robinrehbein/tangara/TEILE.md

# Teile und Schnittstellen

Gemeinsame Grundlage für Firmware, CAD und Platinen. Maße in mm. Werte mit „(prüfen)“ sind aus dem Gedächtnis und müssen gegen Datenblatt oder Herstellerseite geprüft werden.

## Phase-1-Prototyp

| Teil | Auswahl | Hinweis |
|---|---|---|
| Hauptboard | Waveshare ESP32-S3-Touch-AMOLED-1.8 | 1,8" AMOLED 368 × 448 (QSPI), geprüft: V1 SH8601 + FT3168, **V2 (seit 30.05.2026 lieferbar) CO5300 + CST820**; PMU AXP2101, Codec ES8311 mit NS4150B -> **nur Onboard-Lautsprecher, kein Kopfhörerausgang**, IMU QMI8658, RTC PCF85063, IO-Expander TCA9554, TF-Slot. Maße laut Wiki-Zeichnung **37,6 × 45,2 × 15,0** (mit Gehäuse; nackte Platine ungeprüft). Pads 1,27 mm: VBUS, GND, 3V3, GND, TXD, RXD, **SCL = GPIO14, SDA = GPIO15** (geteilter Bus, 2,2 kΩ Pull-ups onboard), GPIO17, 18, 38–42, USB D−/D+ = GPIO19/20. Klickrad-Vorschlag: INT = GPIO17, BTN = GPIO18. Keine Adresskollision mit 0x5A/0x5B. Details und Quellen: `docs/RECHERCHE.md`. |
| Klickrad-Modul | eigene Platine, siehe unten | Anschluss an die Waveshare-Pads: 3V3, GND, SDA = GPIO15, SCL = GPIO14, INT = GPIO17, BTN = GPIO18; I²C-Pull-ups liegen schon auf dem Board, auf dem Modul nicht bestücken |
| LRA | X-Achsen-LRA, 2–3 Typen zum Vergleichen | Bauform und Resonanzfrequenz je Typ notieren. Kandidaten: 4,5 × 12 × 3,0 (235 Hz), 9,5 × 9,5 × 3,5 (170 Hz), 8 × 15 × 3,0 (170 Hz), Herstellerangaben, siehe `docs/EINKAUFSLISTE.md` |
| Akku | LiPo 1S mit Schutzschaltung, Stecker passend zum Waveshare-Board (geprüft: MX1.25, 2-polig; Polung am Board prüfen) | Größe nach Gehäuse; Waveshare empfiehlt 3,85 × 24 × 28 mm, 400 mAh |
| Gehäuse | Prototyp-Gehäuse v1 (FDM-Druck) | Display oben, Klickrad unten, Hochformat |

## Klickrad-Modul (eigene Platine)

Runde Platine, die Touch-Rad, Mitteltaste und Haptik vereint. Der LRA sitzt direkt auf der Rückseite, damit der Tick genau unter dem Daumen spürbar ist.

**Mechanik**
- Platine rund, **Ø 32 mm**, Dicke 1,0 mm, **4 Lagen** (v1; **v2: 2 Lagen, 0,8 mm**, siehe Abschnitt „Klickrad v2 (Stand)“)
- Touch-Segmente vorne: Ring von **r = 6,5 bis r = 12,8 mm**, 8–12 Segmente
- Mitteltaste vorne: SMD-Taster mittig, max. 4 × 4 mm, Höhe ≤ 1,5 mm
- 3 Befestigungslöcher Ø 2,2 mm auf **r = 14,6 mm** bei 90°, 210° und 330° (0° = rechts, gegen den Uhrzeigersinn)
- Rückseite: Bauteile max. 1,5 mm hoch, plus LRA (aufgeklebt, Lötpads für die Litzen)
- Abdeckung vorne (gedruckt): Ø 30 mm, liegt direkt auf der Platine

- Stecker J1 auf der Rückseite bei 270° (unten): x ±4,9, y −14,7 … −8,1 relativ zur Modulmitte, höher als 1,5 mm (Höhe prüfen)
- LRA-Freifläche auf der Rückseite: x −8 … +8, y +3 … +9; LRA-Lötpads bei x ≈ −12,3
- 12 Segmente à 30°. Zuordnung (Mittenwinkel gegen den Uhrzeigersinn ab rechts, von vorne gesehen): ELE8 15°, ELE7 45°, ELE6 75°, ELE5 105°, ELE4 135°, ELE3 165°, ELE2 195°, ELE1 225°, ELE0 255°, ELE11 285°, ELE10 315°, ELE9 345°. Firmware: Segment 0 bei 105° (Bildschirmkonvention, im Uhrzeigersinn). Am echten Rad prüfen.

**Elektrik**
- Touch-Controller: **v2: AT42QT2120 (I²C 0x1C, Wheel-Modus) nach Tangara-Vorbild**; v1 nutzte MPR121 (0x5B)
- Haptik-Treiber: DRV2605L (I²C, Adresse 0x5A fest), LRA-Modus
- Mitteltaste: nach GND, Pull-up auf der MCU-Seite

**Änderung für das dünne Endgerät (Entscheidung nach `docs/DUENNBAU.md`):** JST-SH ist mit ca. 4 mm zu hoch. Klickrad v2 und Hauptplatine bekommen den **FFC-Stecker Molex 503480-0600** (0,5 mm, 6-pol., ca. 1,0 mm hoch, Bottom Contact) mit derselben Pinbelegung; Kabel Standard-FFC Typ A, sofern die Ausrichtung passt. Der LRA-Ausschnitt in der Hauptplatine ist Standard (LRA bis 3,0 mm); am Waveshare-Prototyp über eine FFC-Breakout-Platine. Mitteltaste v2 **kapazitiv** (AT42QT2120 Key 3), Pin 6 wird Reserve. Platine 0,8 mm, Rückseitenbauteile ≤ 0,8 mm, flacher LRA (z. B. Vybronics VL120628H, 12 × 6 × 2,0, prüfen), Abdeckung 0,6-mm-FR4.

**Stecker v1: JST-SH 1,0 mm, 6-polig** (v2: FPC/FFC, gleiche Belegung)

| Pin | Signal |
|---|---|
| 1 | 3V3 |
| 2 | GND |
| 3 | SDA |
| 4 | SCL |
| 5 | INT / CHANGE (AT42QT2120 bzw. MPR121, open drain, aktiv low) |
| 6 | BTN (Mitteltaste, aktiv low) |

DRV2605L-EN fest auf 3V3; Standby per I²C.

## Endgerät: Ziel-Maße (Entscheidung 2026-10-04: größer und dicker, damit die Hauptplatine routbar wird)

Der Entwurf mit 8,5 mm (`docs/DUENNBAU.md`, Variante A) hatte zu wenig Platinenfläche (1648 mm² verfügbar gegen 1824 mm² benötigt) und ließ die Hauptplatine nicht routen. Neues Ziel:

| Punkt | Entscheidung |
|---|---|
| Außenmaße | **ca. 44 × 100 × bis 10 mm** (Dicke genau festlegen, wenn die Bauteilhöhen feststehen) |
| Hauptplatine | ca. 41 × 97 mm, Dicke 1,0 mm (0,8 mm nur, wenn nötig), 4 Lagen, wenn das Routing es nicht verlangt sonst 6 Lagen |
| Display | **2,06" AMOLED 410 × 502, CO5300, QSPI** (ca. 315 ppi); mit Deckglas, Luft darunter ≥ 1,1 mm |
| MCU-Modul | ESP32-S31-WROOM-1 (18 × 25,5 × 3,1) oder -WROOM-3, wie es das Layout braucht; **Antenne darf nicht über die Platinenkante hinausragen** |
| Klinke | SJ-3506-SMT wie Tangara (6,0 mm) oder SJ-43504-SMT-TR (5,0 mm), keine Sonderlösung nötig |
| Akku | Pouch bis ca. 4,5 mm dick, größte Standardzelle, die neben dem LRA passt (Ziel ≥ 600 mAh) |
| LRA | X-Achse bis 3,0 mm, Ausschnitt in der Hauptplatine unter dem Klickrad |
| Klickrad | Platine Ø 32 mm, Abdeckung 0,6-mm-FR4 wie Tangara, Stecker Molex 503480-0600 |
| Front/Rückseite | Front 0,8-mm-Acryl oder Glas, Rückwand gedruckt oder FR4 |

## Endgerät (erster Entwurf, siehe `hardware/render/explosionsmodell.html`)

| Teil | Maße |
|---|---|
| Gehäuse außen | 42 × 95 × 12,2, Ecken r = 7, Wand 1,4, Trennfuge bei z = 6 |
| Display-Fenster | 30,2 × 36,7, Mitte bei y = +21 (Gehäusemitte = 0) |
| Klickrad-Öffnung | Ø 30,6, Mitte bei y = −27 |
| Klickrad-Abdeckung | Ø 30 / Ø 11,6, 1,95 dick |
| Hauptplatine | 38 × 89 × 1,0, Ecken r = 5 |
| Akku | ca. 34 × 40 × 4,6 (Platzhalter) |
| Schrauben | 4 × M2, bei (±15, ±40), Gewindeeinsätze im Innenrahmen |

**Abweichungen im CAD-Entwurf** (Details: `hardware/cad/README.md`)
- Ein/Aus-Taste auf z = 9,2 statt 10,3 (sonst zu dünne Wand über der Öffnung)
- Oberschale ohne Schraubdome (Display belegt die Stellen), Halt über Innenrahmen und 4 Rastnasen; ungeprüft
- Klickrad-Platine im Endgerät vorerst mit Distanzring und Klebeband. Offen: 3 Aussparungen in der Hauptplatine für eine Verschraubung.

## Hauptplatine Endgerät: festgelegte Chips

Grundsatz: so viel wie möglich vom Vorbild Tangara übernehmen (Hardware CERN-OHL-S-2.0, Firmware GPL-3.0; lokale Kopie für die Arbeit unter `/home/user/tangara-ref/`, nicht im Repo).

| Funktion | Chip | Herkunft |
|---|---|---|
| MCU, WLAN 6, Bluetooth Classic + LE Audio, USB-HS-OTG | ESP32-S31-WROOM-1 (3,1 mm hoch, 16 MB PSRAM; Pins prüfen), sonst WROOM-3 | neu (Tangara: ESP32-WROVER-E) |
| DAC + Kopfhörerverstärker (Class H) | **Cirrus CS43131** (QFN-40, 0,8 mm hoch), 22,5792-MHz-Quarz am DAC, DAC ist I²S-Master; Plan B: CS43198 + OPA1622 | neu, Begründung in `docs/AUDIO.md` (125 dB Dynamik statt ca. 105 dB, ca. 70 mW weniger Ruheverbrauch) |
| 1,8 V für den DAC | LDO, ca. 60 mA Reserve | neu |
| Klinkenbuchse | SJ-43504-SMT-TR (5,0 mm hoch), in Randausschnitt der Platine; ESD D5V0L2B3T-7 wie Tangara | angepasst (Tangara: SJ-3506-SMT, 6,0 mm) |
| LiPo-Lader mit Power-Path | MCP73871 | Tangara |
| 3V3 | TLV75533 | Tangara |
| USB-C-Buchse | USB4510-03-1-A | Tangara |
| USB-Audio-Host (Rollenumschaltung, 5 V) | TUSB320LAI, TPS61023, TPS2553 | neu |
| Akkustand | MAX17048 (I²C 0x36) | neu (bei Tangara über den SAMD21) |
| Touch-Rad (Klickrad-Modul v2) | AT42QT2120 (I²C 0x1C) | Tangara |
| Haptik (Klickrad-Modul) | DRV2605L (I²C 0x5A) | Tangara |

Nicht übernommen: SAMD21-Co-Prozessor und SD-Multiplexer (der S31 hat selbst USB), Display ST7735 (wir nutzen das 1,8"-AMOLED).

## Bestellstatus

Noch nichts bestellt.

**Dicke (Entscheidung):** Ziel **bis 10 mm** (statt 11 mm). Stapel: Front 0,8 + Display ca. 1,3 + Luft ≥ 1,1 + Platine 1,0 + Akku + Rückwand ca. 1 mm. Dafür Akku eher ≤ 4,0 mm und Klinke 5,0 mm (SJ-43504-SMT-TR). Prüfen, sobald die Bauteilhöhen feststehen; reicht es nicht, wird das hier begründet geändert.

## Klickrad v2 (Stand 2026-10-04, ersetzt widersprüchliche Angaben oben)

Fertig in `hardware/pcb/klickrad/` (ERC 0, DRC 0 Fehler, nichts gebaut oder gemessen). Maßgeblich gegenüber den v1-Angaben im Abschnitt „Klickrad-Modul“:

- Ø 32 mm, **2 Lagen, 0,8 mm** (v1: 4 Lagen, 1,0 mm)
- Touch **AT42QT2120, I²C 0x1C**, Wheel-Modus: Key 0–2 Wheel, Key 3 kapazitive Mitte (r 2,5 mm), Key 4 Guard. Wheel-Position 0 oben, steigend gegen den Uhrzeigersinn; Stecker bei 270° = Position 128 (aus Tangara-Footprint gerechnet, nicht gemessen). **Firmware-Konvention und Segment-Offset daran anpassen.**
- Haptik DRV2605L (0x5A), LRA-Freifläche 16 × 6 mm, Mitte 6 mm über der Radmitte, LRA bis 3,0 mm; LRA-Pads TP1/TP2 auf der **Ostseite**
- Stecker Molex 503480-0600 auf der Rückseite bei 270°, Pin 6 offen, I²C-Pull-ups nicht bestückt
- Rückseitenbauteile bis 1,1 mm (U2 DRV2605L VSSOP-10), Stecker 1,0 mm; damit über der 0,8-mm-Vorgabe
- Abdeckung: eigenes Projekt `abdeckung/`, 0,6 mm FR4, Ø 30
- Ein 10 × 10 × 1,0-LRA passt in dieser Revision nicht

## Hauptplatine Endgerät: Stand 2026-10-05, Rev. 3b (maßgeblich, aus `hardware/pcb/hauptplatine/README.md`)

41 × 97 × 1,0 mm, 4 Lagen, Ecken r = 4, DRC/ERC 0. Maße für das Gehäuse (Platinenmitte = 0, Blick von vorn): Klickrad-Mitte (0, −25); LRA-Ausschnitt 14 × 10 mm um (0, −19); Klinke SJ-43504 x = −12 (Randschlitz 6,8 mm); USB-C x = +9 (Ausschnitt 9,24 × 6 mm); WROOM-1 Rückseite Mitte (6,5; 37,5), Antennen-Keepout x 12,9…20,5, y 28,2…46,8; microSD Mitte (−13,7; 37,5), Einschub von links; Klickrad-Stecker J21 (0; −46,2); Display-Stecker J20 = Molex 5034803000 (0; −0,65), Körper x ±8,35, y −2,4…+1,7, 1,0 mm hoch (Rev. 3b: ersetzt Hirose FH12-30S-0.5SH(55), laut Digi-Key 2,0 mm hoch, Review H4; Footprint-Nagelpads ungeprüft); SW1 Rückseite (15; −30); neu SW2 (BOOT) Rückseite (−18,05; 16,0) und SW3 (EN) Rückseite (−18,05; 9,0), von hinten zu drücken (Rückwand braucht dort Löcher, Review H8); Akku-Anschluss (−12,5; 28,8); Befestigungslöcher Ø 1,8 bei (−18,2; 46,2), (18,2; −46,2), (−18,2; −46,2); Akkufach Rückseite x −16…16, y −12…26,5. Rückzone bei 10 mm Gerätedicke 4,05 mm (Zelle höchstens ca. 3,7 mm). Teile über 3 mm: nur Klinke, USB-C, Modul.

## Nachtrag Klickrad J1 (2026-10-05)

J1 nutzt jetzt das Landmuster von J21 der Hauptplatine (Molex 503480-0600, Signalpads 0,3 × 0,7, Nagelpads 0,8 × 1,0 bei x ±2,045), ungeprüft gegen die Molex-Zeichnung. J1 sitzt bei (0; −10,8) auf der Klickrad-Rückseite, Kabelmündung nach Süden, Pin 1 bei x +1,25; Pin 1 ↔ Pin 1 ohne Kreuzung, Kabel gerade (Typ A oder B), Mündungen 6,4 mm auseinander (nicht 3,5 mm). LRA-Freifläche jetzt 14 × 6 mm (x ±7): der 8 × 15 × 3,0-LRA oben passt nicht mehr; zulässig sind LRAs bis ca. 13 × 9 × 3 mm laut CAD. Der Text im Hauptplatine-README zum Klickrad-Anschluss (Mündung nach unten) ist teilweise überholt.
