robinrehbein/tangara/hardware/render/explosionsmodell.html

# Nano-Player Explosionsmodell · Endgerät v3

Endgerät v3: 44 × 100 × 10 mm iPod nano 5. Gen.: 38,7 × 90,7 × 6,2 mm Display: 2,06" AMOLED, 410 × 502

Vorne Schräg Seite Hinten

Ziehen zum Drehen · Scrollen oder Zwei-Finger zum Zoomen · Teil antippen für Details

Zerlegen

55 %

Zusammenbauen Ganz zerlegen Alle zeigen

Gehäusefarbe

Teile

Stand v3 für Hauptplatine Rev. 3b und Klickrad J1 (2026-10-05, ungeprüft an Hardware). Rahmen, Rückwand, Frontplatte und Abdeckung sind die echten STL aus dem CAD; alle anderen Teile sind Blöcke aus den Maßen in params.py. Details: README.md.
