robinrehbein/tangara/hardware/cad/vorschau/endgeraet_distanzring.png

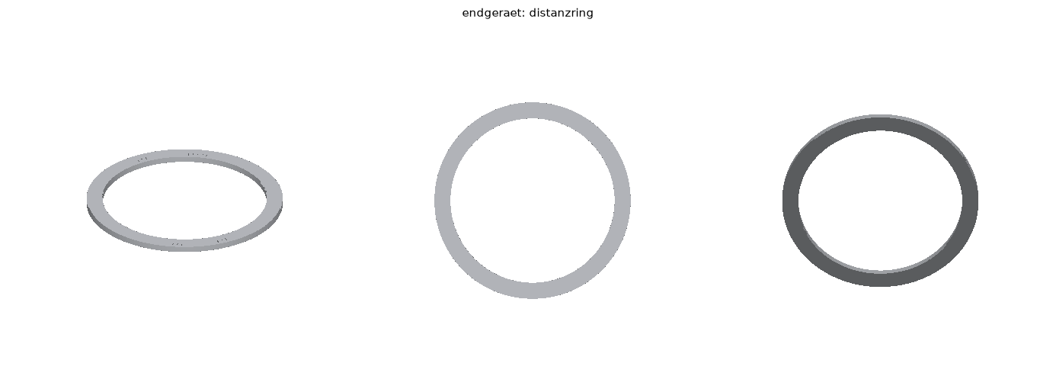
hardware/cad/vorschau/endgeraet_distanzring.png
