robinrehbein/tangara/hardware/cad/vorschau/endgeraet_explosion.png

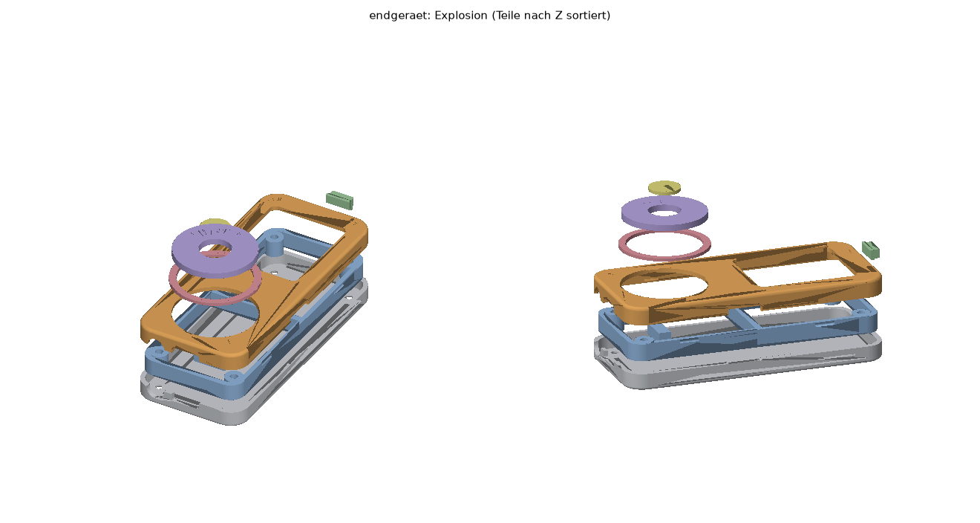
hardware/cad/vorschau/endgeraet_explosion.png
