robinrehbein/tangara/hardware/cad/vorschau/endgeraet_innenrahmen.png

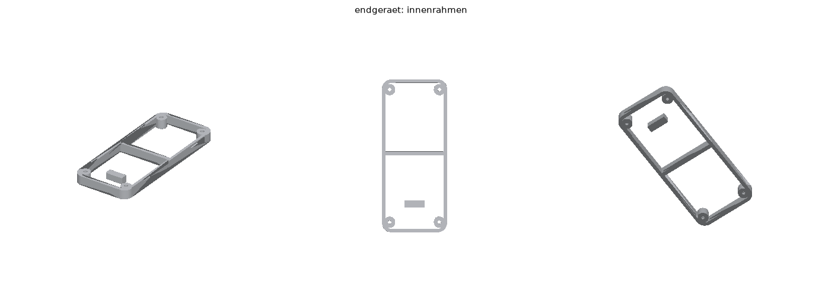
hardware/cad/vorschau/endgeraet_innenrahmen.png
