robinrehbein/tangara/hardware/cad/vorschau/endgeraet_power_taste.png

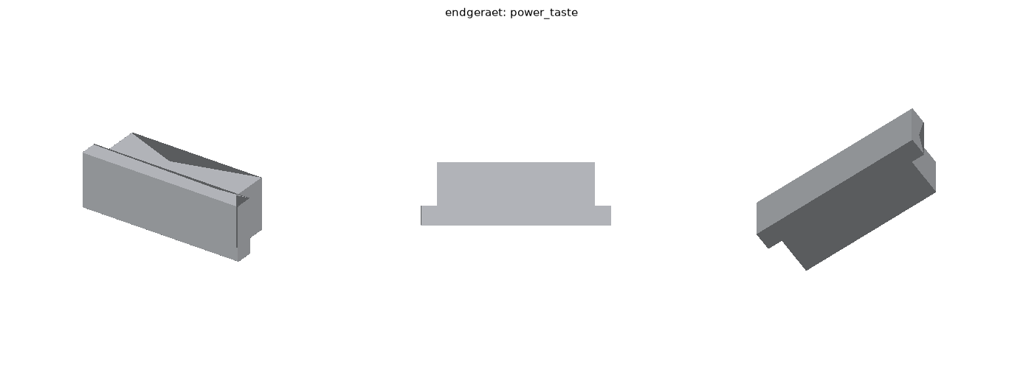
hardware/cad/vorschau/endgeraet_power_taste.png
