robinrehbein/tangara/hardware/cad/vorschau/endgeraet_v2_explosion.png

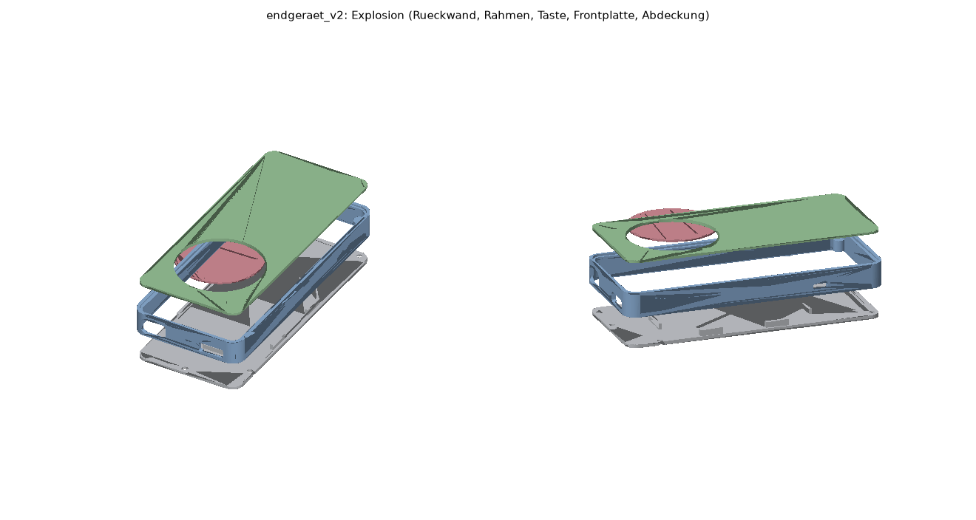
hardware/cad/vorschau/endgeraet_v2_explosion.png
