robinrehbein/tangara/hardware/cad/vorschau/endgeraet_v2_schnitt.png

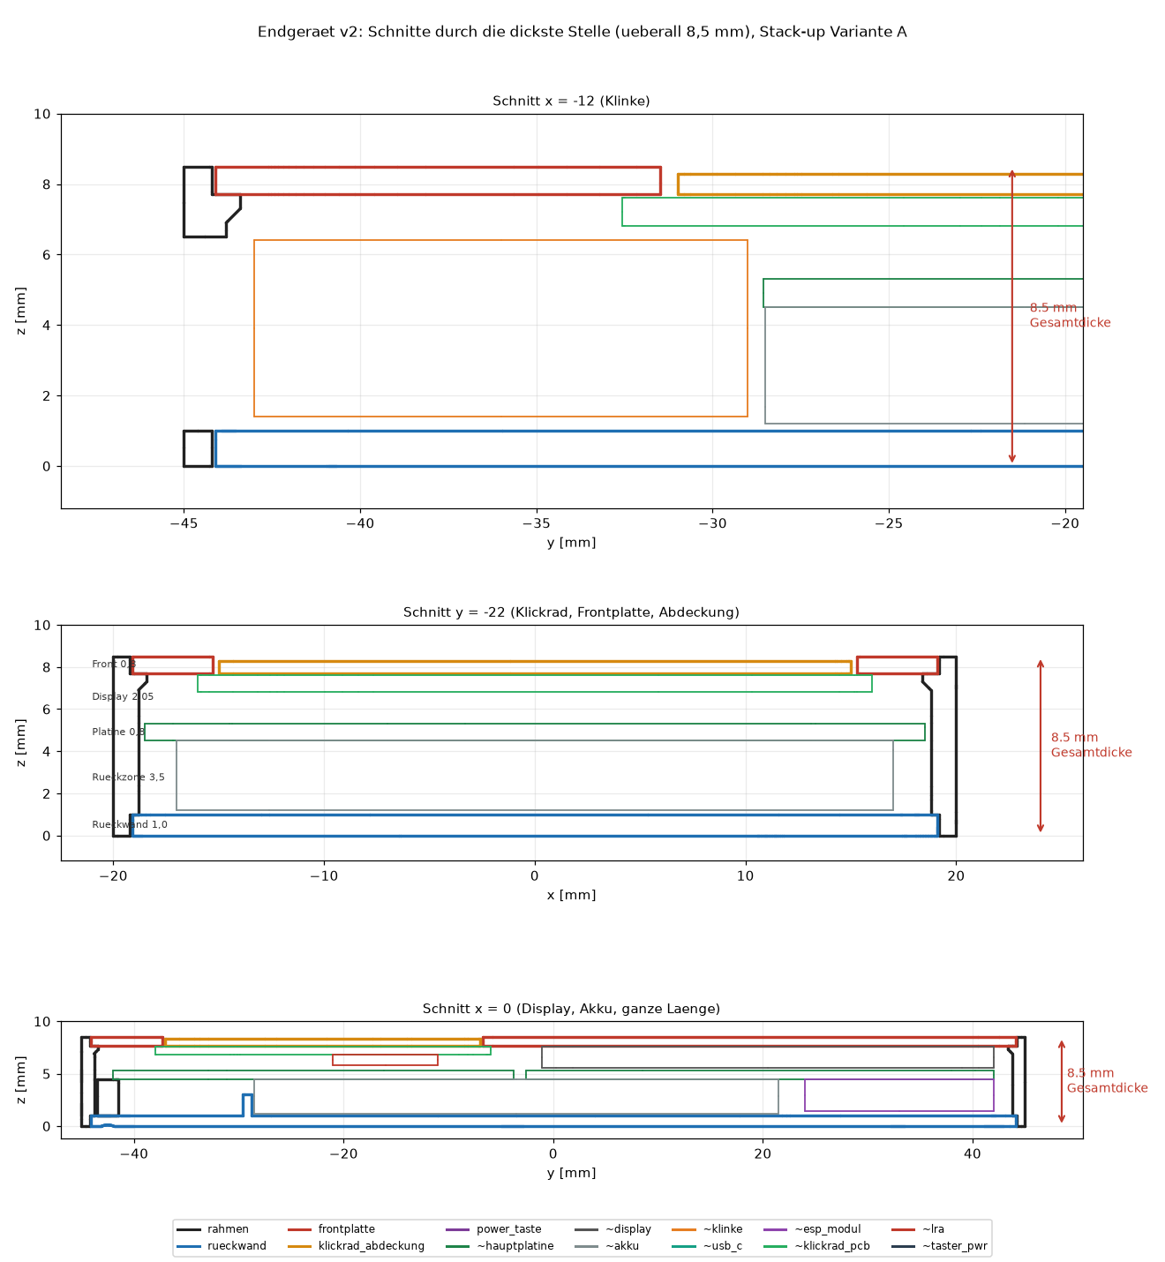
hardware/cad/vorschau/endgeraet_v2_schnitt.png
