robinrehbein/tangara/hardware/cad/vorschau/endgeraet_v2_zuschnitt_dxf.png

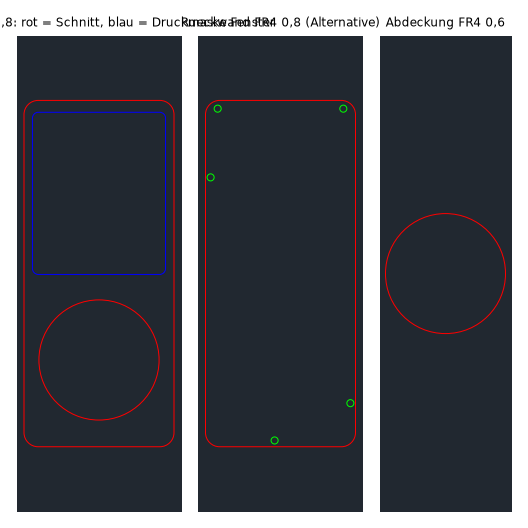
hardware/cad/vorschau/endgeraet_v2_zuschnitt_dxf.png
