robinrehbein/tangara/hardware/cad/vorschau/endgeraet_v3_rueckwand_hinten.png

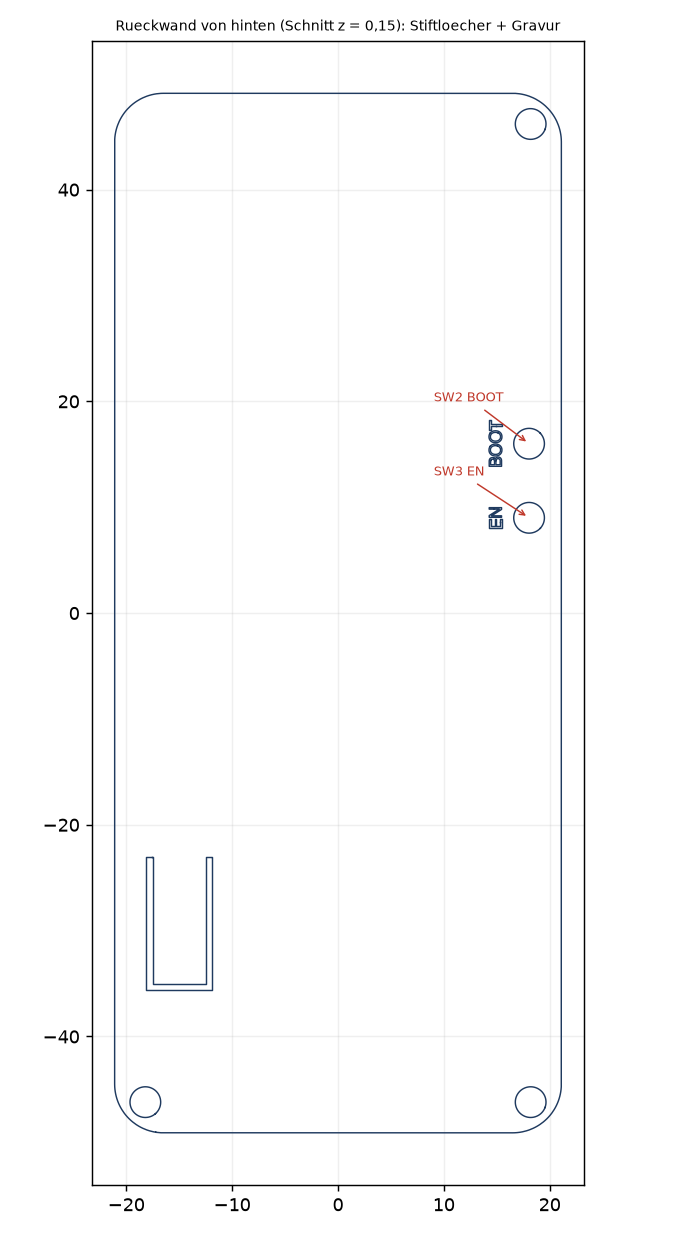
hardware/cad/vorschau/endgeraet_v3_rueckwand_hinten.png
