robinrehbein/tangara/hardware/cad/vorschau/endgeraet_v3_schnitt.png

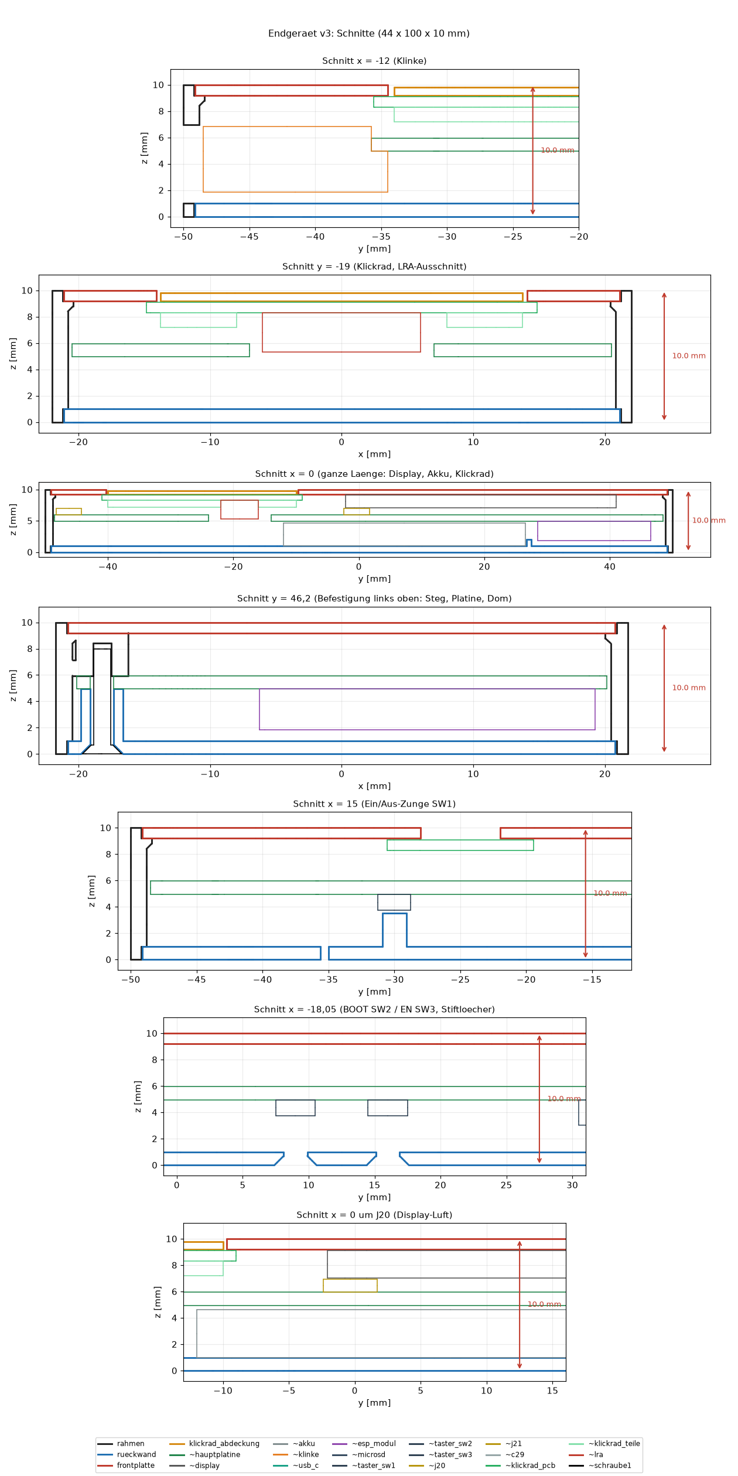
hardware/cad/vorschau/endgeraet_v3_schnitt.png
