robinrehbein/tangara/hardware/cad/vorschau/endgeraet_v3_zuschnitt_dxf.png

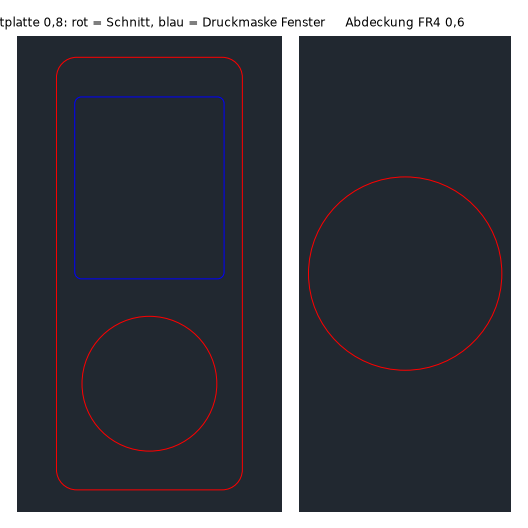
hardware/cad/vorschau/endgeraet_v3_zuschnitt_dxf.png
