robinrehbein/tangara/hardware/cad/vorschau/endgeraet_zusammenbau.png

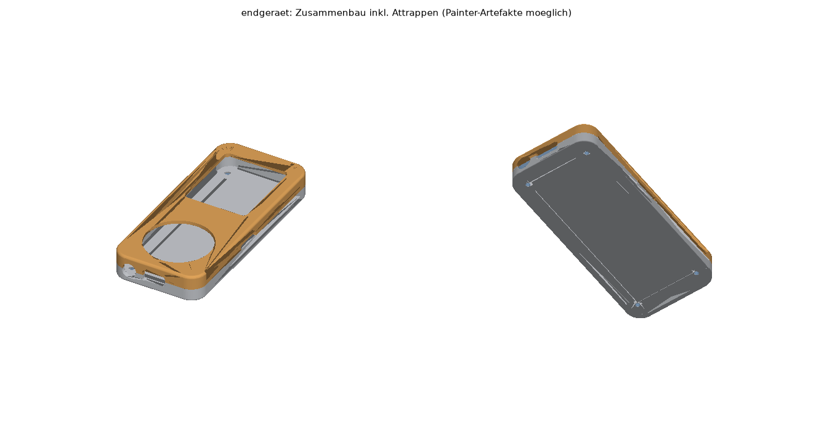
hardware/cad/vorschau/endgeraet_zusammenbau.png
