robinrehbein/tangara/hardware/cad/vorschau/prototyp_explosion.png

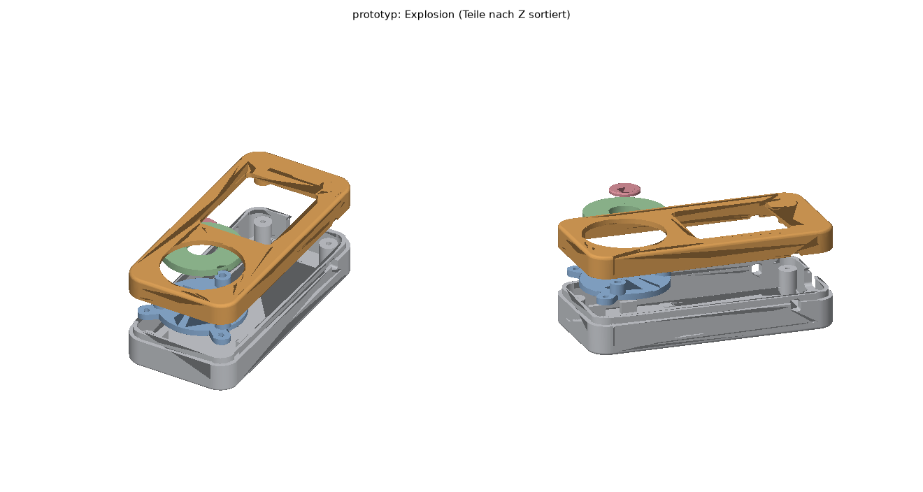
hardware/cad/vorschau/prototyp_explosion.png
