robinrehbein/tangara/hardware/cad/vorschau/prototyp_klickrad_halter.png

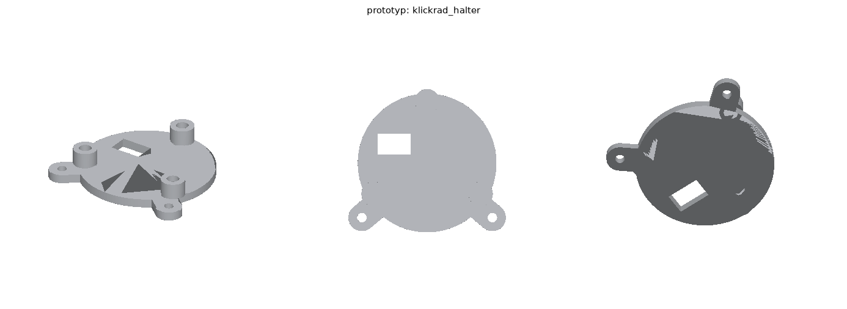
hardware/cad/vorschau/prototyp_klickrad_halter.png
