robinrehbein/tangara/hardware/pcb/hauptplatine/vorschau/oberseite_2d.png

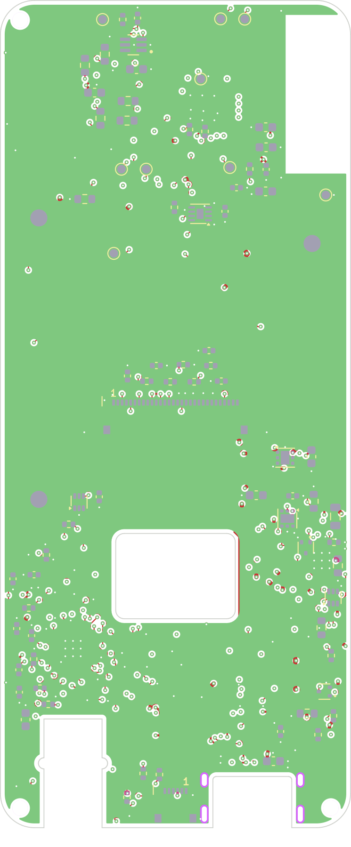
hardware/pcb/hauptplatine/vorschau/oberseite_2d.png
