robinrehbein/tangara/hardware/pcb/hauptplatine/vorschau/oberseite_3d.png

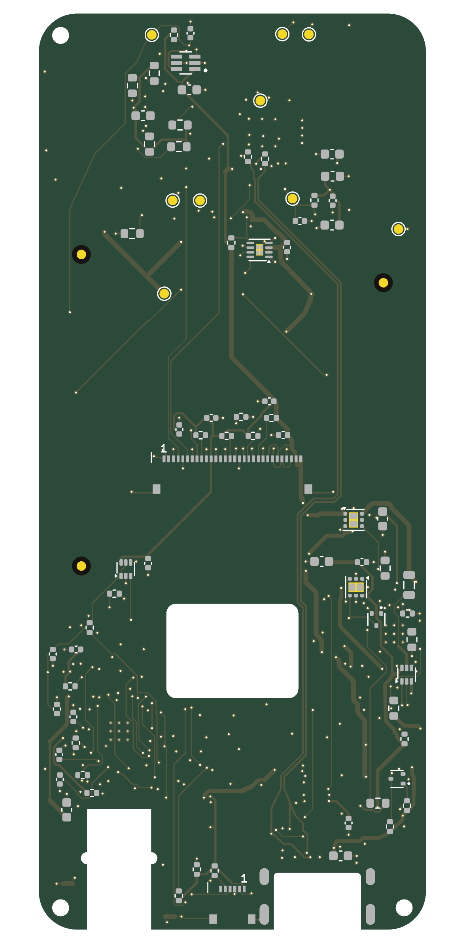
hardware/pcb/hauptplatine/vorschau/oberseite_3d.png
