robinrehbein/tangara/hardware/pcb/hauptplatine/vorschau/unterseite_2d.png

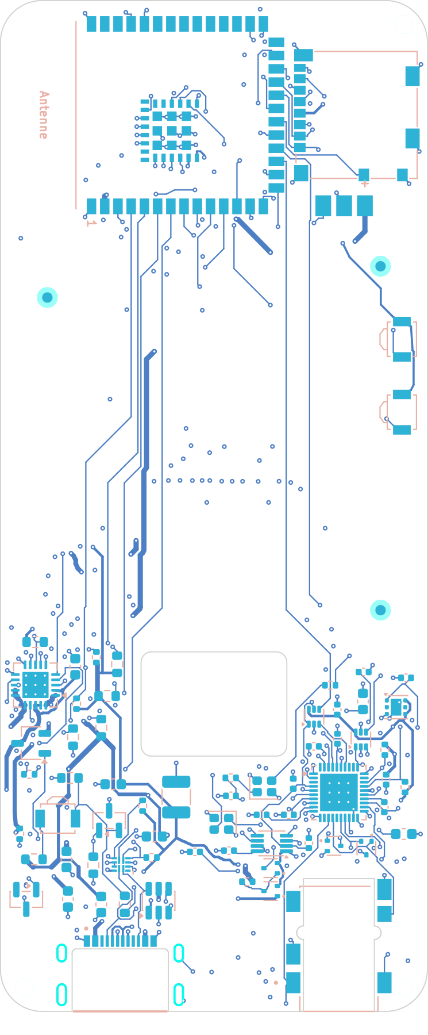
hardware/pcb/hauptplatine/vorschau/unterseite_2d.png
