robinrehbein/tangara/hardware/pcb/hauptplatine/vorschau/unterseite_3d.png

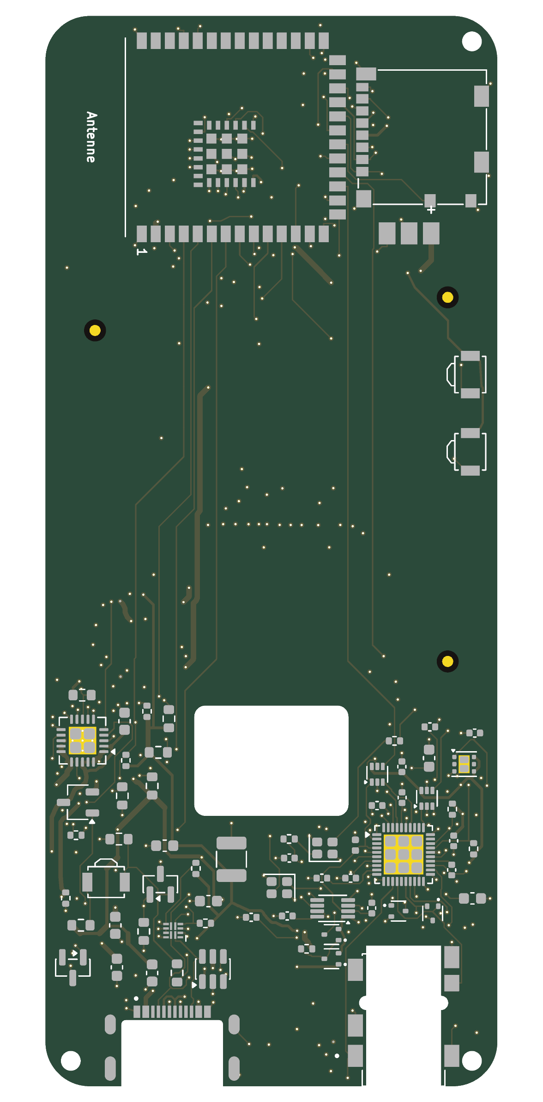
hardware/pcb/hauptplatine/vorschau/unterseite_3d.png
