robinrehbein/tangara/hardware/pcb/klickrad/abdeckung/vorschau/abdeckung.png

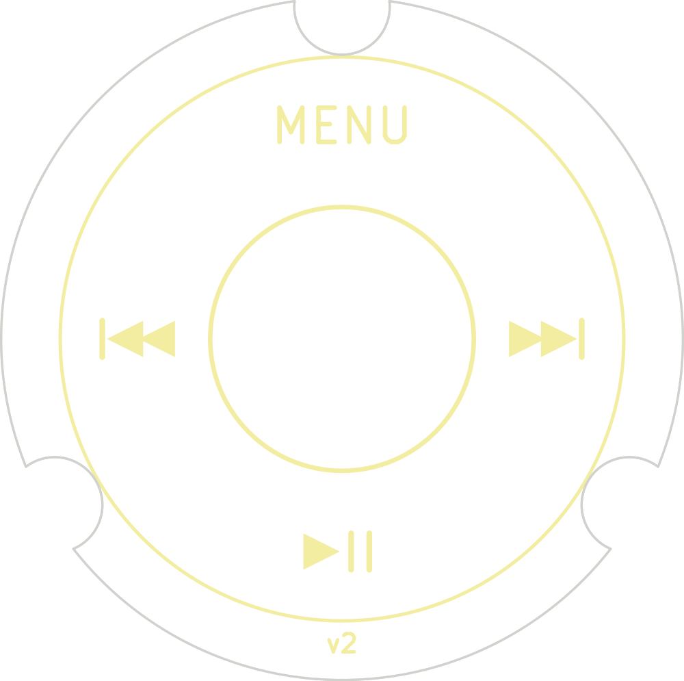
hardware/pcb/klickrad/abdeckung/vorschau/abdeckung.png
