robinrehbein/tangara/hardware/pcb/klickrad/vorschau/3d_hinten.png

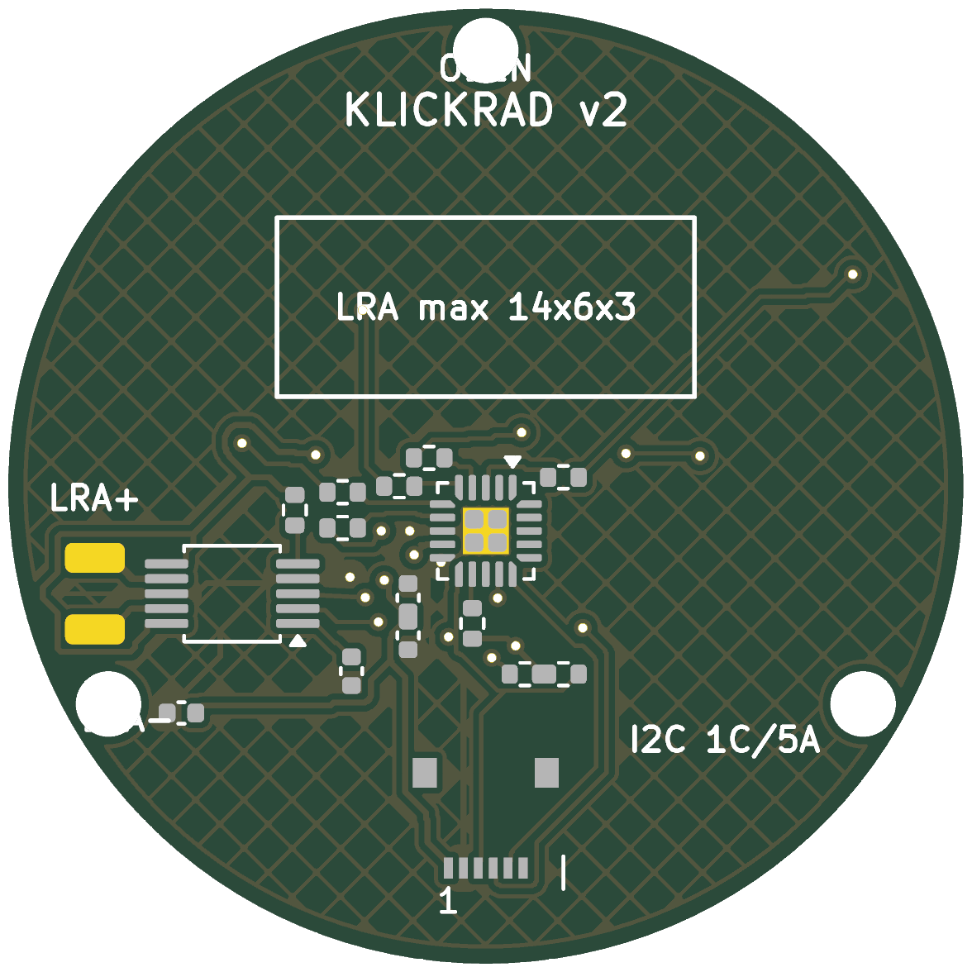
hardware/pcb/klickrad/vorschau/3d_hinten.png
