robinrehbein/tangara/hardware/pcb/klickrad/vorschau/3d_vorne.png

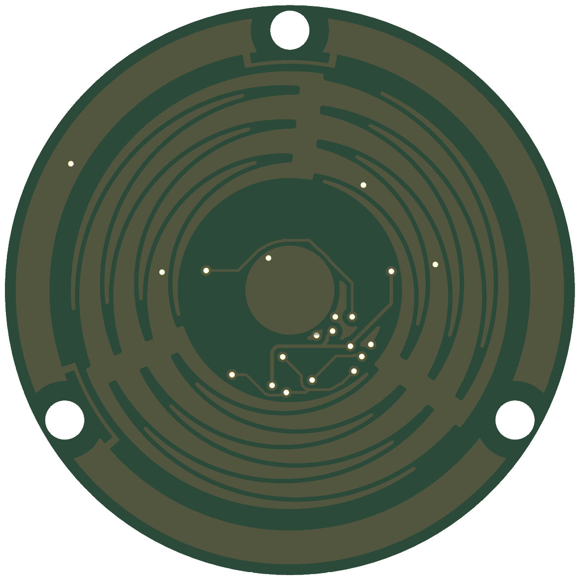
hardware/pcb/klickrad/vorschau/3d_vorne.png
