robinrehbein/tangara/hardware/pcb/klickrad/vorschau/kupfer.png

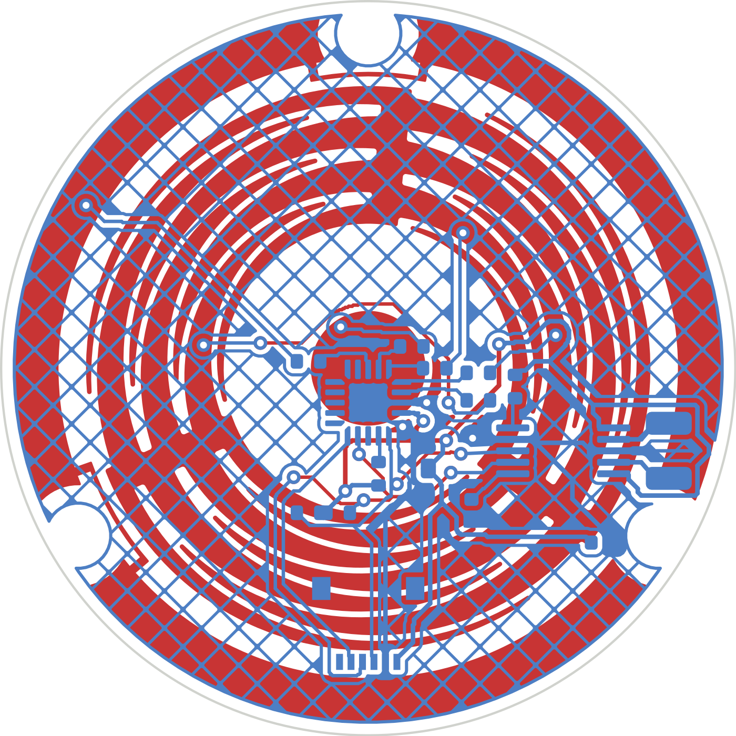
hardware/pcb/klickrad/vorschau/kupfer.png
