robinrehbein/tangara/hardware/pcb/klickrad/vorschau/rueckseite.png

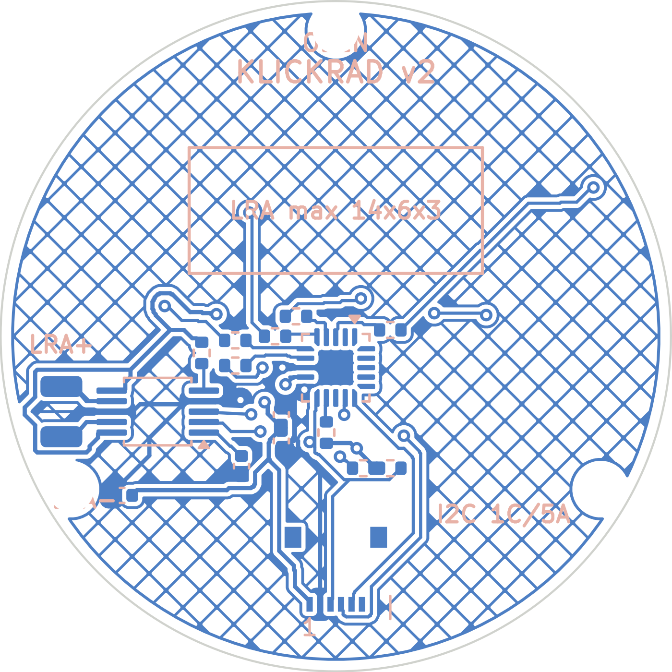
hardware/pcb/klickrad/vorschau/rueckseite.png
