robinrehbein/tangara/hardware/pcb/klickrad/vorschau/schaltplan.png

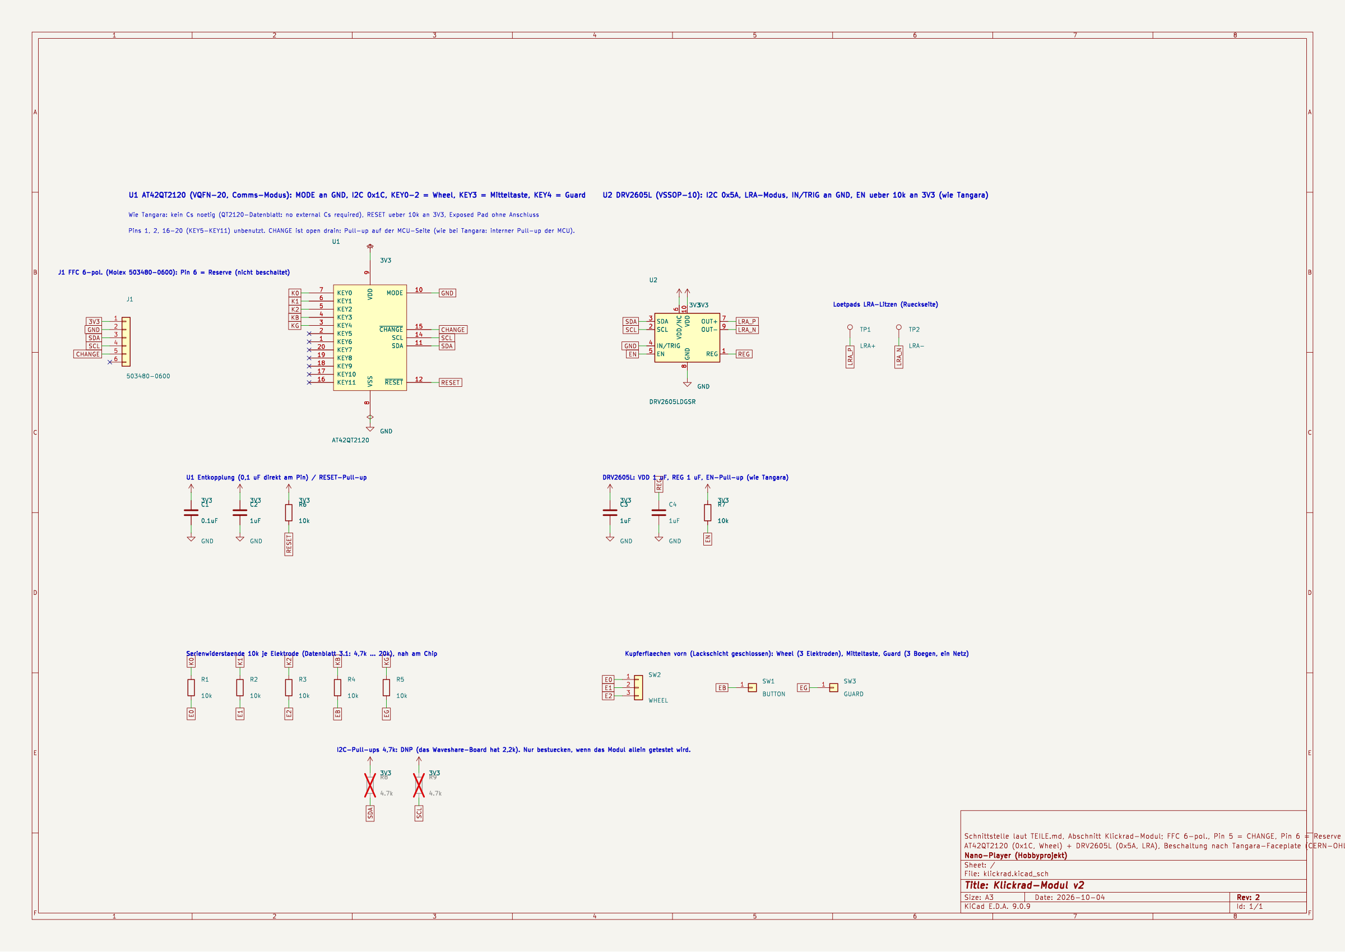
hardware/pcb/klickrad/vorschau/schaltplan.png
