robinrehbein/tangara/hardware/render/vorschau/explodiert.png

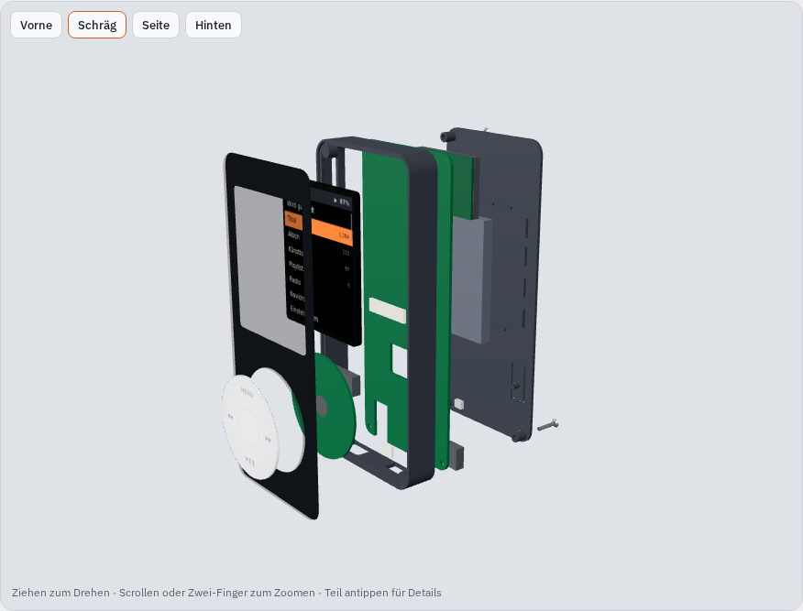
hardware/render/vorschau/explodiert.png
