robinrehbein/tangara/hardware/render/vorschau/explodiert_hinten.png

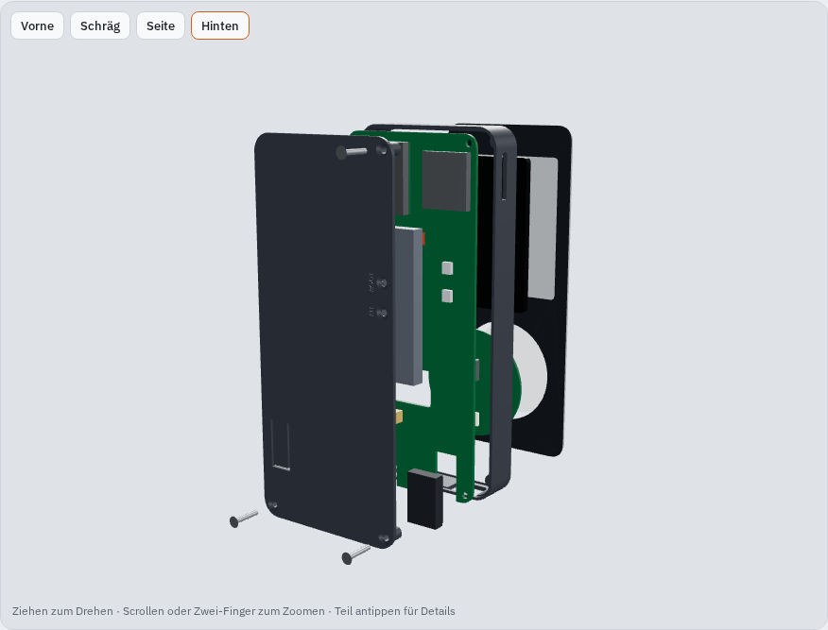
hardware/render/vorschau/explodiert_hinten.png
