robinrehbein/tangara/hardware/render/vorschau/explodiert_seite.png

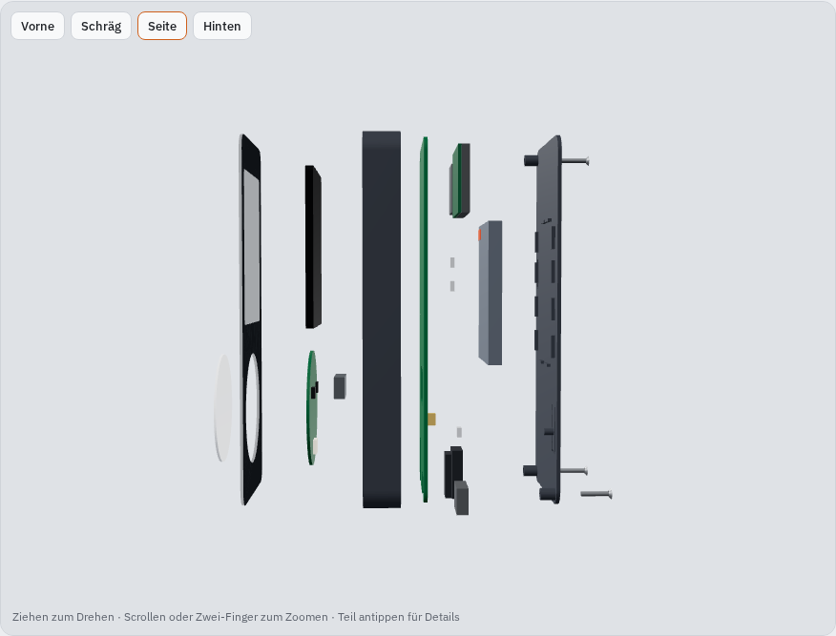
hardware/render/vorschau/explodiert_seite.png
