robinrehbein/tangara/hardware/render/vorschau/farbe_orange.png

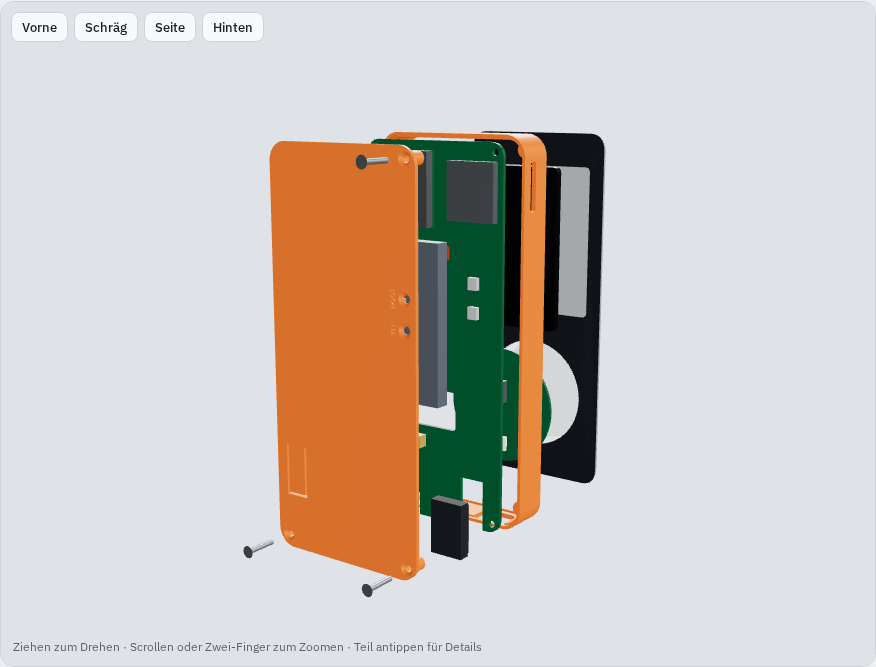
hardware/render/vorschau/farbe_orange.png
