robinrehbein/tangara/hardware/render/vorschau/teil_gewaehlt.png

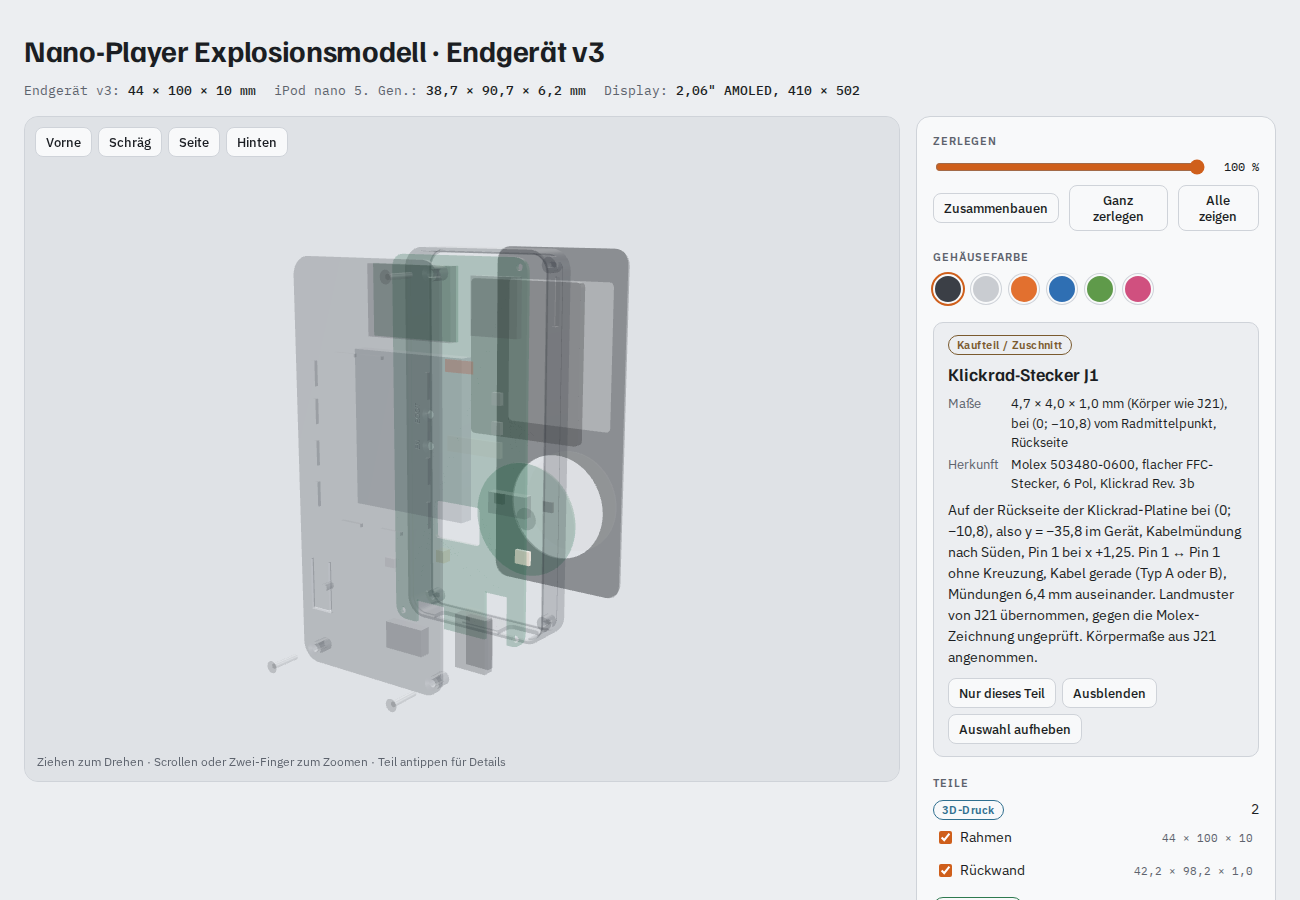
hardware/render/vorschau/teil_gewaehlt.png
