robinrehbein/tangara/hardware/render/vorschau/zusammengebaut.png

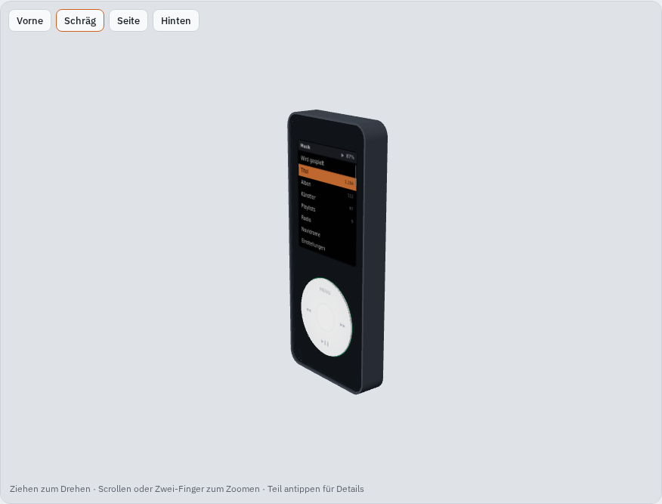
hardware/render/vorschau/zusammengebaut.png
