robinrehbein/tangara/hardware/render/vorschau/zusammengebaut_vorne.png

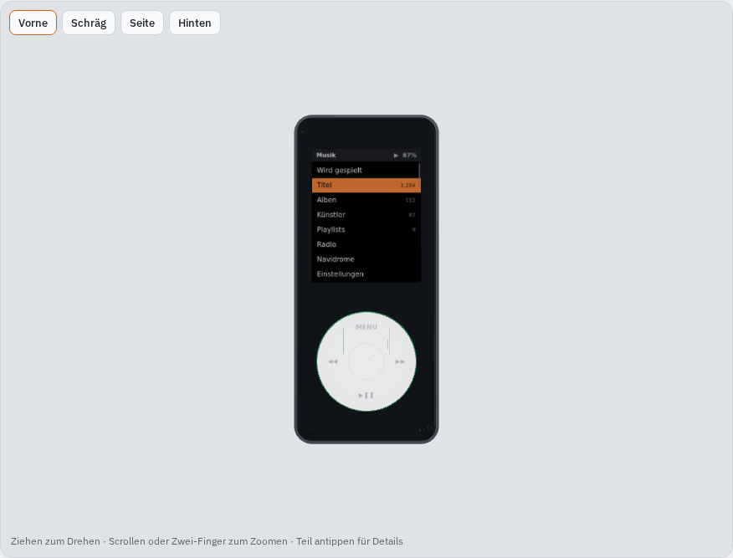
hardware/render/vorschau/zusammengebaut_vorne.png
