robinrehbein/tangara/hardware/pcb/klickrad/tools/route_order.txt

LRA_P,E2,EN,EG,GND,RESET,LRA_N,REG,K1,KB,K0,CHANGE,EB,SCL,E1,3V3,SDA,KG,K2,E0
