robinrehbein/tangara/hardware/pcb/klickrad/fertigung/klickrad_v2_bom_jlcpcb.csv

Comment | Designator | Footprint | LCSC Part #
AT42QT2120 | U1 | VQFN-20-1EP_3x3mm_P0.45mm_EP1.55x1.55mm | C617900
DRV2605LDGSR | U2 | VSSOP-10_3x3mm_P0.5mm | C527464
0.1uF | C1 | C_0402_1005Metric | C1525
1uF | C2, C3, C4 | C_0402_1005Metric | C52923
10k | R1, R2, R3, R4, R5, R6, R7 | R_0402_1005Metric | C25744
