robinrehbein/tangara/hardware/cad/stl/endgeraet_v3/rueckwand.stl

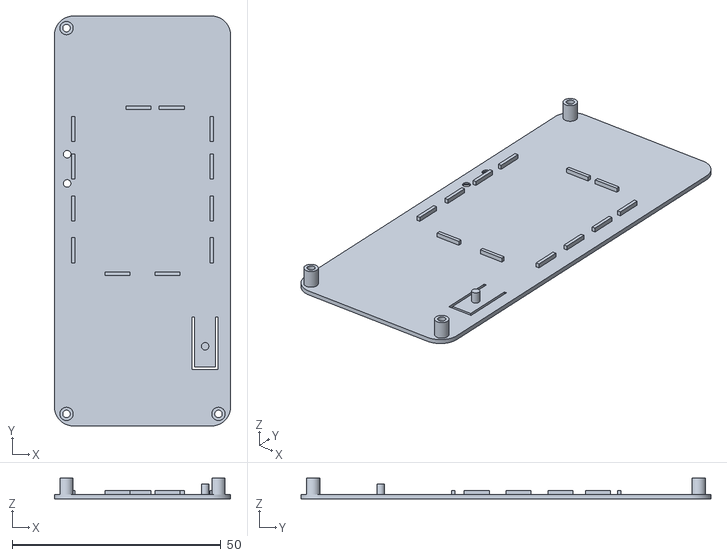
[picture p31: CAD file, 2026-10-05]
hardware/cad/stl/endgeraet_v3/rueckwand.stl
42.2 x 98.2 x 4.95
