robinrehbein/tangara/hardware/cad/stl/prototyp/klickrad_abdeckung.stl

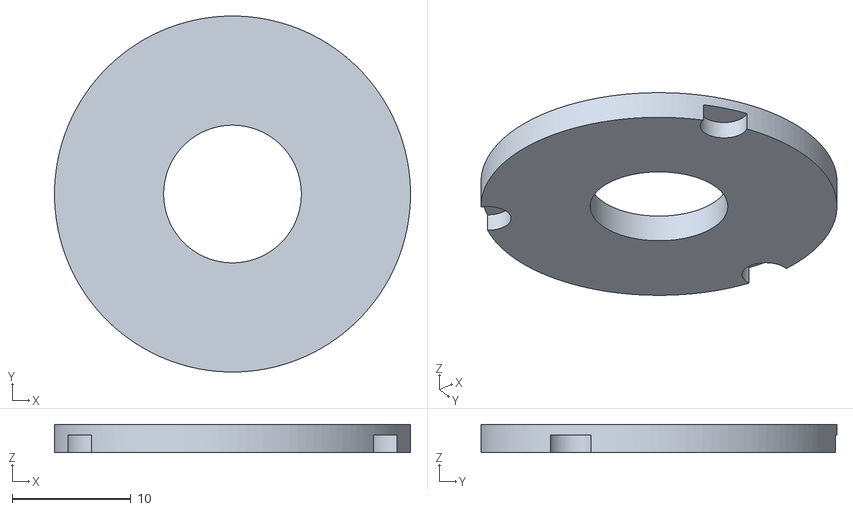
[picture p32: CAD file, 2026-10-04]
hardware/cad/stl/prototyp/klickrad_abdeckung.stl
30.0 x 30.0 x 2.40
