robinrehbein/tangara/hardware/cad/stl/endgeraet_v3/rahmen_einsatz.stl

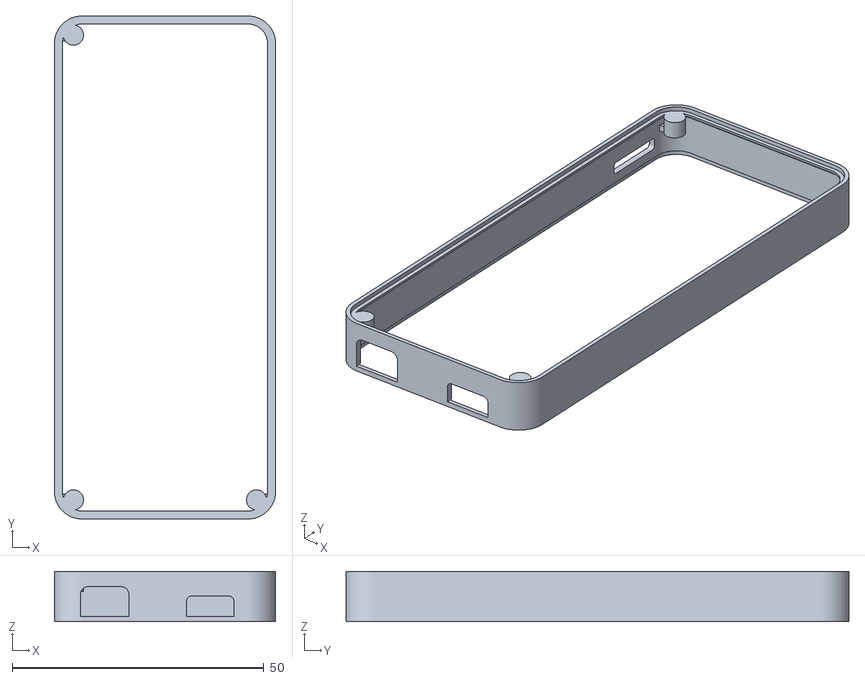
[picture p33: CAD file, 2026-10-05]
hardware/cad/stl/endgeraet_v3/rahmen_einsatz.stl
44.0 x 100.0 x 10.0
