robinrehbein/tangara/hardware/cad/stl/prototyp/vorderschale.stl

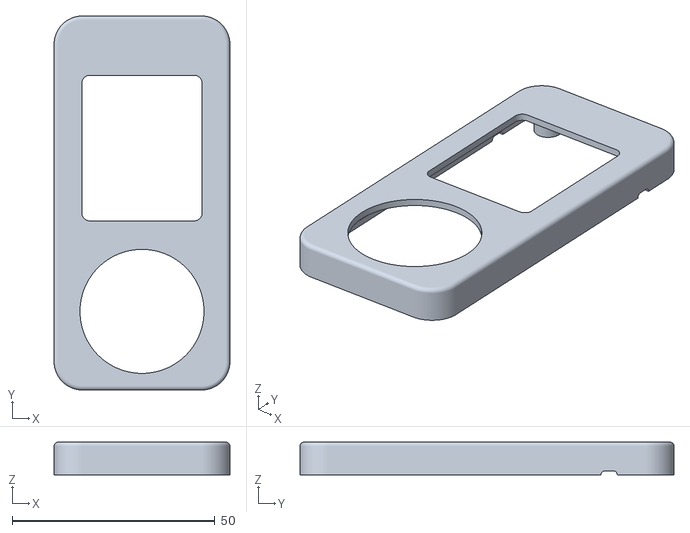
[picture p34: CAD file, 2026-10-04]
hardware/cad/stl/prototyp/vorderschale.stl
43.4 x 92.3 x 8.10
