robinrehbein/tangara/hardware/cad/stl/endgeraet_v3/frontplatte.stl

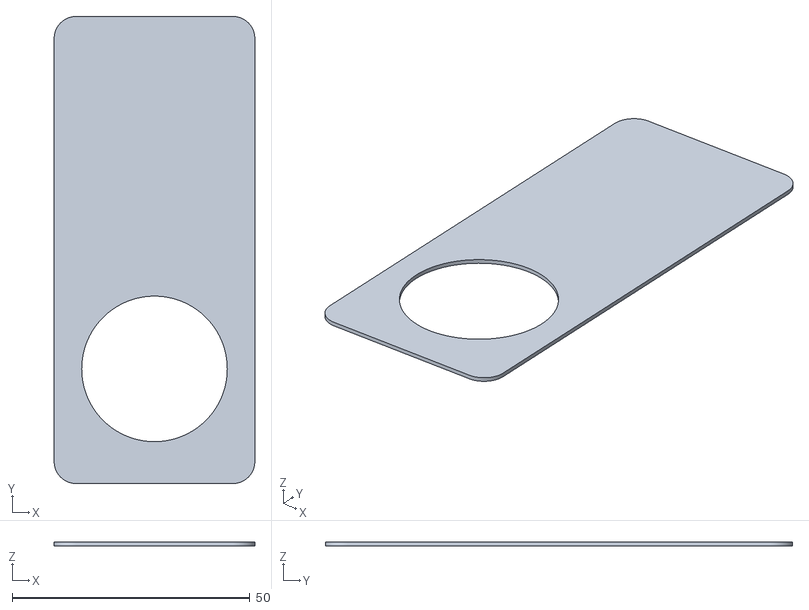
[picture p35: CAD file, 2026-10-04]
hardware/cad/stl/endgeraet_v3/frontplatte.stl
42.2 x 98.2 x 0.8
