robinrehbein/tangara/hardware/cad/stl/prototyp/klickrad_halter.stl

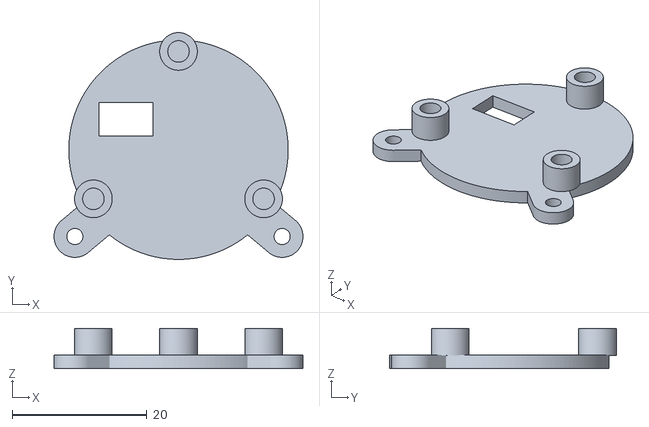
[picture p36: CAD file, 2026-10-04]
hardware/cad/stl/prototyp/klickrad_halter.stl
37.0 x 33.7 x 6.00
