robinrehbein/tangara/hardware/cad/stl/endgeraet_v3/klickrad_abdeckung.stl

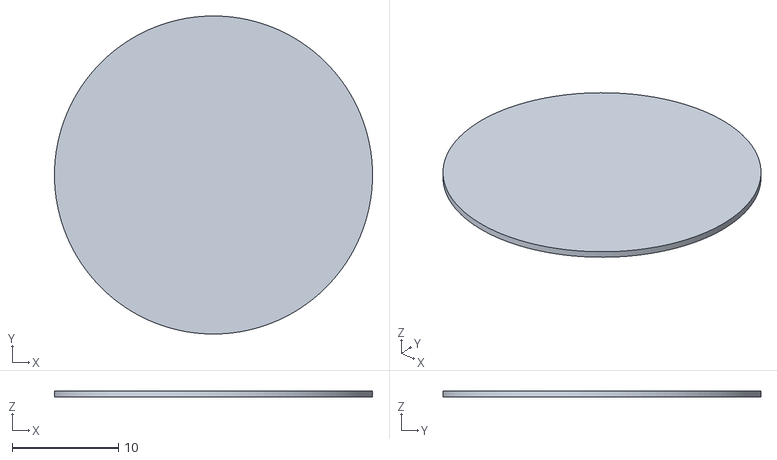
[picture p37: CAD file, 2026-10-04]
hardware/cad/stl/endgeraet_v3/klickrad_abdeckung.stl
30.0 x 30.0 x 0.6
