robinrehbein/tangara/hardware/cad/stl/prototyp/mitteltaste.stl

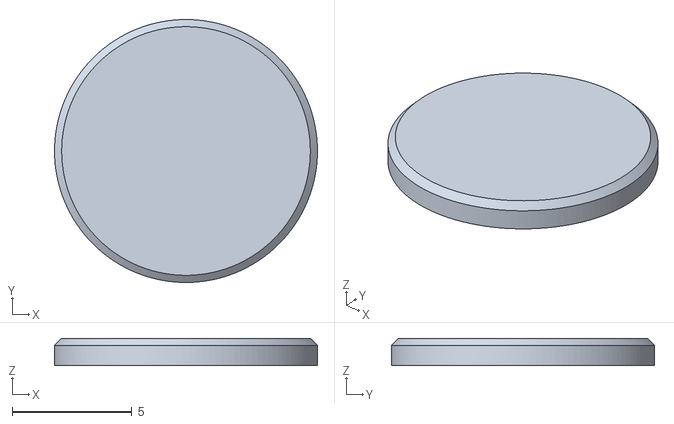
[picture p38: CAD file, 2026-10-04]
hardware/cad/stl/prototyp/mitteltaste.stl
11.0 x 11.0 x 1.15
