robinrehbein/tangara/hardware/cad/stl/endgeraet_v3/rahmen.stl

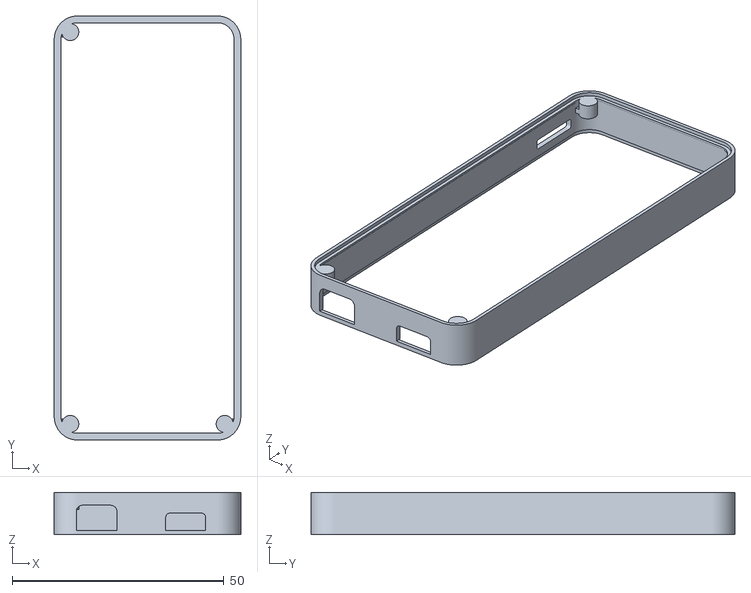
[picture p39: CAD file, 2026-10-04]
hardware/cad/stl/endgeraet_v3/rahmen.stl
44.0 x 100.0 x 10.0
