robinrehbein/tangara/hardware/cad/stl/prototyp/rueckschale.stl

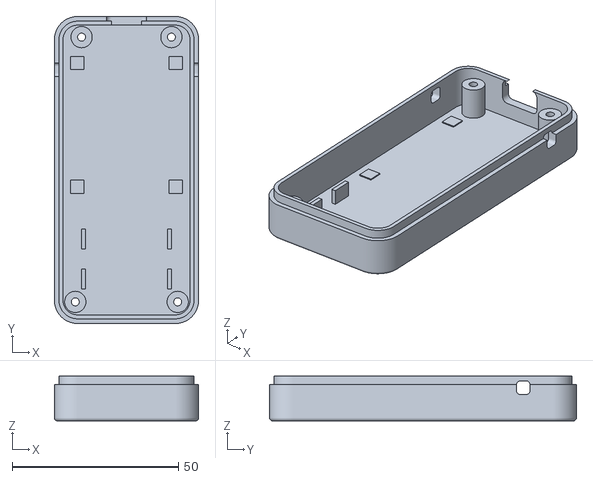
[picture p40: CAD file, 2026-10-04]
hardware/cad/stl/prototyp/rueckschale.stl
43.4 x 92.3 x 13.5
