robinrehbein/tangara/hardware/cad/dxf/endgeraet_v2/rueckwand_fr4.dxf

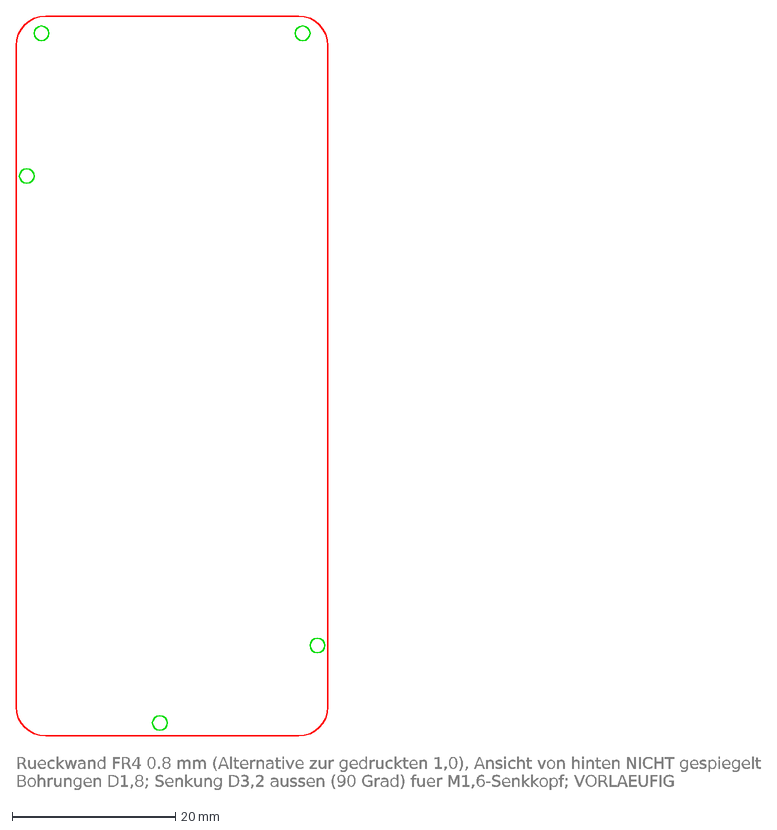
[picture p41: CAD file, 2026-10-04, an earlier design]
hardware/cad/dxf/endgeraet_v2/rueckwand_fr4.dxf
Rueckwand FR4 0.8 mm (Alternative zur gedruckten 1,0), Ansicht von hinten NICHT gespiegelt
Bohrungen D1,8; Senkung D3,2 aussen (90 Grad) fuer M1,6-Senkkopf; VORLAEUFIG
