robinrehbein/tangara/hardware/cad/stl/endgeraet/power_taste.stl

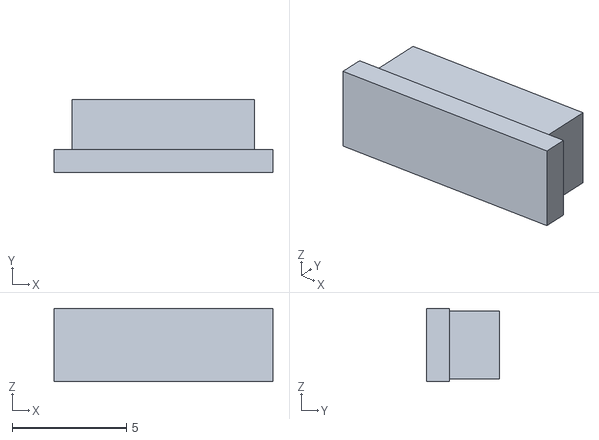
[picture p42: CAD file, 2026-10-04, an earlier design]
hardware/cad/stl/endgeraet/power_taste.stl
9.60 x 3.20 x 3.20
