robinrehbein/tangara/hardware/cad/stl/endgeraet_v2/power_taste.stl

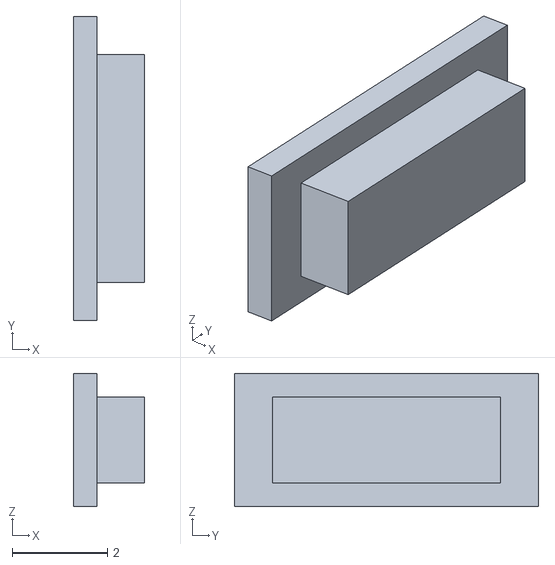
[picture p43: CAD file, 2026-10-04, an earlier design]
hardware/cad/stl/endgeraet_v2/power_taste.stl
1.50 x 6.40 x 2.80
