robinrehbein/tangara/hardware/cad/stl/endgeraet/rueckschale.stl

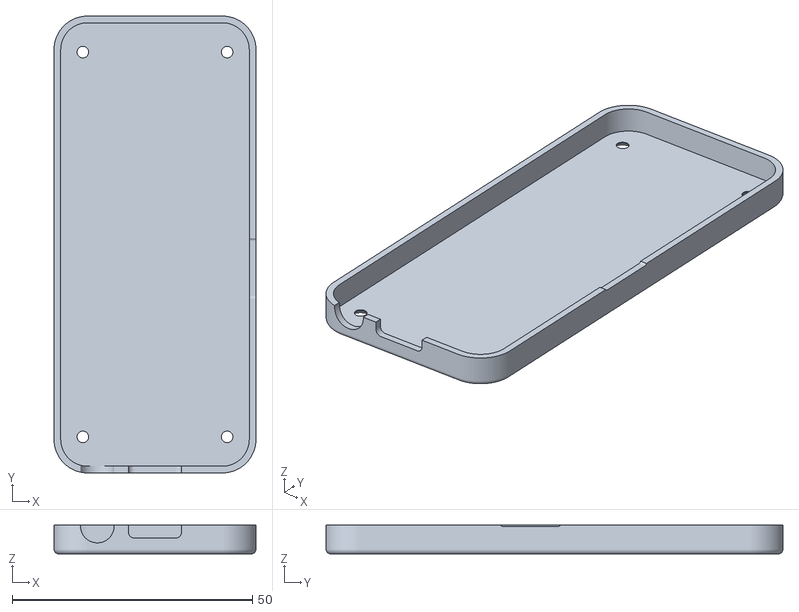
[picture p44: CAD file, 2026-10-04, an earlier design]
hardware/cad/stl/endgeraet/rueckschale.stl
42.0 x 95.0 x 6.00
