robinrehbein/tangara/hardware/cad/stl/endgeraet/distanzring.stl

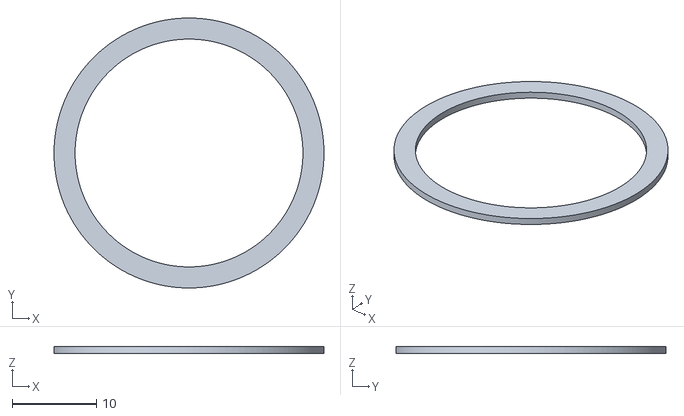
[picture p45: CAD file, 2026-10-04, an earlier design]
hardware/cad/stl/endgeraet/distanzring.stl
32.0 x 32.0 x 0.8
