robinrehbein/tangara/hardware/cad/stl/endgeraet_v2/frontplatte.stl

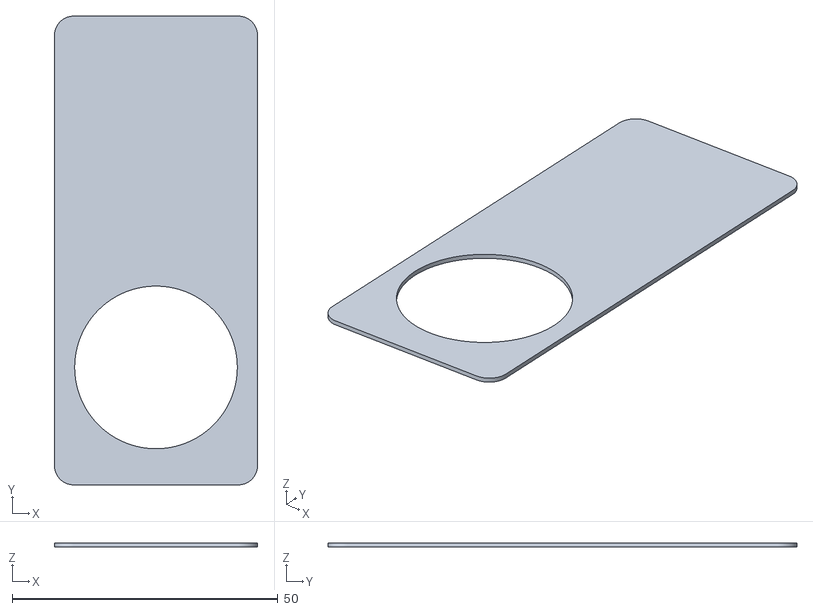
[picture p46: CAD file, 2026-10-04, an earlier design]
hardware/cad/stl/endgeraet_v2/frontplatte.stl
38.2 x 88.2 x 0.8
