robinrehbein/tangara/hardware/cad/stl/endgeraet/innenrahmen.stl

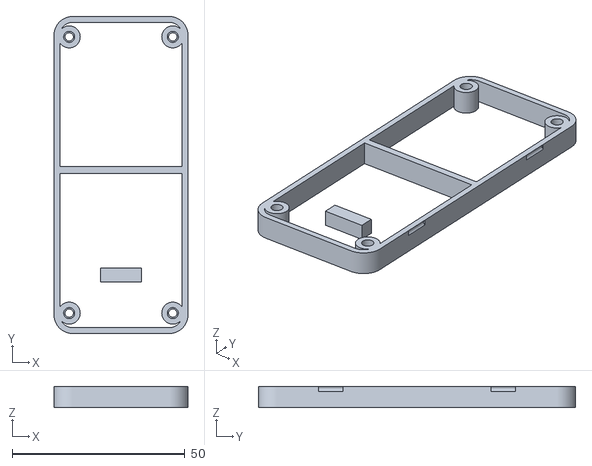
[picture p47: CAD file, 2026-10-04, an earlier design]
hardware/cad/stl/endgeraet/innenrahmen.stl
38.8 x 91.8 x 6.20
