robinrehbein/tangara/(list of files, cad)

Other CAD files:
hardware/cad/stl/endgeraet_v2/klickrad_abdeckung.stl
hardware/cad/dxf/endgeraet_v2/frontplatte.dxf
hardware/cad/dxf/endgeraet_v2/klickrad_abdeckung.dxf
hardware/cad/dxf/endgeraet_v3/frontplatte.dxf
hardware/cad/dxf/endgeraet_v3/klickrad_abdeckung.dxf
hardware/cad/stl/endgeraet/klickrad_abdeckung.stl
hardware/cad/stl/endgeraet/mitteltaste.stl
hardware/cad/stl/endgeraet/oberschale.stl
hardware/cad/stl/endgeraet_v2/rahmen.stl
hardware/cad/stl/endgeraet_v2/rueckwand.stl
