robinrehbein/tangara/docs/PROBLEME.md

# Problemliste

Alle bekannten Probleme und Lücken, damit am Ende geprüft werden kann, ob sie behoben sind. Stand: 2026-10-04. Status: **offen**, **in Arbeit**, **erledigt**. Beim Beheben Status und Beleg (Datei, Commit, Messung) eintragen.

## A. Blocker vor einer Bestellung

| Nr | Problem | Status | Prüfung am Ende |
|---|---|---|---|
| A1 | Hauptplatine war nicht geroutet | erledigt: 41 × 97 mm, 4 Lagen, DRC/ERC 0, 0 offene Verbindungen; nicht bestellbereit bis A2 | Alte Datei `NICHT_BESTELLEN_ungeroutet_gerber.zip` entfernt? |
| A2 | Opus-Design-Review der Hauptplatine: erfolgt (`docs/REVIEW-HAUPTPLATINE.md`, 4 Blocker, 10 Hoch); in **Rev. 3b** B1–B3 und die meisten Hoch-Funde behoben (Abschnitt 7 dort); **offen: B4 (Modul nicht lieferbar), H2, H10, Rest H3/H5/H6, Opus-Zweitreview der Änderungen** | offen | Zweitreview-Bericht in `docs/`, B4 geklärt |
| A3 | Klickrad-Platine v2 (AT42QT2120, 0,8 mm, Molex-FFC) | erledigt (ERC/DRC 0 Fehler, Gerber/BOM vorhanden); Restpunkte siehe A7–A10 | v1 nur noch in der Git-Historie |
| A4 | Nichts davon wurde je auf Hardware getestet (Firmware, Platinen, Haptik) | offen | Messprotokoll nach Phase 1 |
| A5 | Unbelegte Teile: LCSC-Nummern, Jack-Höhe/STEP-Ursprung, WROOM-1-Pinbelegung, Auflösung des 2,06"-Displays (Listing widersprüchlich) | offen | Je Teil Datenblatt oder Händlerseite verlinkt |
| A6 | CS43131: Lieferzeit ca. 20 Wochen bei Digi-Key, Verfügbarkeit unklar | offen | Bestellbar bestätigt oder Plan B (CS43198 + OPA1622) gewählt |
| A7 | Molex-503480-0600-Footprint ist Kopie des Hirose-FH12 und nicht gegen die Molex-Zeichnung geprüft | offen | Footprint gegen Datenblatt geprüft |
| A8 | AT42QT2120 (LCSC C617900) am 2026-10-04 nicht auf Lager; keine LCSC-Nummer für den Molex; CPL-Drehwinkel nicht gegen JLCPCB geprüft | offen | Bestand/Alternativen geklärt, Vorschau bei JLCPCB geprüft |
| A9 | Klickrad: Rad kleiner als im Datenblatt empfohlen (24,6 mm statt 30–50 mm), GND-Gitter bei 0,8 mm näher an den Elektroden als bei Tangara (1,6 mm); Empfindlichkeit unbekannt. Rückseitenbauteile 1,1 mm statt 0,8 mm | offen | Touch-Messung am Aufbau; Platine ggf. 1,6 mm |
| A10 | Klickrad: SCL von Hand gezogen, Pin 6 offen, Exposed Pad von U1 auf GND (Tangara lässt es offen), C5 und 10-µF am DRV2605L entfallen | offen | Review gegen Datenblatt (Teil von A2) |
| A11 | Klickrad-Stecker: FFC-Pin 1 auf Pin 1 ungeprüft (Kurzschlussgefahr), vor Einschalten durchklingeln | offen | Durchgangsprüfung am Kabel |
| A12 | `TEILE.md` hatte Klickrad-Widersprüche (4 Lagen/MPR121-Angaben); jetzt Abschnitt „Klickrad v2 (Stand)“, Rest oben noch v1-Text; CAD und Firmware-Wheel-Konvention müssen angepasst werden | offen | Angaben bereinigt, CAD/Firmware angepasst |
| A13 | Hauptplatine: Molex-Footprint ungeprüft (Nagelpads geschätzt 0,8 × 1,0 gegen 1,0 × 0,3 im Zeichnungstext); Rev. 3b: J20 jetzt Molex 503480-30 mit demselben Landmuster-Ansatz; J21 und Klickrad-J1 bleiben uneins, **J1 muss an J21 angeglichen werden** (Hauptplatine-README, Abschnitt Klickrad-Anschluss) | offen | Gegen Molex-Zeichnung geprüft (gleich wie A7), beide Platinen gemeinsam |
| A14 | Hauptplatine 1,0 mm: Passen SJ-43504 und USB4510 bei 1,0 statt 0,8 mm? USB4510: Datenblatt nennt 0,80 mm (Review H10); Rev. 3b ändert die Dicke nicht | offen | GCT-Anfrage oder 0,8-mm-Platine entscheiden (`KONZEPT.md`) |
| A15 | USB-HS: in Rev. 3b ca. 72 mm gekoppelt auf F.Cu über In1 (0,20/0,15 mm, Längenunterschied 0,5 mm, Gesamtlänge DP 91,0 mm / DN 90,5 mm, 3/2 Vias), Lagenaufbau in der Platinendatei hinterlegt; **Impedanz unbestätigt** | teilweise erledigt | Aufbau/Breite bei PCBWay bestätigen lassen; USB-Test am Aufbau |
| A16 | Akku nur ca. 450–550 mAh (32 × 38,5 mm), Ziel 600 mAh; bei 10 mm Gerätedicke Zelle höchstens ca. 3,7 mm | offen | Zelle gewählt, Kapazität bestätigt |
| A17 | Display-Zone: Vorderseitenteile ≤ 1,0 mm unter dem Display brauchen ≥ 1,1 mm Luft; CAD-Stand 0,25 mm | offen | CAD angepasst |
| A18 | Hauptplatine: Schaltungsfunktion, CPL-Drehungen und LCSC-Nummern nicht verifiziert; Routing nicht per Knopfdruck reproduzierbar (Skripte, Mini-Router, Zwischenstände in `tools/routing/`) | offen | Opus-Review (A2), Vorschau bei Fertiger |
| A19 | Kosten Hauptplatine grob 400–550 € für 5 Platinen, 2 bestückt (110–140 € je bestückter Platine), über Projektbudget; Schätzung aus dem Gedächtnis | offen | Echtes PCBWay-Angebot, `docs/KOSTEN.md` angepasst |

## B. Technische Risiken

| Nr | Problem | Status | Prüfung am Ende |
|---|---|---|---|
| B1 | ESP32-S31: Bluetooth Classic nur „Preview“, Controller ist Binärbibliothek; Kopfhörer-Kompatibilität unbekannt | offen | A2DP-Test mit S31-DevKit und mindestens 2 Kopfhörern |
| B2 | Bluetooth-Fallback (externes Modul) nicht geplant | offen | Entscheidung in `KONZEPT.md` |
| B3 | Prototyp Waveshare-S3 kann kein Classic-A2DP, nur BLE | bekannt | Prototyp-Tests nur Display/Haptik/Rad, BT erst auf S31 |
| B4 | Ein USB-OTG-Port: USB-Audio-Host und USB-Speicher (MSC) schließen sich aus | offen | Moduswechsel implementiert und getestet |
| B5 | IDF-Version: S31 braucht v6.1 mit `--preview`, Hauptfirmware nur mit v5.4.2 auf S3 gebaut | offen | Version gepinnt, beide Targets bauen |
| B6 | I²S-Slave-Timing und 24 Bit am Codec, maximale BCLK des S31 ungeprüft | offen | Messung am Aufbau |
| B7 | CS43131: PLL gegen zweiten Quarz, Ausgangsimpedanz, Rauschen der Ladungspumpe ungemessen | offen | Messung nach Aufbau |
| B8 | Haptik: DRV2605L-Tuning, Latenz < 10 ms, Verträglichkeit LRA-Brummen mit Audio ungeprüft | offen | Logic-Analyzer-Messung, Hörtest |
| B9 | Klickrad: Segment-Zuordnung und Winkel-Offset (105°) nur berechnet, nicht am echten Rad geprüft | offen | Test am Aufbau, Wert in Kconfig angepasst |
| B10 | Klickrad v2 hat jetzt 2 Lagen (v1 hatte 4); Kosten in `docs/KOSTEN.md` und Einkaufsliste prüfen | offen | Kosten stimmen |

## C. Mechanik und CAD

| Nr | Problem | Status | Prüfung am Ende |
|---|---|---|---|
| C1 | CAD-Gehäuse noch für 8,5 mm (v2) bzw. 12,2 mm; Ziel ist jetzt ca. 44 × 100 × bis 10 mm | offen (wartet auf Platinenmaße) | Neues Gehäuse, STL kollisionsfrei, Maße = `TEILE.md` |
| C2 | Oberschale ohne Schraubdome, Halt über Rastnasen: ungeprüft | offen | Probedruck |
| C3 | Klickrad-Platine nur mit Distanzring und Klebeband befestigt, Verschraubung offen | offen | Entscheidung in `TEILE.md` |
| C4 | Ein/Aus-Taste auf z = 9,2 statt 10,3 (Abweichung) | bekannt | Neu bewerten bei neuer Dicke |
| C5 | Akku gegen LRA-Ausschnitt: Platz knapp (Ziel ≥ 600 mAh) | offen | Akkumaße im CAD, Kapazität bestätigt |
| C6 | 3D-Explosionsmodell zeigt noch das alte 12,2-mm-Design (JST, MPR121, Ø26-Ausschnitt) | offen | Modell zeigt aktuelles Design |
| C7 | Passung von Druckteilen (Toleranzen SV06 Ace / Voron) ungeprüft | offen | Probedruck |
| C8 | Display-Modul überlappt den Antennen-Keepout (x 12,7–17,4, y 28–41); Display-Position ist eine Annahme | offen | Display-Maße/Position gegen Datenblatt, ggf. WROOM-1 oder Display verschieben |
| C9 | Rückzone 3,95 mm statt 4,05 (Klebefilm 0,1 mm): Akku höchstens 3,65 mm, sonst Gerät 10,1 mm | offen | Akku gewählt, Dicke festgelegt |
| C10 | LRA-Freifläche: Klickrad-README 16 × 6 mm, Platinen-Ausschnitt nur 14 mm breit; Modell nimmt 12 × 6 × 3,0 an; Keepout-Maße in TEILE.md und Platinen-README weichen leicht ab | offen | Ausschnitt oder LRA-Auswahl angepasst, Maße vereinheitlicht |
| C11 | Schrauben M1,6 × 8: Eingriff im Dom nur 2,05 mm (zu wenig für Kunststoff); vierte Ecke ohne Loch; Klickrad nur geklebt | offen | Gewindeeinsatz/furchende Schraube oder Konstruktion geändert |
| C12 | Druck: Dome brauchen Stützen, microSD-Öffnung überbrückt 12 mm, Biegezunge für SW1 nur gerechnet; kein Carbon-/Metall-Filament wegen Antenne | offen | Probedruck |
| C13 | Engste Stelle: Klinke zu Klickrad-Rückseite 0,35 mm; Stecker- und microSD-Maße im CAD sind Platzhalter | offen | Echte STEP-Modelle/Teile gemessen |

## D. Dokumentation und Konsistenz

| Nr | Problem | Status | Prüfung am Ende |
|---|---|---|---|
| D1 | `TEILE.md` und `KONZEPT.md` führen Altes und Neues nebeneinander (8,5 / 12,2 / 44 × 100 × 10 mm; Hauptplatine „WROOM-3→-1“; „Hauptplatine nicht bestellbereit“) | offen | Nach Abschluss bereinigt |
| D2 | `docs/DUENNBAU.md` und `docs/duennbau/stackup.svg` sind überholt | offen | Als „Referenz“ markiert oder aktualisiert |
| D3 | Preise in `docs/EINKAUFSLISTE.md` und `docs/KOSTEN.md` aus dem Gedächtnis, nicht verifiziert; Muss+Soll hat nur 5 € Reserve; Waveshare-Board oft teurer | offen | Preise gegen Händler geprüft |
| D4 | Einkaufsliste noch auf JST-SH und MPR121 (v1), Klickrad ist jetzt v2 (Molex-FFC, QT2120) | offen | Liste auf v2 angepasst |
| D5 | Budget 100–150 € deckt nur Phase 1; gesamt 360–625 € | bekannt | Nutzer hat Gesamtbudget bestätigt |
| D6 | Emulator-Werte (Rasterschritt, Stärke, Mindestabstand, Anschlag) in `KONZEPT.md` noch „offen“ | offen | Werte eingetragen |
| D7 | Querprüfung fehlt: Gehäuse gegen Platinenmaße, Firmware gegen Pinbelegung und Segment-Zuordnung | offen | Prüfliste abgehakt |
| D8 | Repo hat keinen Standardbranch (`main`), kein PR | offen | Entscheidung des Nutzers |
| D9 | `.git` ca. 69 MB durch versehentlich eingecheckte Build-Ordner in der Historie | bekannt, unkritisch | Optional bereinigen |
| D10 | Lizenzen: Tangara-Ableitungen CERN-OHL-S-2.0 / GPL-3.0; Header und LICENSE-Dateien in allen neuen Ordnern prüfen | offen | Stichprobe je Ordner |

## E. Software

| Nr | Problem | Status | Prüfung am Ende |
|---|---|---|---|
| E1 | Firmware nur gebaut, nie geflasht; Klickrad-Komponenten mit Hosttest, Rest ungetestet | offen | Lauf auf Waveshare-Board |
| E2 | Firmware-Fork der Tangara-Firmware noch nicht gemacht (aktuell eigenes Gerüst) | offen | Portierungsplan `docs/FIRMWARE-PORTIERUNG.md` umgesetzt |
| E3 | Spotify (cspot) nur offener Punkt; DRM verhindert Offline | offen | Entscheidung nach Prototyp |
| E4 | Devialet-Steuerung per UPnP nur Idee, nicht als Ziel festgelegt | offen | Als Phase-4-Ziel entscheiden |
| E5 | Android-Emulator: Haptik-Qualität hängt vom Handy; Ergebnisse des Nutzers fehlen | offen | Werte aus Test in `KONZEPT.md` |

## F. Prozess

| Nr | Problem | Status | Prüfung am Ende |
|---|---|---|---|
| F1 | Freerouting unzuverlässig (ignoriert Zeitlimits, kein Ergebnis bei SIGTERM) | bekannt | Alternativer Router oder manuelle Nacharbeit dokumentiert |
| F2 | Router-/Agentenläufe können Dateien überschreiben (Klickrad v1 → v2) | bekannt | v1 per Git-Historie auffindbar |

## E. Ergebnis Opus-Review (2026-10-05, `docs/REVIEW-HAUPTPLATINE.md`): nicht bestellbereit

Blocker: **E1** PCA9306 (U30) VREF2 direkt an 3V3, 1,8-V-Schiene steigt auf ca. 2,7 V, CS43131 verträgt max. 2,33 V (Fix: VREF2 mit EN verbinden, 200 k an 3V3). **E2** Strapping-Pin IO36: R57 an SD_VDD (beim Reset aus), Pegel ca. 1,65 V undefiniert, Flash bekommt evtl. 1,8 V (Fix: R57 nicht bestücken oder an 3V3). **E3** MCP73871: SEL hoch = AC-Modus, nicht USB; R39 = 1 k lädt mit 1 A in ca. 500 mAh (2 C). **E4** ESP32-S31-WROOM-1-N16R16V bei Digi-Key/Mouser nicht lieferbar (21 Wochen bzw. März 2027).
Hoch: DAC-RESET geht ohne 3V3 auf high (Sequenz verletzt); I²S/DAC in Domäne VDDPST_SD, Default nicht bekannt; Leistungsnetze teils 0,25 mm auf In2 (BOOST_SW 0,127 mm); J20 2,0 mm hoch statt 1,0; USB-HS kein Paar, kein Lagenaufbau hinterlegt; Klickrad J1 und Hauptplatine J21 verschiedene Footprints für denselben Molex; R1 parallel zum Akku-NTC löst Heiß-Abschaltung aus; BOOT/EN nur Testpunkte; CS43131 bei Mouser ab 4000 Stück; USB4510 für 0,8 mm ausgelegt, Platine 1,0 mm (klärt A14: passt nicht ohne Weiteres).
Dazu 12 Mittel, 9 Niedrig, Abschnitt Klickrad v2. Ohne Befund: WROOM-1-Pins, Boot, CS43131-Pins, Quarz, TUSB320LAI, TPS2553/TPS61023/TLV757P, MAX17048, I²C-Adressen, SJ-43504.
Nicht prüfbar: Molex-Zeichnung, VDDPST_SD-Default, PCBWay-Lagenaufbau, CPL-Unterseite, Display-FPC, CS43131-Reset-Schwellen.

Stand **Rev. 3b (2026-10-05)** (Details je Fund: `docs/REVIEW-HAUPTPLATINE.md`, Abschnitt 7): **behoben** B1 (PCA9306 VREF2 = EN), B2 (R57 nicht bestückt), B3 (SEL = GND, PROG2 fest, R39 2,7 k), H1 (Reset-Sicherung Q21/Q22/R250), H4 (J20 = Molex 5034803000, 1,0 mm), H7 (R1 DNP), H8 (BOOT/EN-Taster SW2/SW3); **teilweise** H3 (Leistungsnetze verbreitert, BOOST_SW-Engpass und 47-µF-Bulk offen), H5 (USB-Paar gekoppelt, Impedanz offen), H6 (Klickrad-J1 muss geändert werden, nicht geändert); **offen** B4 (Modul nicht lieferbar), H2 (VDDPST_SD-Default), H9 (CS43131-Verfügbarkeit), H10 (USB4510 0,8 mm). ERC 0, DRC 0, 0 unverbundene Verbindungen; nicht auf Hardware getestet. **Bestellbereit: nein** (B4, Opus-Zweitreview der Änderungen).

## F. Nachtrag Gehäuse v3 an Rev. 3b angepasst (2026-10-05)

C9 unverändert offen (Rückzone 3,95, Akku ≤ 3,65 mm; J20 ist selbst 1,0 mm hoch, daher keine Reduktion möglich). C10 teilweise gelöst: LRA ≤ 13 × 9 × 3 mm (`V3_LRA_MAX`), Keepout = größeres Platinen-README-Rechteck. C11 teilweise: Variante A furchende Schraube, Variante B Gewindeeinsatz (`rahmen_einsatz.stl`, Maße Annahme), vierte Ecke offen (VHB-Klebepunkt vorgeschlagen). C13 unverändert (0,35 mm Klinke/Rad-Rückseite). Neu: Luft J20 zum Display nur 0,10 mm (Steckerhöhe messen). SW2/SW3 mit Stiftlöchern Ø 1,8 in der Rückwand. A17/C8: Display überlappt weiter den Antennen-Keepout (121 mm³), nicht vom Gehäuse lösbar. Ungeprüft: SW2/SW3-Körper, Gravur, Panel-FPC, Einsatz-Auszugskraft.
