robinrehbein/tangara/hardware/pcb/klickrad/vorschau/klickrad_schaltplan.pdf

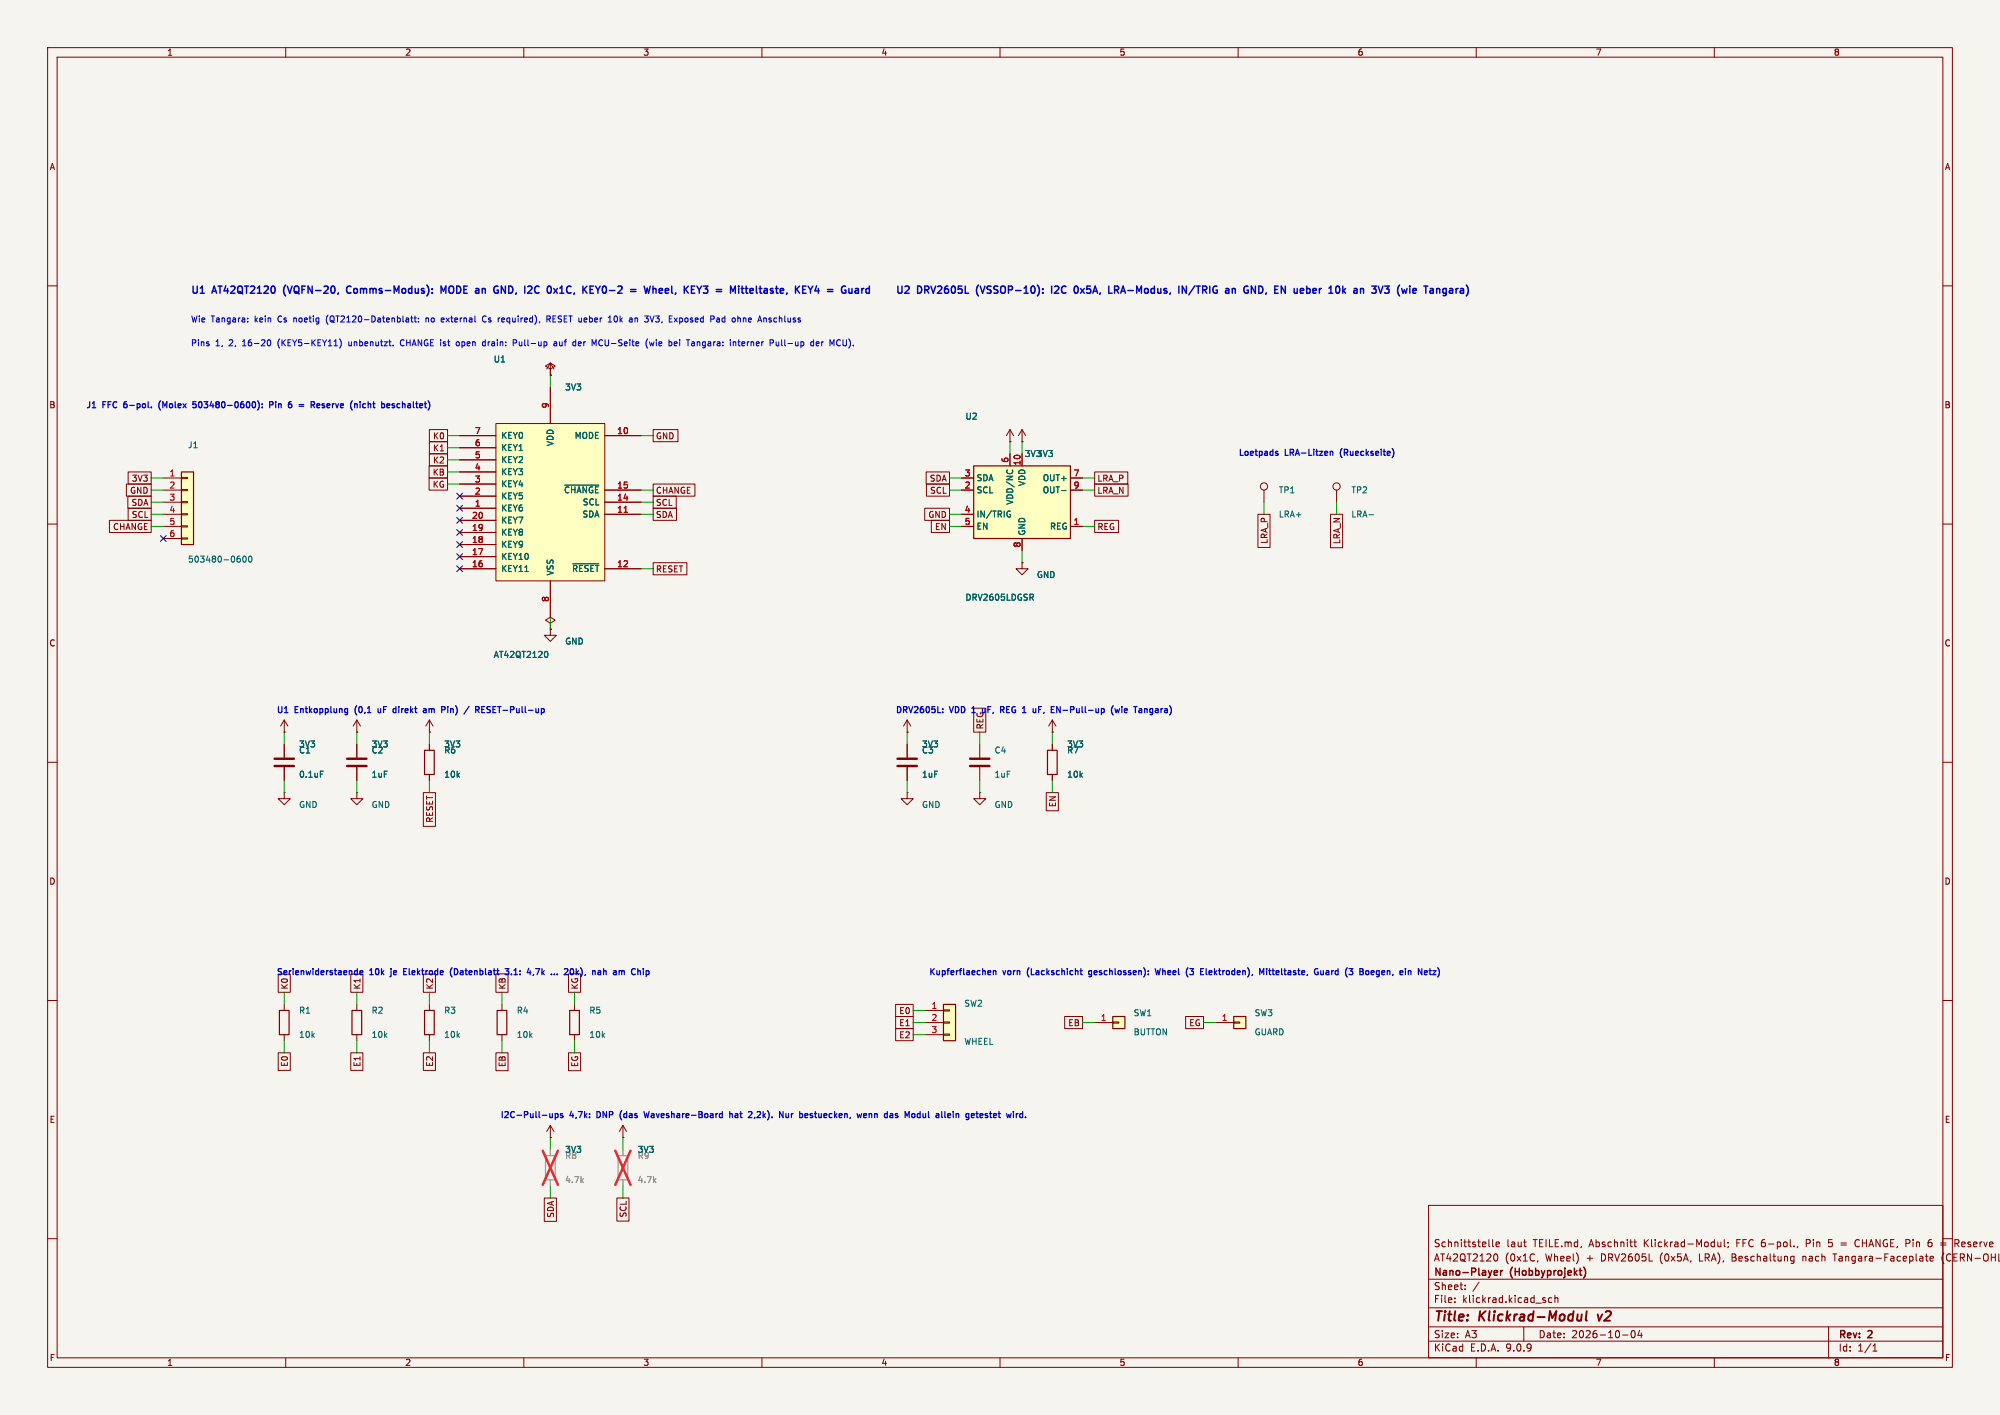
[picture p48: page 1]

8 MODE 10 ~{CHANGE} 15 SCL 14 SDA 11 ~{RESET} 12 U1AT42QT2120 GND

8 OUT+ 7 OUT- 9 REG 1 U2 DRV2605LDGSR GND

8 MODE 10 ~{CHANGE} 15 SCL 14 SDA 11 ~{RESET} 12

SCL SDA CHANGE GND
