robinrehbein/tangara/hardware/pcb/hauptplatine/fertigung/hauptplatine_schaltplan.pdf

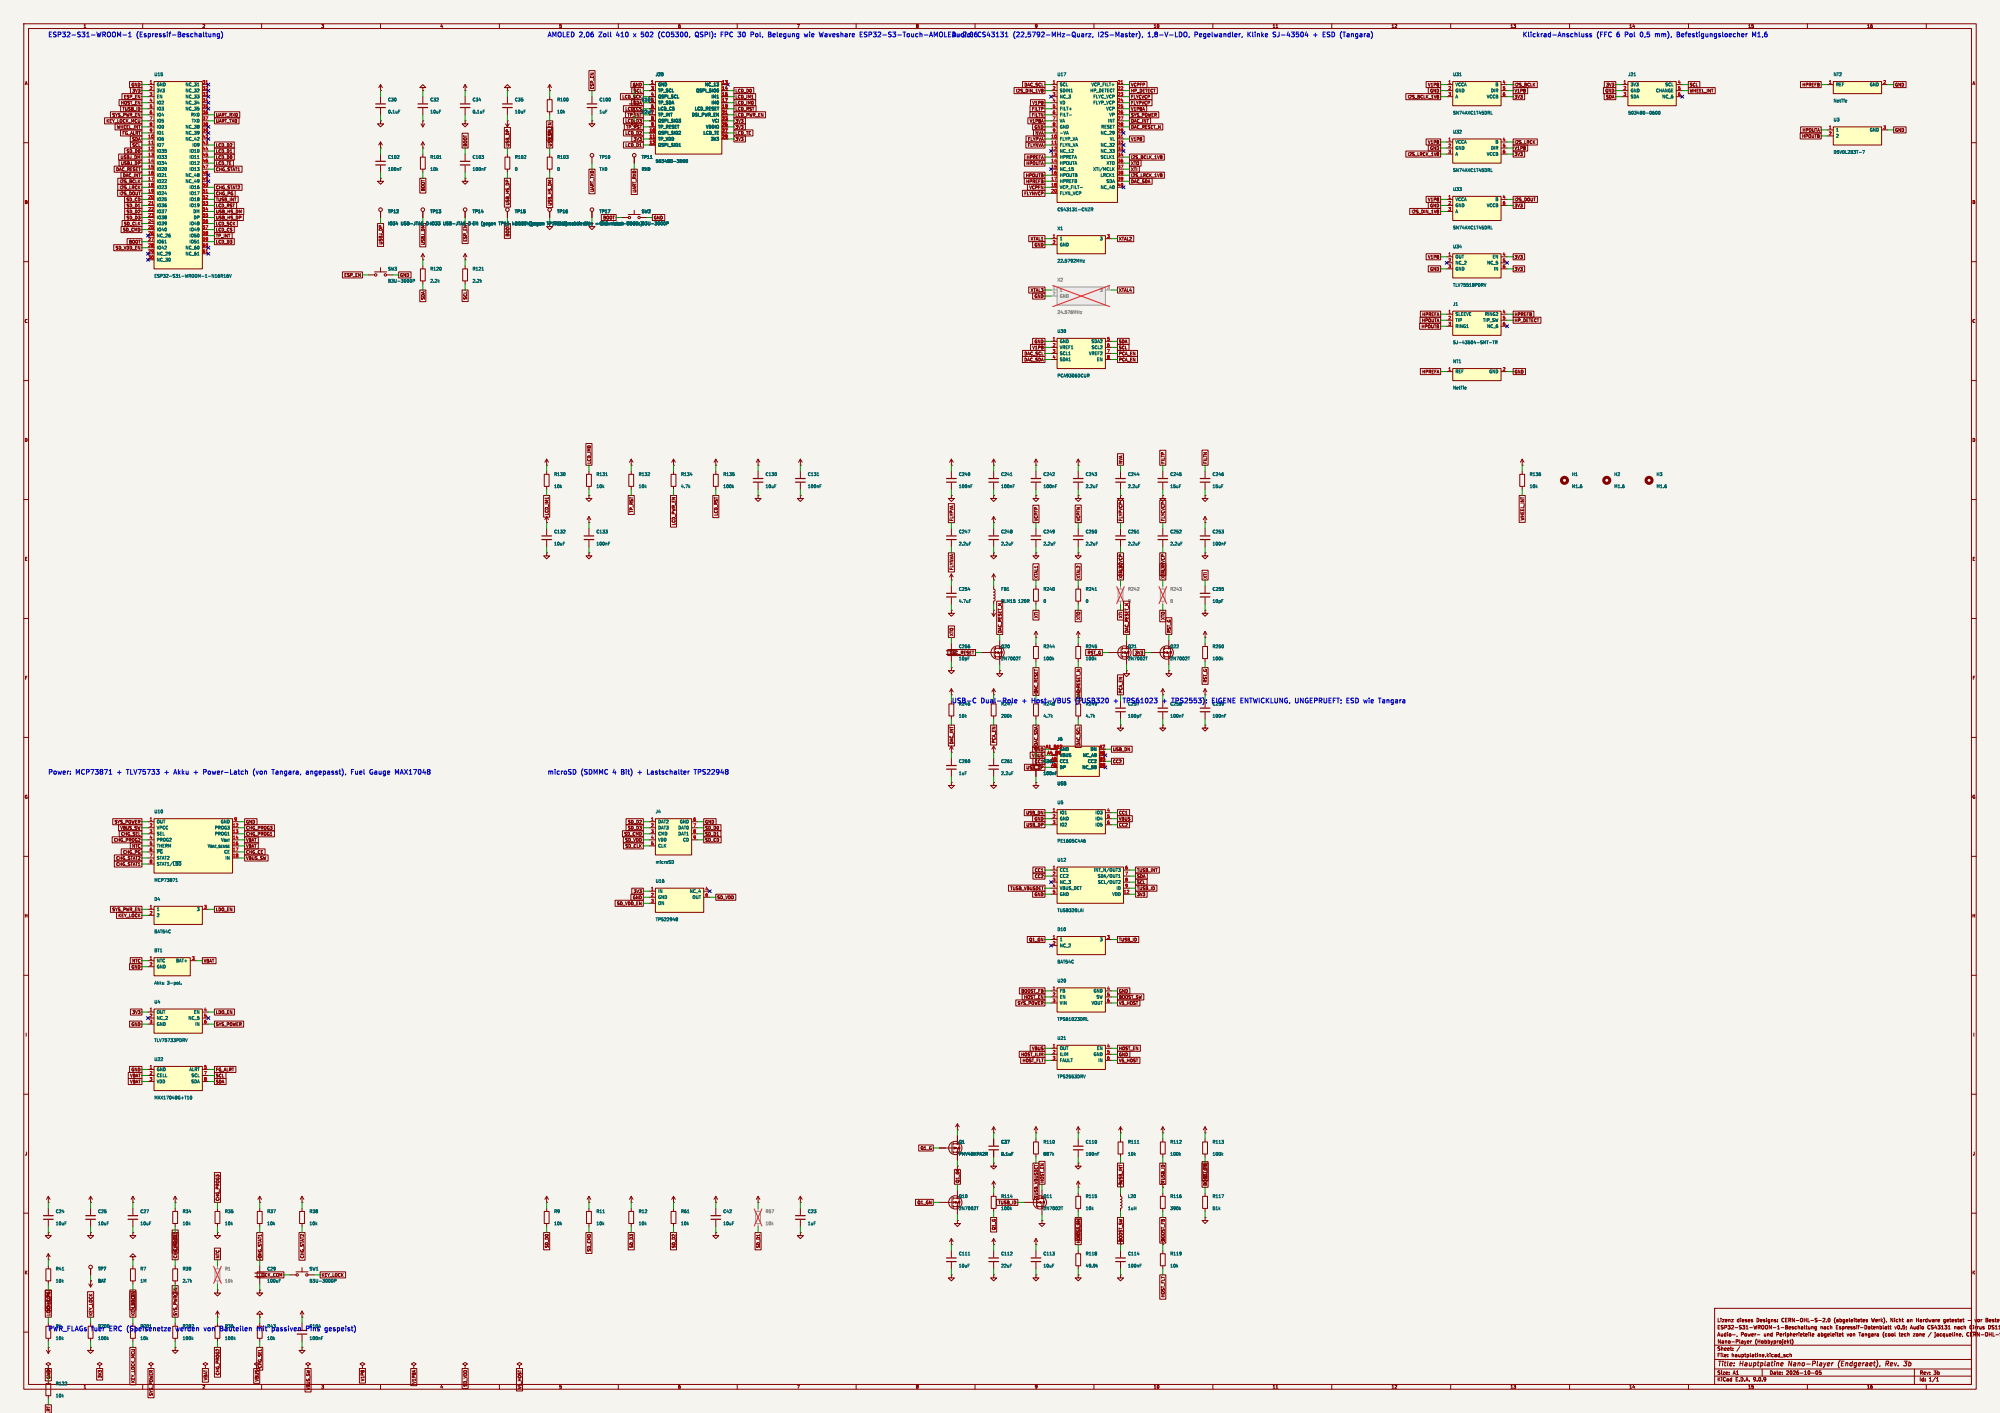
[picture p49: page 1]

HPREFB HPOUTA HPOUTB XTI XTAL3
