robinrehbein/tangara/(list of files, drawings)

Other design files:
hardware/pcb/hauptplatine/tools/routing/run14.dsn
