robinrehbein/tangara/hardware/pcb/klickrad/klickrad.kicad_pcb

## KiCad design hardware/pcb/klickrad/klickrad.kicad_pcb (2026-10-05)

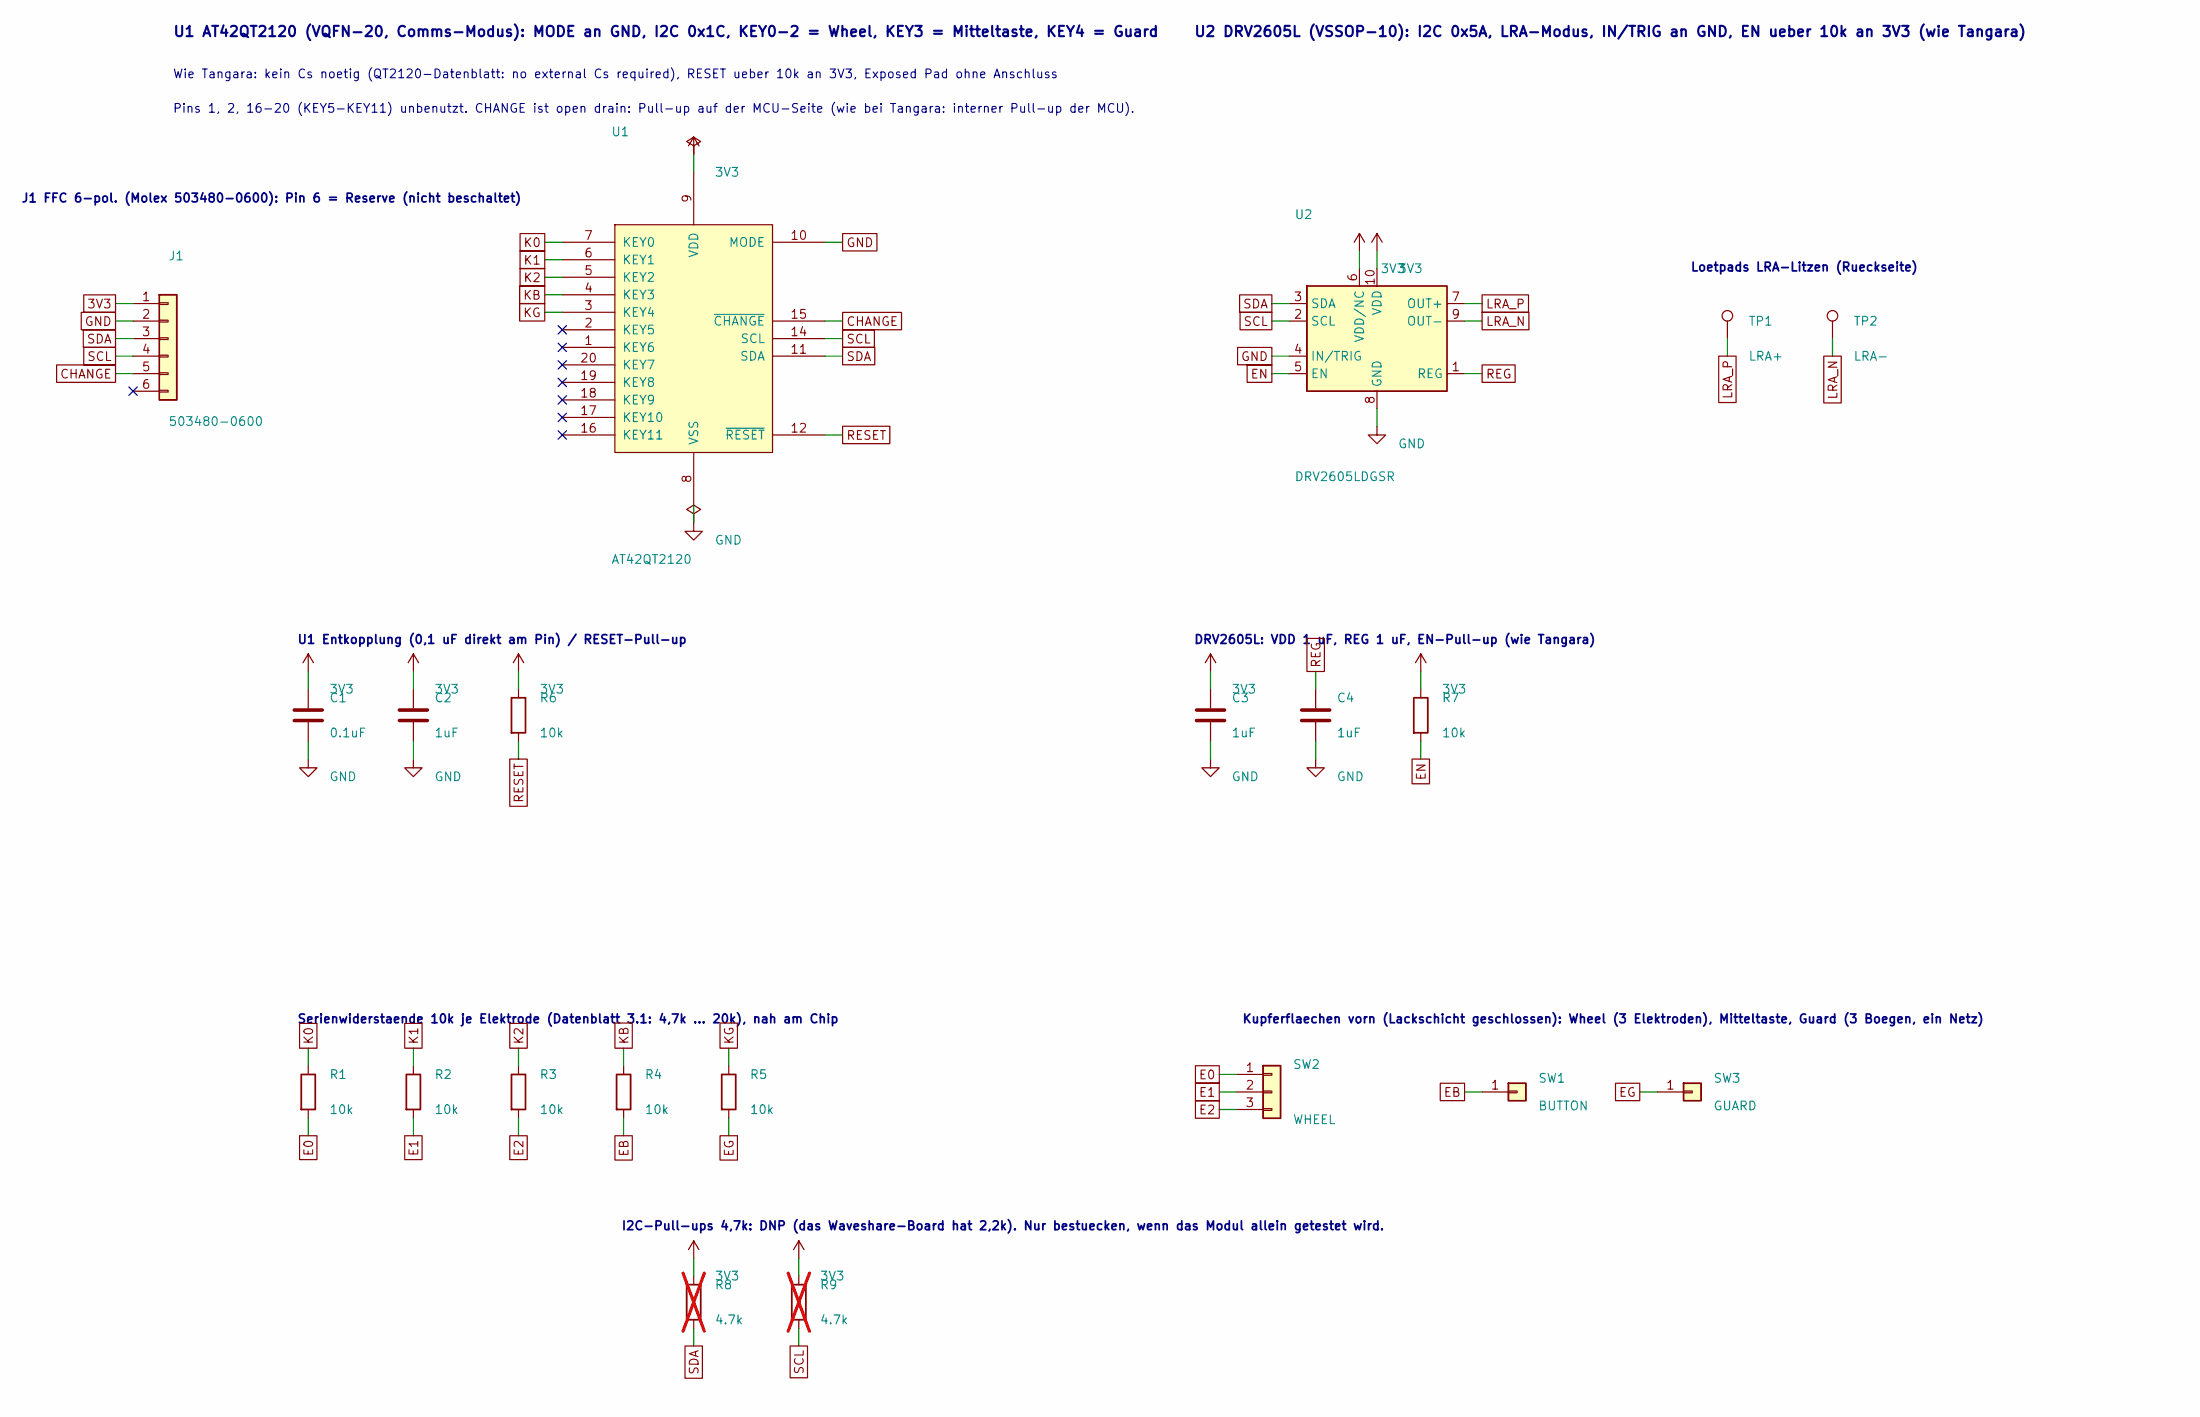
[picture p50: schematic klickrad.kicad_sch, Klickrad-Modul v2]

Parts:
C1: 0.1uF; C_0402_1005Metric
C2, C3, C4: 1uF; C_0402_1005Metric
J1: 503480-0600; Molex_503480-0600_Hauptplatine; MPN 503480-0600
R1, R2, R3, R4, R5, R6, R7: 10k; R_0402_1005Metric
R8, R9: 4.7k; R_0402_1005Metric; not fitted
SW1: BUTTON; qtouch-button
SW2: WHEEL; qtouch-wheel
SW3: GUARD; qtouch-guard
TP1: LRA+; SolderWirePad_1x01_SMD_1x2mm
TP2: LRA-; SolderWirePad_1x01_SMD_1x2mm
U1: AT42QT2120; VQFN-20-1EP_3x3mm_P0.45mm_EP1.55x1.55mm; MPN AT42QT2120-MMH
U2: DRV2605LDGSR; VSSOP-10_3x3mm_P0.5mm; MPN DRV2605LDGSR

Connections:
3V3: C1.1, C2.1, C3.1, J1.1, R6.1, R7.1, R8.1, R9.1, U1.9 (VDD), U2.6 (VDD/NC), U2.10 (VDD)
CHANGE: J1.5, U1.15 (~CHANGE)
E0: R1.2, SW2.1
E1: R2.2, SW2.2
E2: R3.2, SW2.3
EB: R4.2, SW1.1
EG: R5.2, SW3.1
EN: R7.2, U2.5 (EN)
GND: C1.2, C2.2, C3.2, C4.2, J1.2, U1.8 (VSS), U1.10 (MODE), U1.21, U2.4 (IN/TRIG), U2.8 (GND)
K0: R1.1, U1.7 (KEY0)
K1: R2.1, U1.6 (KEY1)
K2: R3.1, U1.5 (KEY2)
KB: R4.1, U1.4 (KEY3)
KG: R5.1, U1.3 (KEY4)
LRA_N: TP2.1, U2.9 (OUT-)
LRA_P: TP1.1, U2.7 (OUT+)
REG: C4.1, U2.1 (REG)
RESET: R6.2, U1.12 (~RESET)
SCL: J1.4, R9.2, U1.14 (SCL), U2.2 (SCL)
SDA: J1.3, R8.2, U1.11 (SDA), U2.3 (SDA)

Notes on the sheet:
U1 AT42QT2120 (VQFN-20, Comms-Modus): MODE an GND, I2C 0x1C, KEY0-2 = Wheel, KEY3 = Mitteltaste, KEY4 = Guard
Wie Tangara: kein Cs noetig (QT2120-Datenblatt: no external Cs required), RESET ueber 10k an 3V3, Exposed Pad ohne Anschluss
Pins 1, 2, 16-20 (KEY5-KEY11) unbenutzt. CHANGE ist open drain: Pull-up auf der MCU-Seite (wie bei Tangara: interner Pull-up der MCU).
U1 Entkopplung (0,1 uF direkt am Pin) / RESET-Pull-up
Serienwiderstaende 10k je Elektrode (Datenblatt 3.1: 4,7k ... 20k), nah am Chip
Kupferflaechen vorn (Lackschicht geschlossen): Wheel (3 Elektroden), Mitteltaste, Guard (3 Boegen, ein Netz)
J1 FFC 6-pol. (Molex 503480-0600): Pin 6 = Reserve (nicht beschaltet)
U2 DRV2605L (VSSOP-10): I2C 0x5A, LRA-Modus, IN/TRIG an GND, EN ueber 10k an 3V3 (wie Tangara)
DRV2605L: VDD 1 uF, REG 1 uF, EN-Pull-up (wie Tangara)
Loetpads LRA-Litzen (Rueckseite)
I2C-Pull-ups 4,7k: DNP (das Waveshare-Board hat 2,2k). Nur bestuecken, wenn das Modul allein getestet wird.

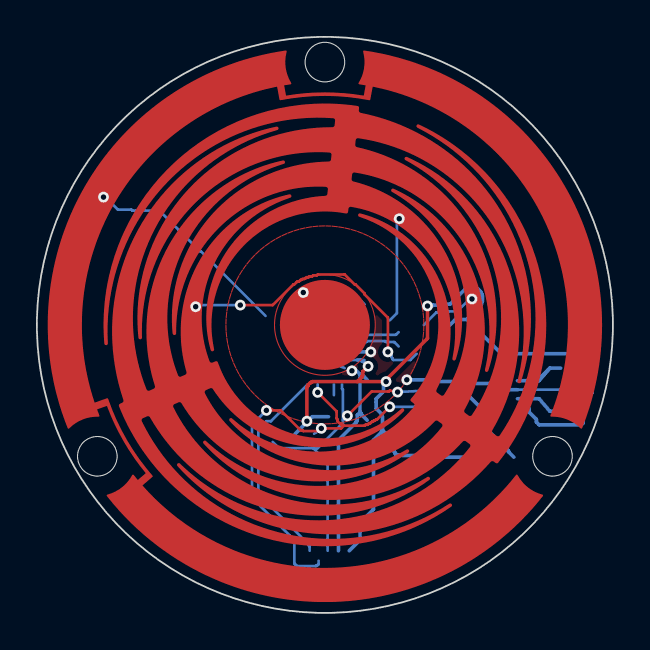
[picture p51: board klickrad.kicad_pcb from above]

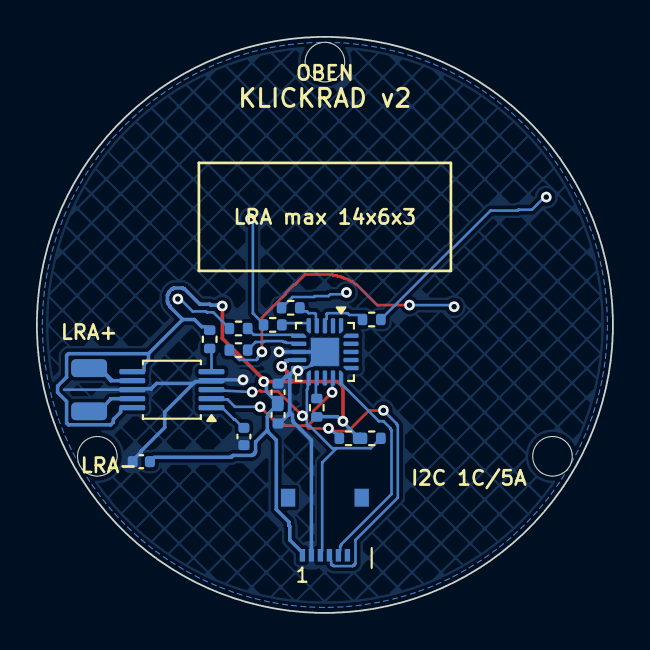
[picture p52: board klickrad.kicad_pcb from below]

Board: 2 copper layers, 32.0 x 32.0 mm, 24 parts (18 on the bottom side), 20 nets.

Other parts of the board:
H1, H2, H3: M2; MountingHole_2.2mm_NPTH
