robinrehbein/tangara/hardware/pcb/hauptplatine/hauptplatine.kicad_pcb

## KiCad design hardware/pcb/hauptplatine/hauptplatine.kicad_pcb (2026-10-04)

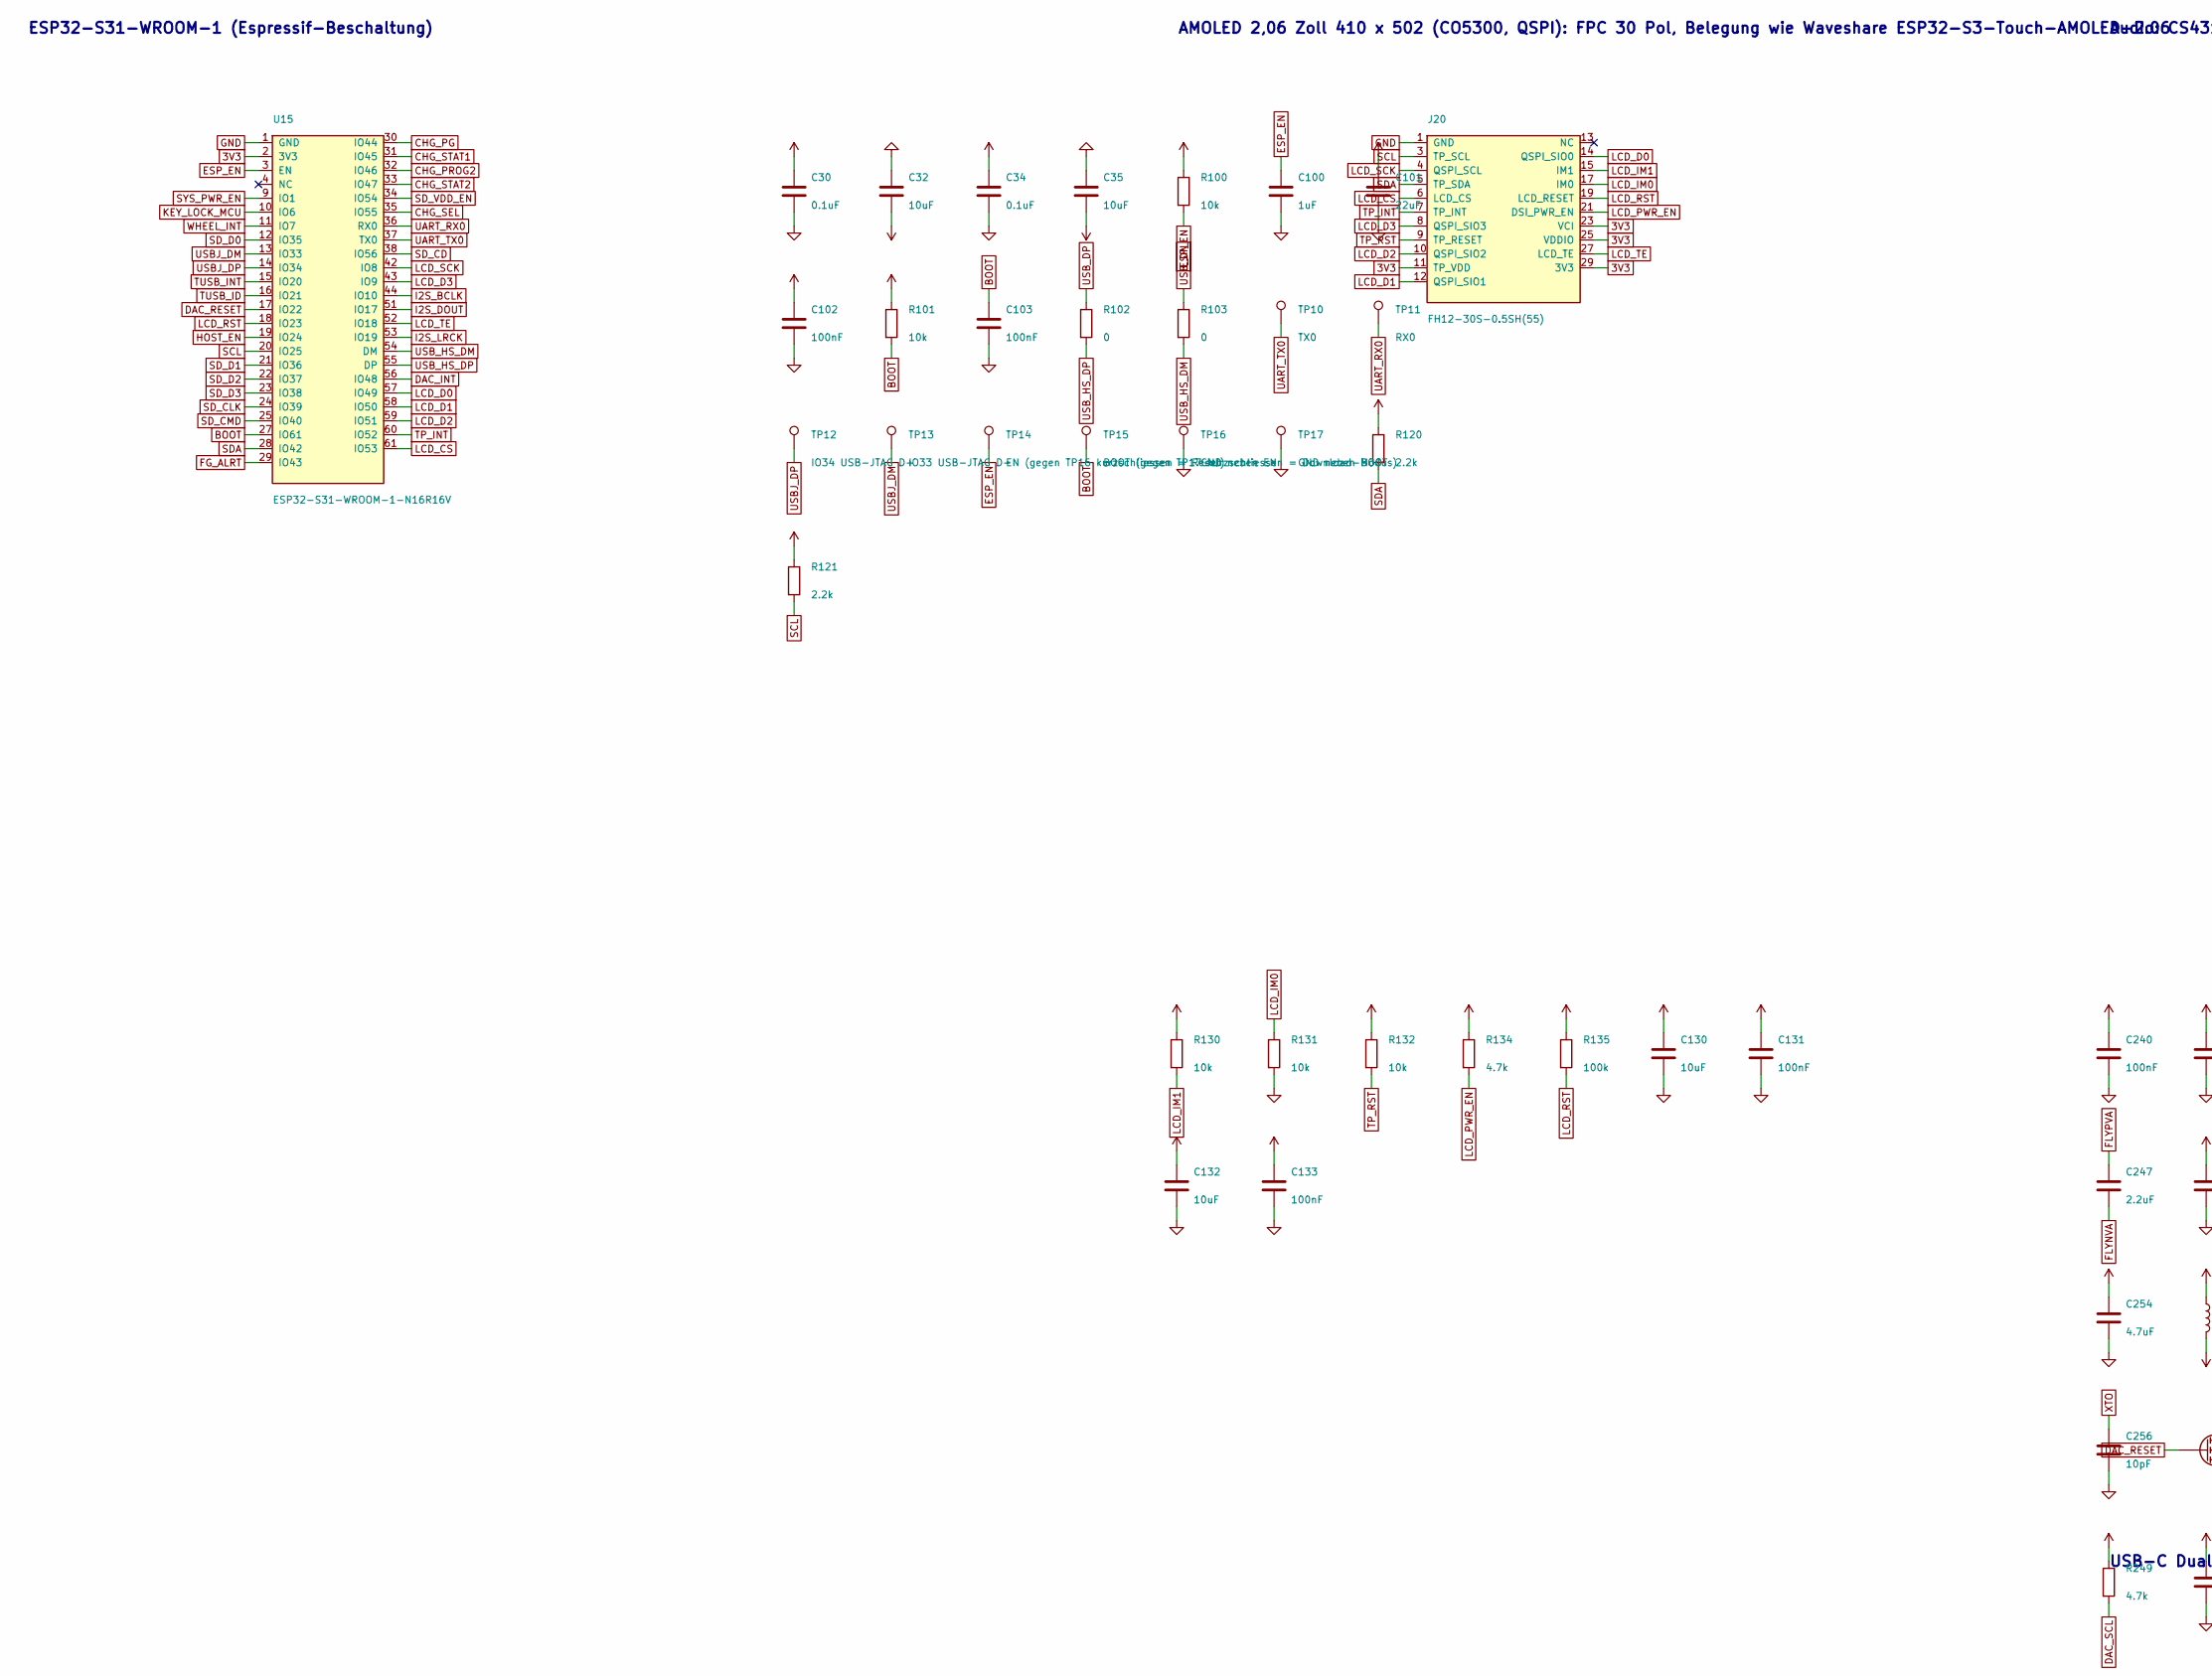
[picture p53: schematic hauptplatine.kicad_sch, Hauptplatine Nano-Player (Endgeraet), Rev. 2, part in row 1, column 1]

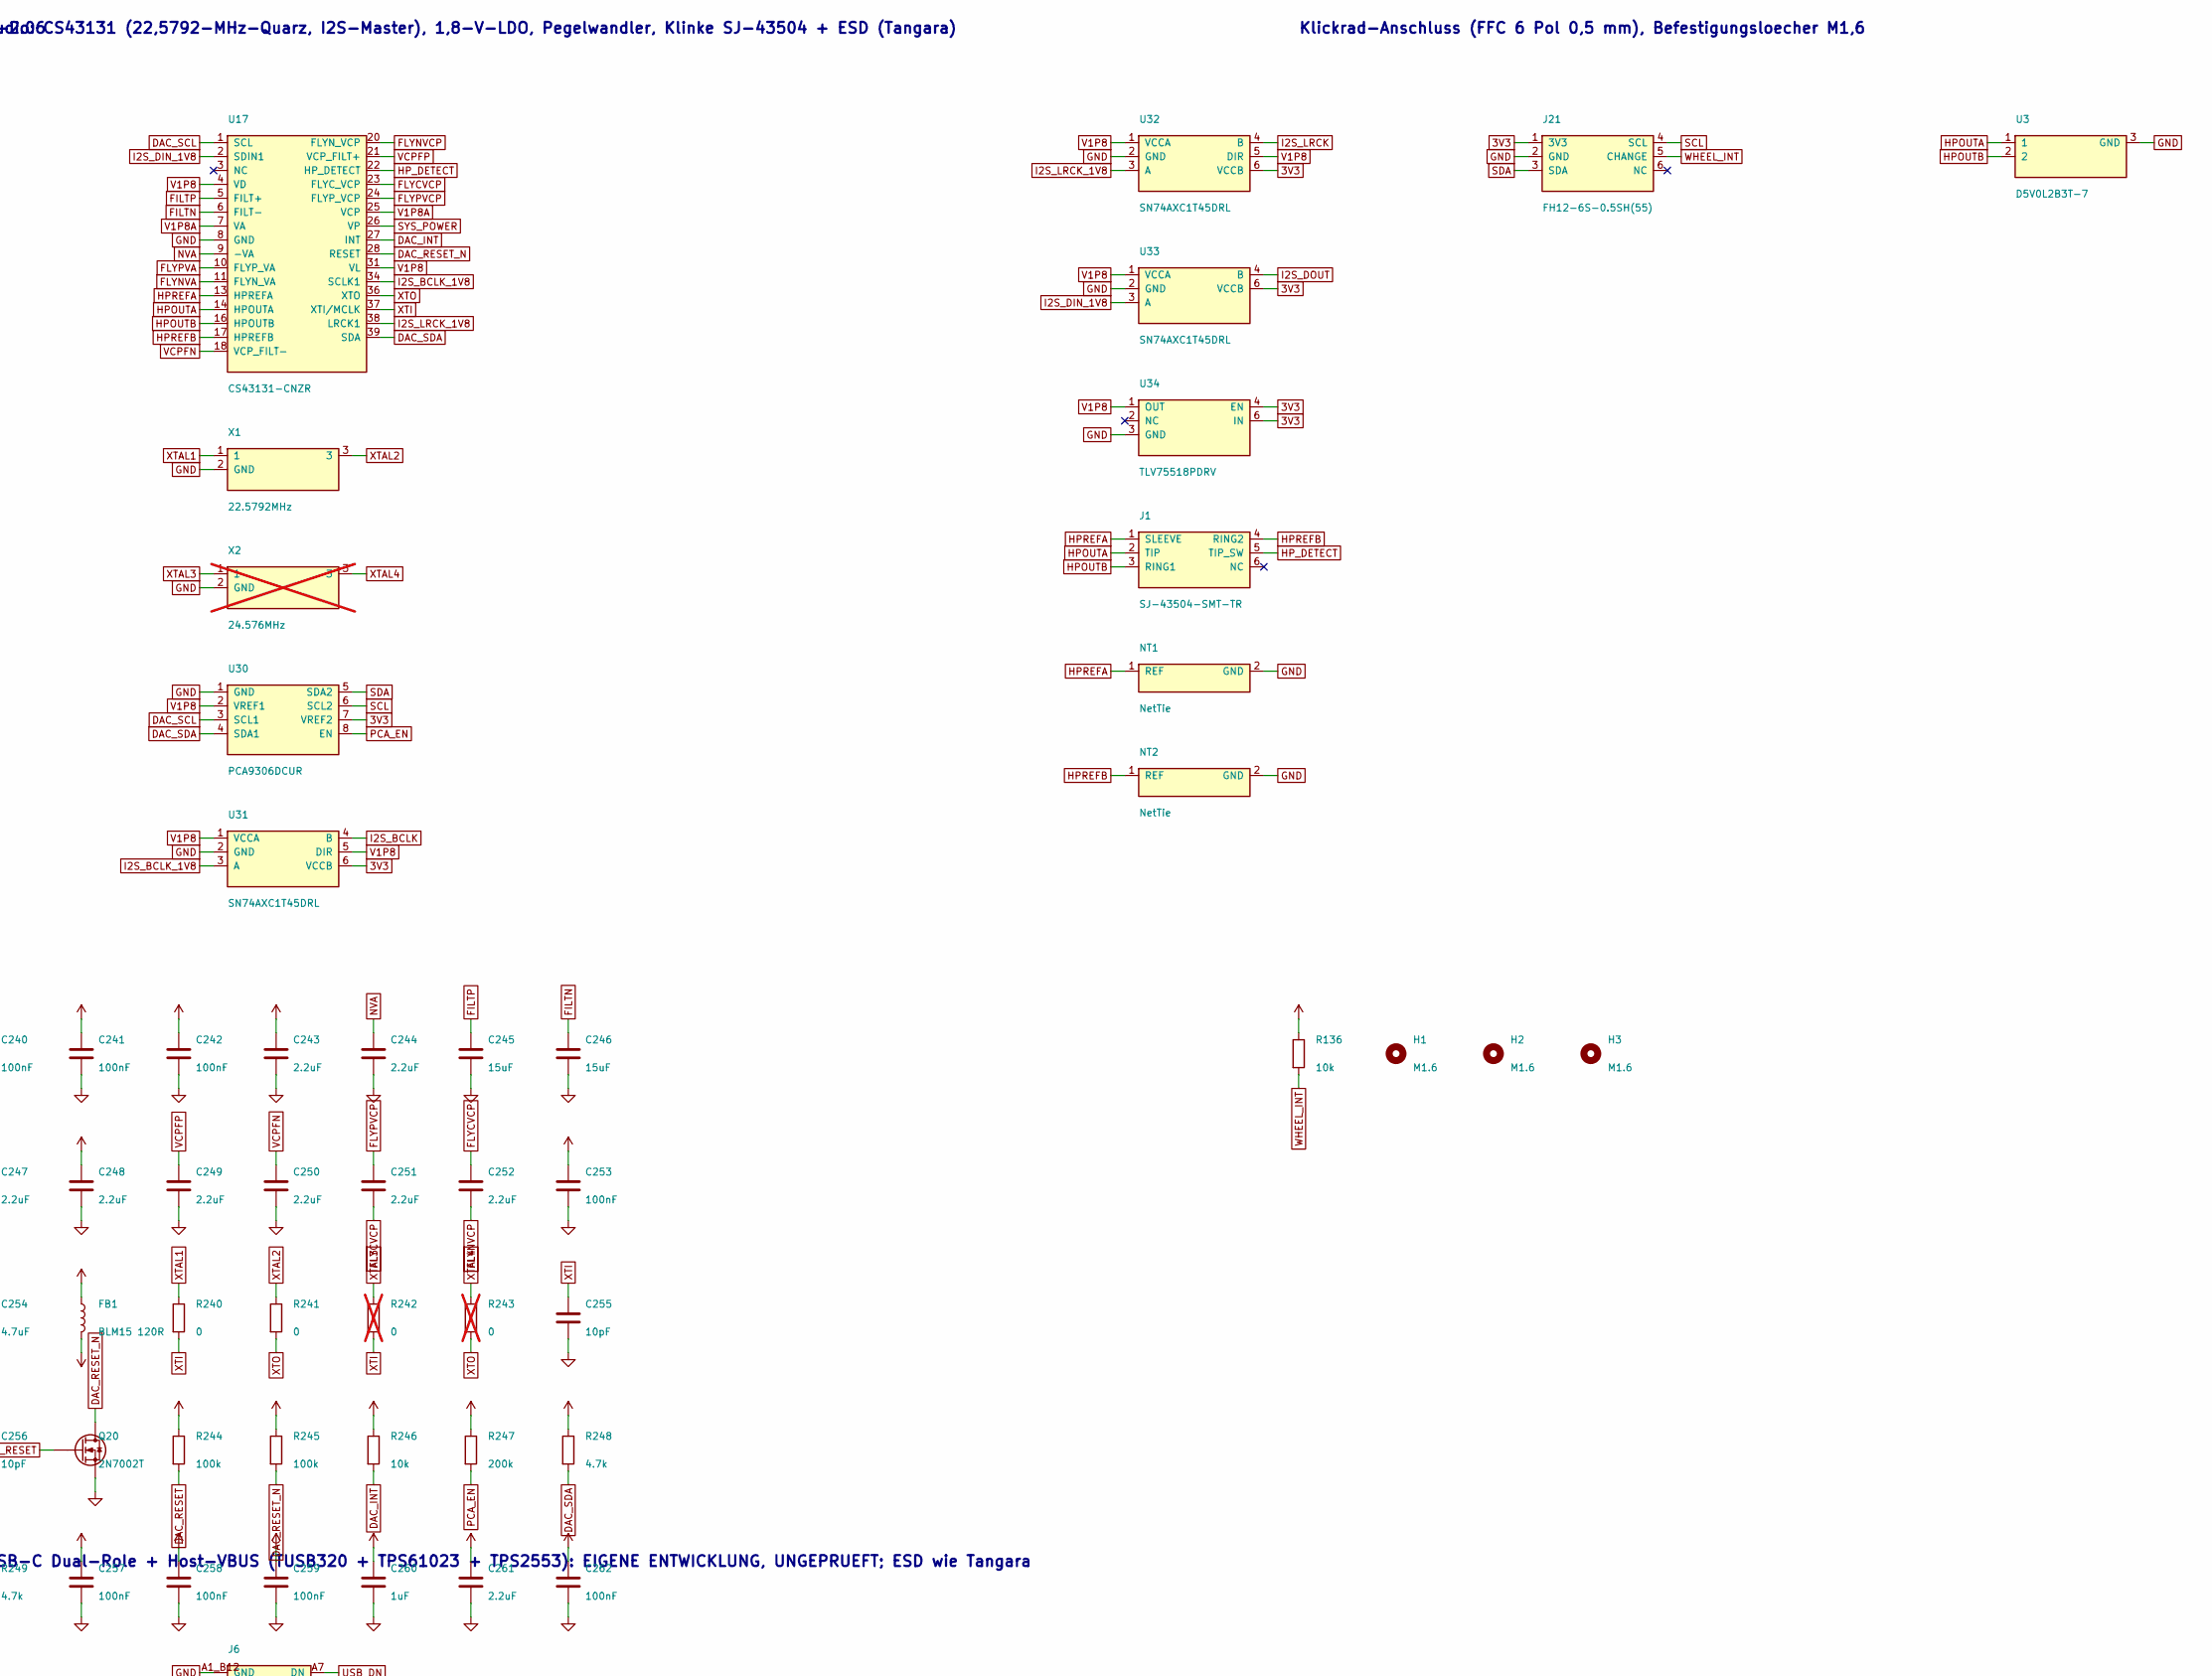
[picture p54: schematic hauptplatine.kicad_sch, Hauptplatine Nano-Player (Endgeraet), Rev. 2, part in row 1, column 2]

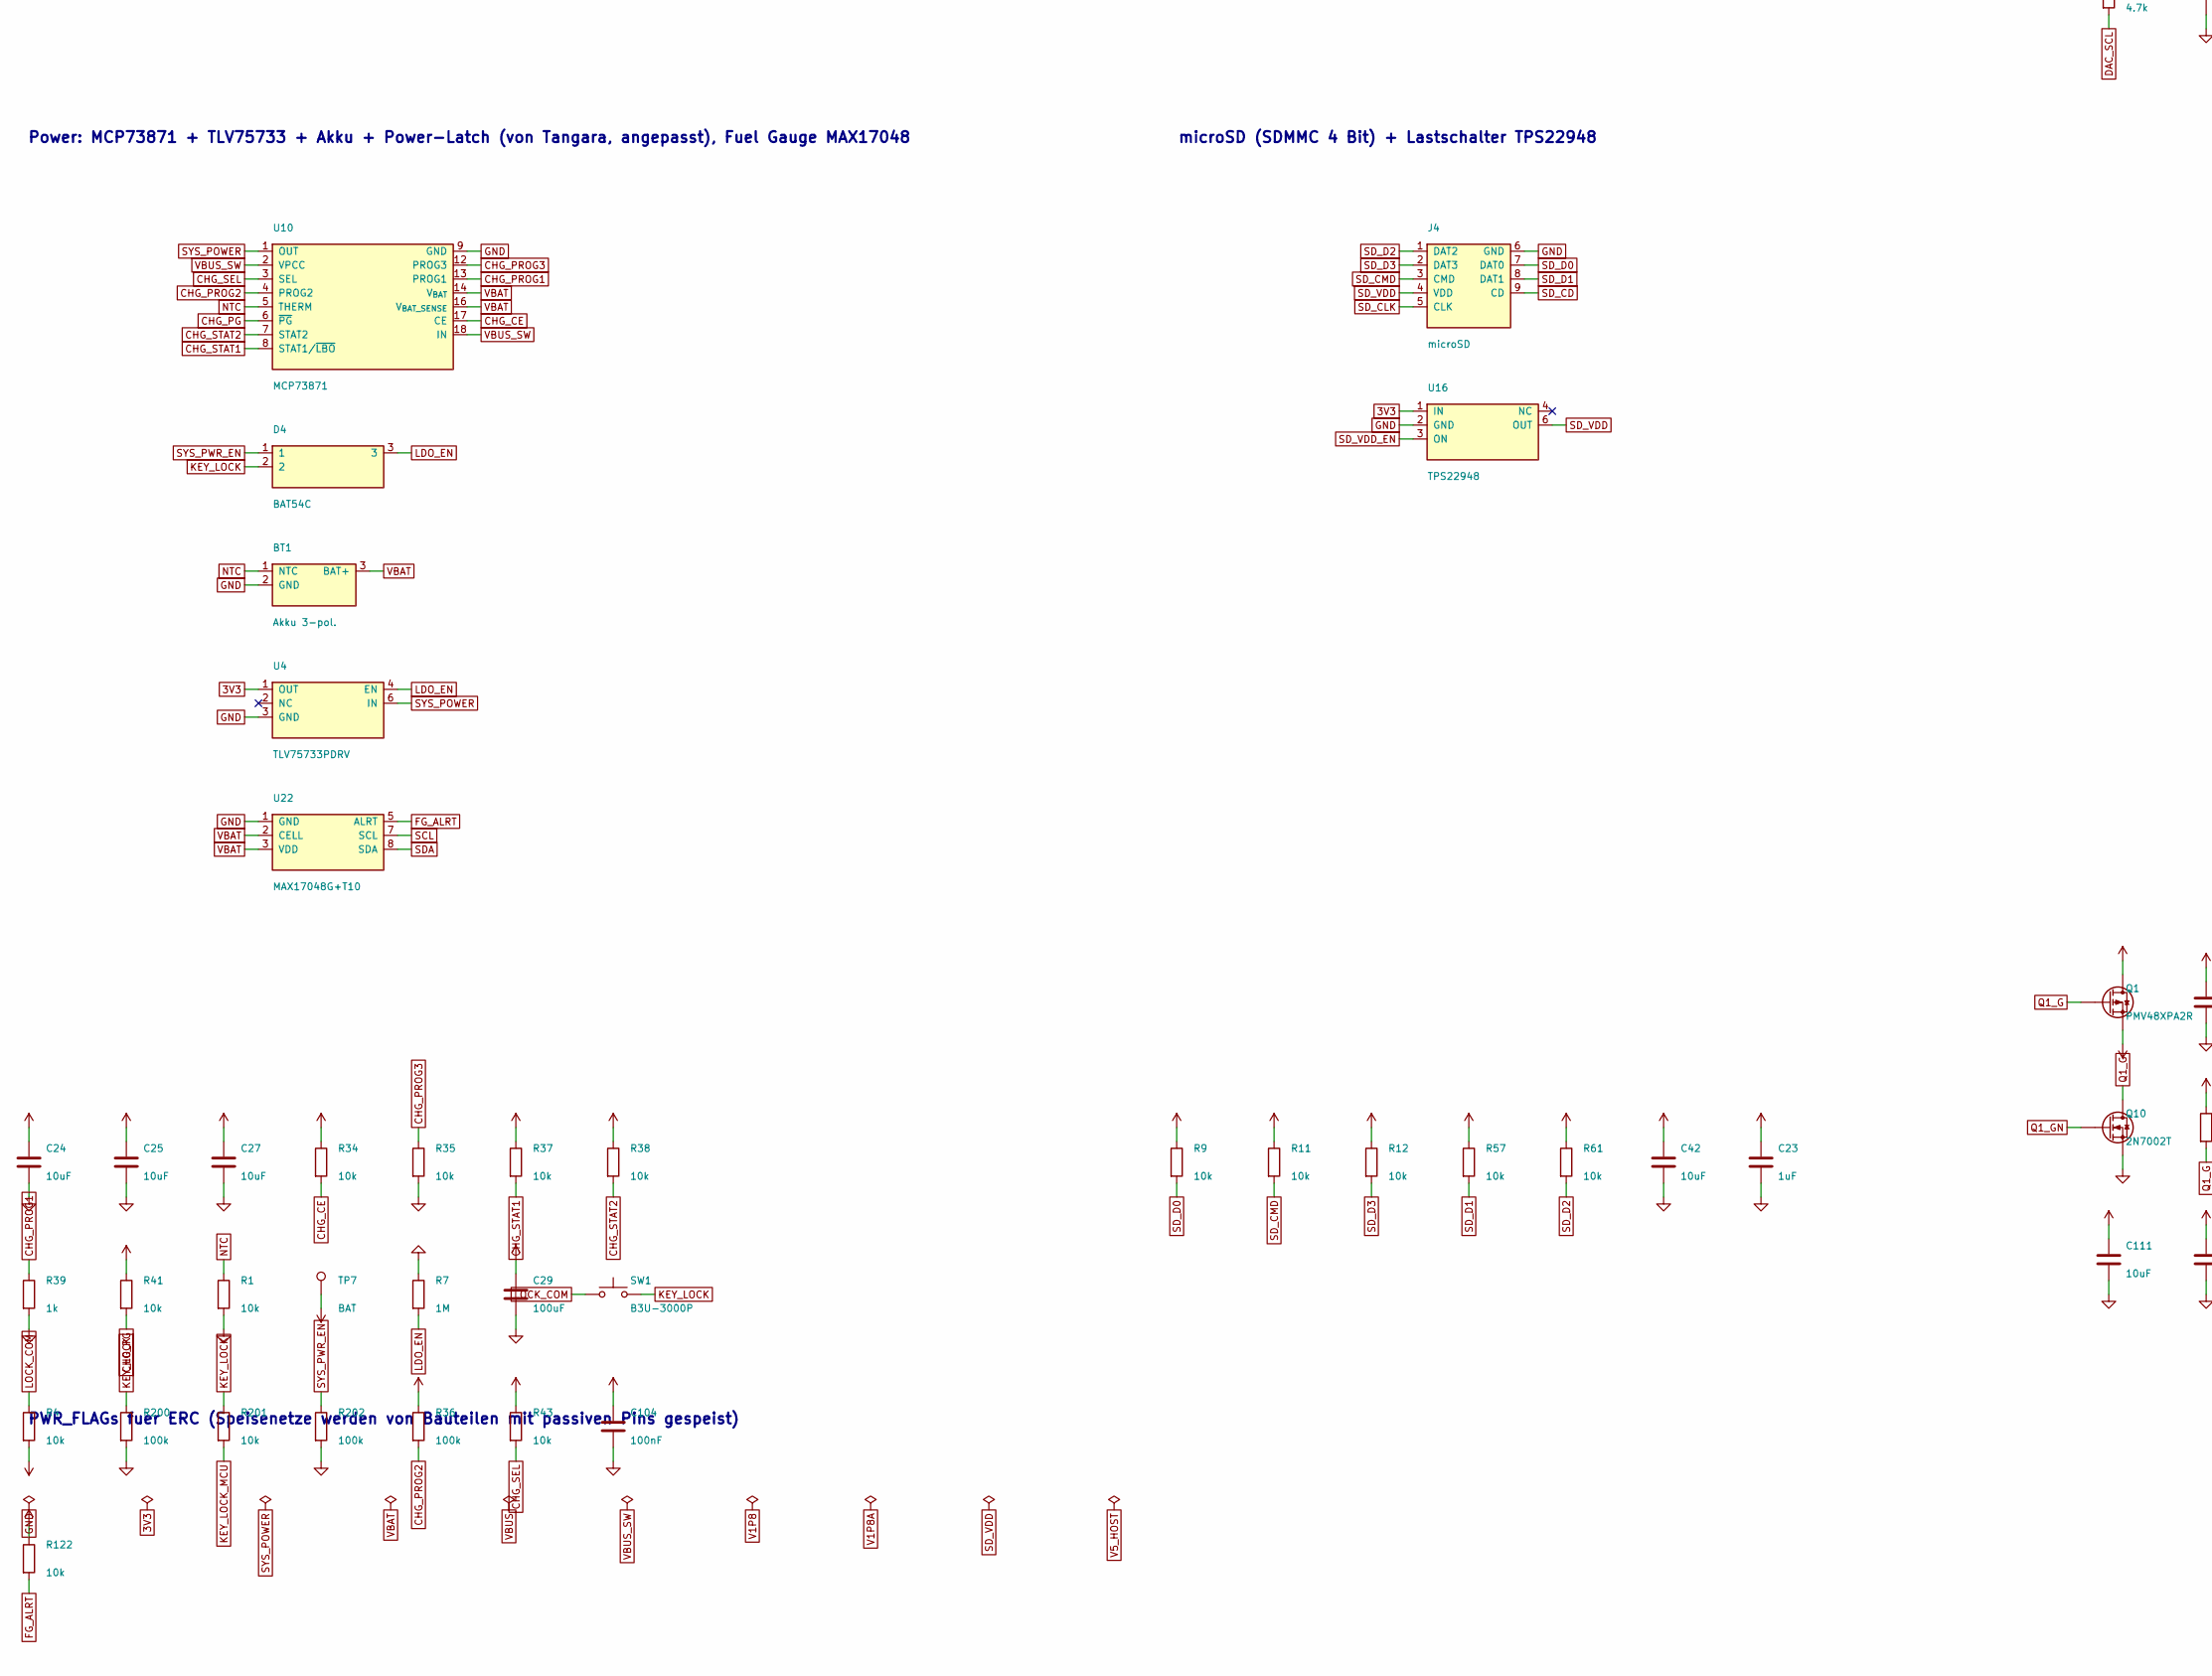
[picture p55: schematic hauptplatine.kicad_sch, Hauptplatine Nano-Player (Endgeraet), Rev. 2, part in row 2, column 1]

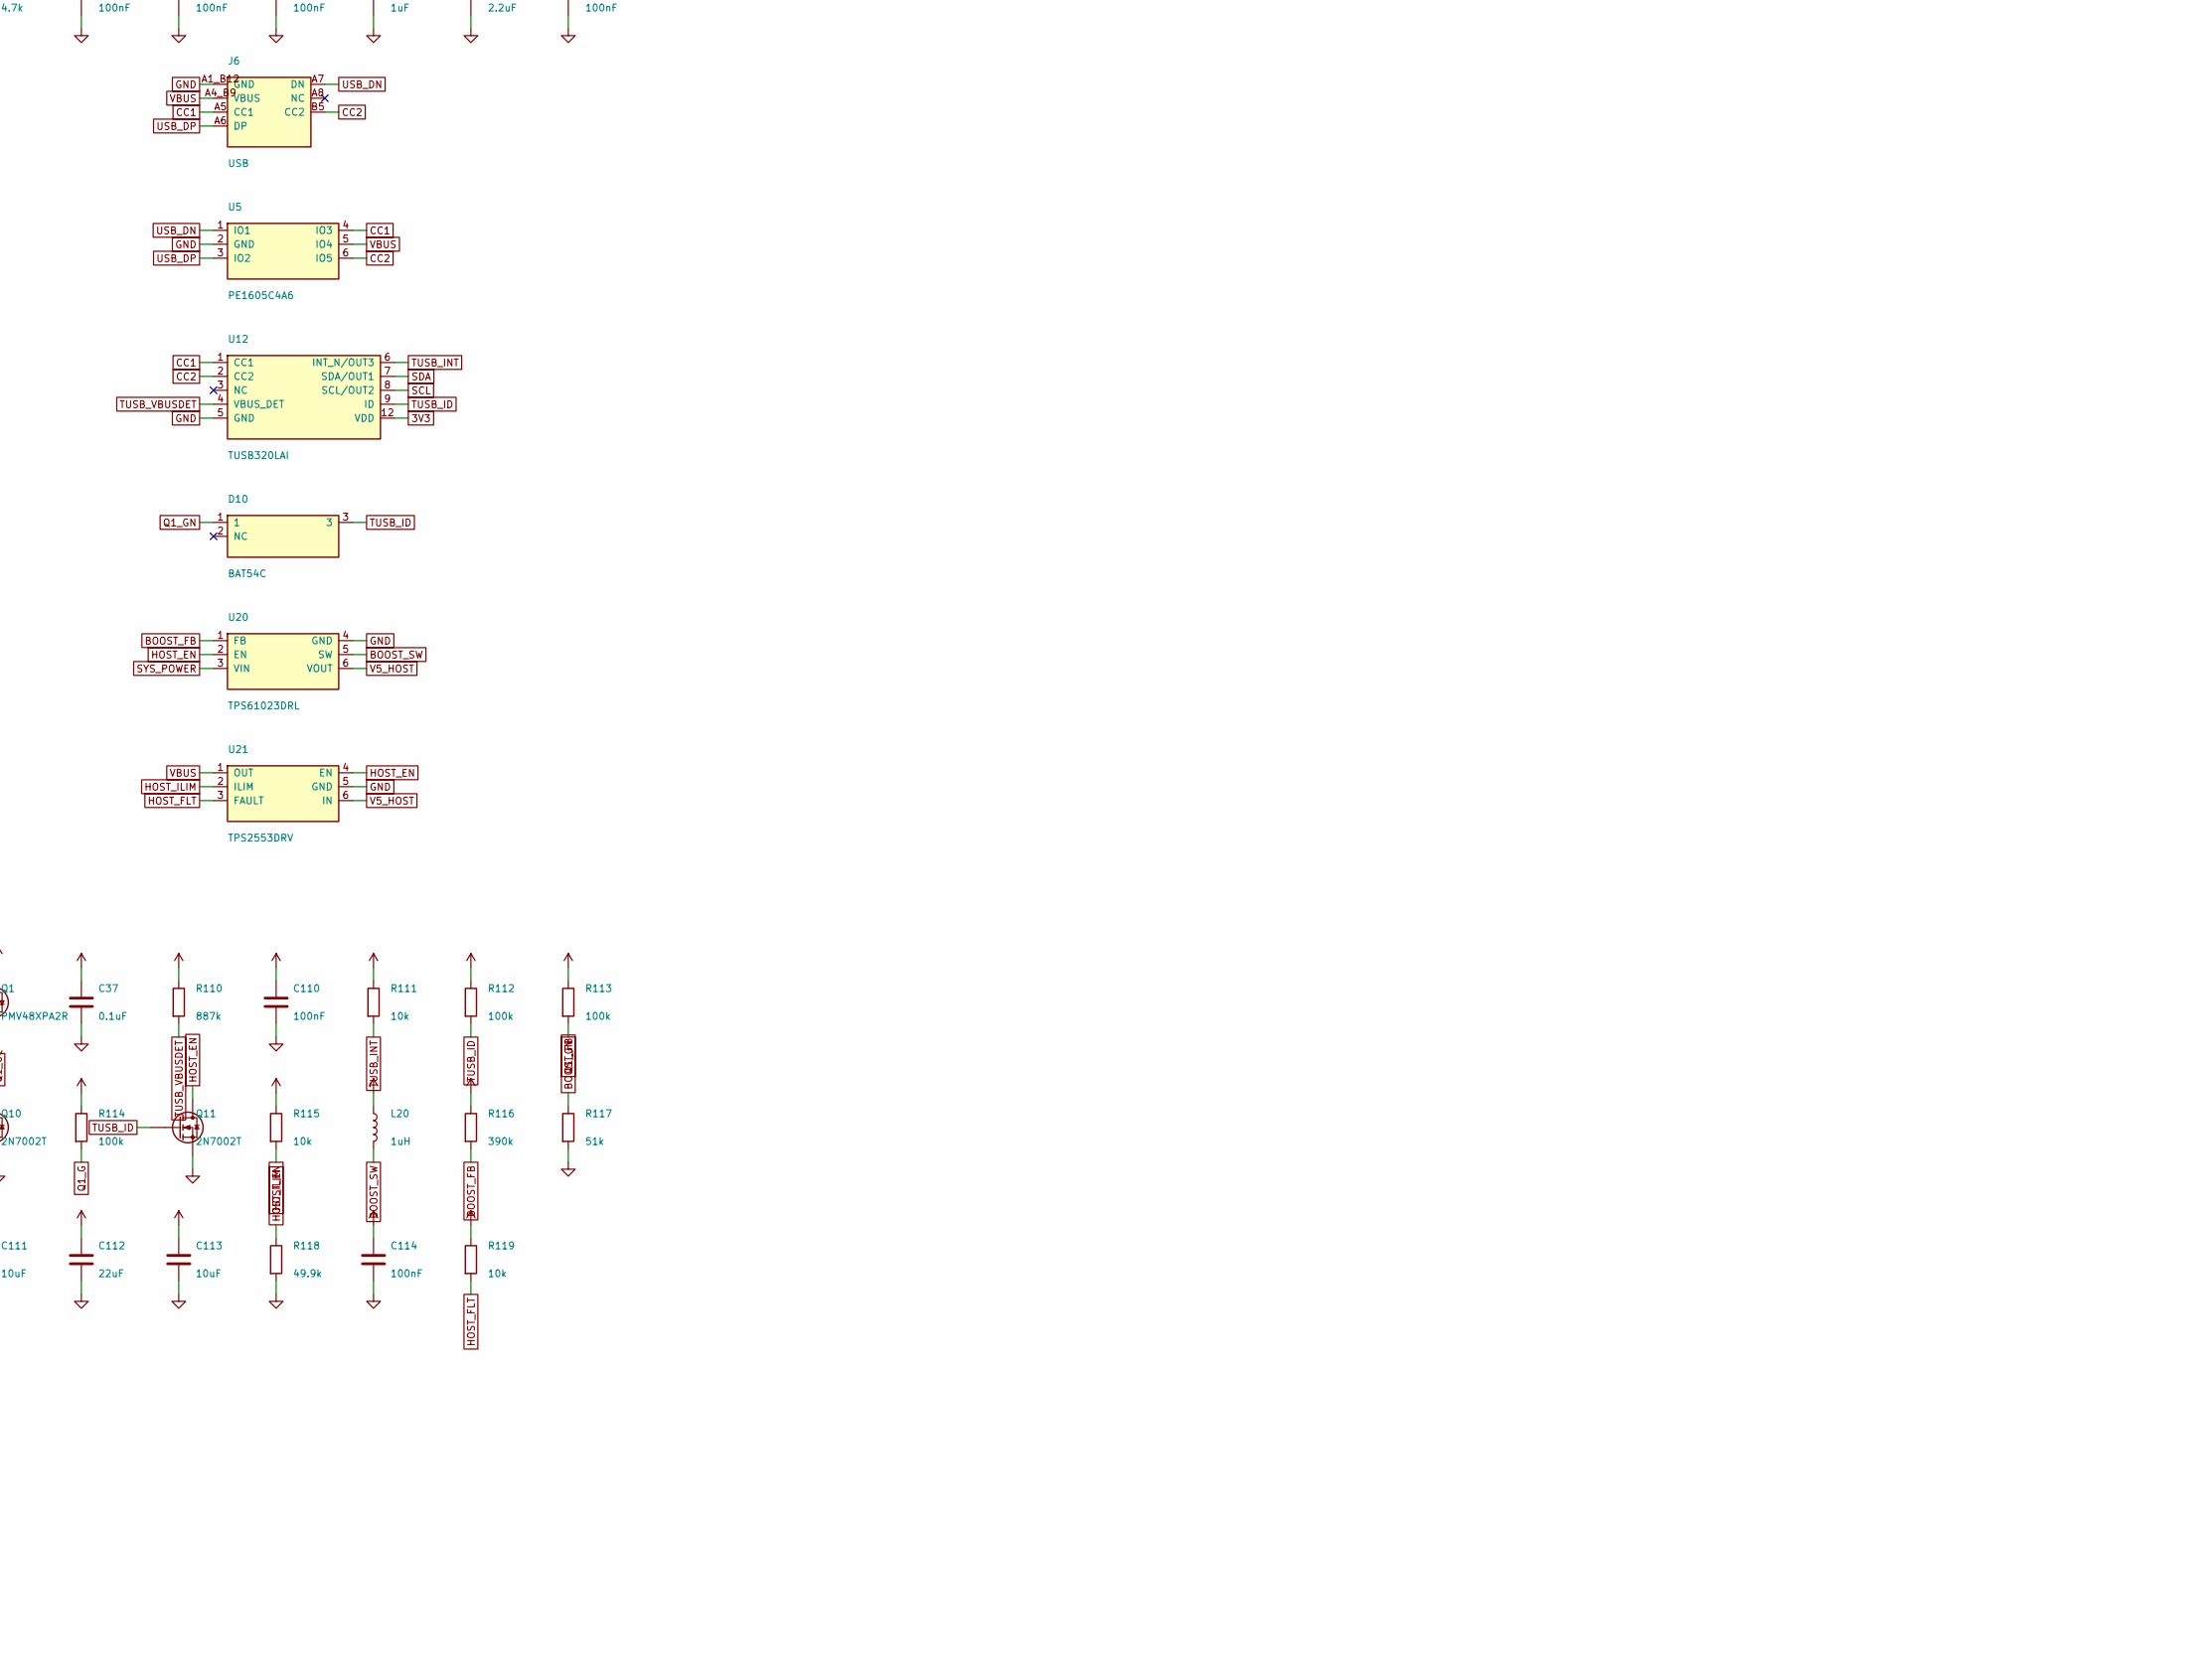
[picture p56: schematic hauptplatine.kicad_sch, Hauptplatine Nano-Player (Endgeraet), Rev. 2, part in row 2, column 2]

Parts:
BT1: Akku 3-pol.; BATT_PADS_3
C23: 1uF; C_0603_1608Metric; MPN GRM188R61A105KA61D
C24, C25, C27, C32, C35, C42, C111, C113: 10uF; C_0603_1608Metric; MPN GRM188R61A106KE69
C29: 100uF; C_1210_3225Metric; MPN GRM32EC70J107ME15K
C30, C34, C37: 0.1uF; C_0603_1608Metric; MPN GCM188R71C104KA37J
C100, C260: 1uF; C_0402_1005Metric; MPN CL05A105KA5NQNC; LCSC C52923
C101, C112: 22uF; C_0603_1608Metric; MPN GRM188R60J226MEA0
C102, C103, C104, C110, C114, C131, C133, C240, C241, C242, C253, C257, C258, C259, C262: 100nF; C_0402_1005Metric; MPN CL05B104KO5NNNC; LCSC C1525
C130, C132: 10uF; C_0402_1005Metric; MPN GRM155R60J106ME05D
C243, C244, C247, C248, C249, C250, C251, C252, C261: 2.2uF; C_0402_1005Metric; MPN GRM155R60J225ME15D
C245, C246: 15uF; C_0603_1608Metric; MPN (15 uF X5R >= 6,3 V 0603, Typ nach Verf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
C254: 4.7uF; C_0603_1608Metric; MPN GRM188R60J475KE19D
C255, C256: 10pF; C_0402_1005Metric; MPN GRM1555C1H100JA01D
D4, D10: BAT54C; SOT-23; MPN BAT54C
FB1: BLM15 120R; L_0402_1005Metric; MPN BLM15AG121SN1D
H1, H2, H3: M1.6; MountingHole_1.8mm
J1: SJ-43504-SMT-TR; CUI_SJ-43504-SMT-TR; MPN SJ-43504-SMT-TR
J4: microSD; microSD_HC_Molex_104031-0811; MPN 104031-0811; DigiKey WM6357DKR-ND
J6: USB; GCT_USB4510-03-1-A_REVA; MPN USB4510-03-1-A
J20: FH12-30S-0.5SH(55); Hirose_FH12-30S-0.5SH_1x30-1MP_P0.50mm_Horizontal; MPN FH12-30S-0.5SH(55)
J21: FH12-6S-0.5SH(55); Hirose_FH12-6S-0.5SH_1x06-1MP_P0.50mm_Horizontal; MPN FH12-6S-0.5SH(55)
L20: 1uH; L_0805_2012Metric; MPN DFE201610E-1R0M=P2
NT1, NT2: NetTie; NetTie-2_SMD_Pad0.5mm
Q1: PMV48XPA2R; TSOT-23; MPN PMV48XPA2R
Q10, Q11, Q20: 2N7002T; SOT-523; MPN 2N7002T-7-F
R1: 10k; R_0603_1608Metric; MPN 0.1W 5%
R4, R9, R11, R12, R34, R35, R37, R38, R41, R43, R57, R61, R201: 10k; R_0603_1608Metric; MPN AC0603JR-0710KL
R7: 1M; R_0603_1608Metric; MPN AC0603FR-131ML
R36, R200, R202: 100k; R_0603_1608Metric; MPN AC0603FR-07100KL
R39: 1k; R_0603_1608Metric; MPN RC0603DR-071KL
R100, R101, R111, R115, R119, R122, R130, R131, R132, R136, R246: 10k; R_0402_1005Metric; MPN 0402WGF1002TCE; LCSC C25744
R102, R103, R240, R241: 0; R_0402_1005Metric; MPN 0402WGF0000TCE; LCSC C17168
R110: 887k; R_0402_1005Metric
R112, R113, R114, R135, R244, R245: 100k; R_0402_1005Metric; MPN 0402WGF1003TCE; LCSC C25741
R116: 390k; R_0402_1005Metric
R117: 51k; R_0402_1005Metric
R118: 49.9k; R_0402_1005Metric
R120, R121: 2.2k; R_0402_1005Metric; MPN 0402WGF2201TCE; LCSC C25879
R134, R248, R249: 4.7k; R_0402_1005Metric; MPN 0402WGF4701TCE; LCSC C25900
R242, R243: 0; R_0402_1005Metric; MPN 0402WGF0000TCE; LCSC C17168; not fitted
R247: 200k; R_0402_1005Metric
SW1: B3U-3000P; SW_SPST_B3U-3000P; MPN B3U-3000P; LCSC C963349
TP7: BAT; TestPoint_Pad_D1.0mm
TP10: TX0; TestPoint_Pad_D1.0mm
TP11: RX0; TestPoint_Pad_D1.0mm
TP12: IO34 USB-JTAG D+; TestPoint_Pad_D1.0mm
TP13: IO33 USB-JTAG D-; TestPoint_Pad_D1.0mm
TP14: EN (gegen TP16 kurzschliessen = Reset); TestPoint_Pad_D1.0mm
TP15: BOOT (gegen TP17 kurzschliessen = Download-Modus); TestPoint_Pad_D1.0mm
TP16: GND neben EN; TestPoint_Pad_D1.0mm
TP17: GND neben BOOT; TestPoint_Pad_D1.0mm
U3: D5V0L2B3T-7; SOT-523; MPN D5V0L2B3T-7
U4: TLV75733PDRV; WSON-6-1EP_2x2mm_P0.65mm_EP1x1.6mm; MPN TLV75733PDRVR
U5: PE1605C4A6; SOT-23-6; MPN PE1605C4A6
U10: MCP73871; QFN-20-1EP_4x4mm_P0.5mm_EP2.5x2.5mm; MPN MCP73871-2CCI/ML
U12: TUSB320LAI; X2QFN-12-RWB; MPN TUSB320LAIRWBR; LCSC C132554
U15: ESP32-S31-WROOM-1-N16R16V; ESP32-S31-WROOM-1; MPN ESP32-S31-WROOM-1-N16R16V
U16: TPS22948; SOT65P210X110-6N; MPN TPS22948DCKR
U17: CS43131-CNZR; QFN-40-1EP_5x5mm_P0.4mm_EP3.6x3.6mm; MPN CS43131-CNZR; DigiKey 598-CS43131-CNZRCT-ND
U20: TPS61023DRL; SOT-563; MPN TPS61023DRLR; LCSC C919459
U21: TPS2553DRV; WSON-6-1EP_2x2mm_P0.65mm_EP1x1.6mm; MPN TPS2553DRVR
U22: MAX17048G+T10; TDFN-8-1EP_2x2mm_P0.5mm_EP0.8x1.2mm; MPN MAX17048G+T10; LCSC C2682616
U30: PCA9306DCUR; VSSOP-8_2.3x2mm_P0.5mm; MPN PCA9306DCUR
U31, U32, U33: SN74AXC1T45DRL; SOT-563; MPN SN74AXC1T45DRLR
U34: TLV75518PDRV; WSON-6-1EP_2x2mm_P0.65mm_EP1x1.6mm; MPN TLV75518PDRVR
X1: 22.5792MHz; Crystal_SMD_2016-4Pin_2.0x1.6mm; MPN NX2016SA 22.5792M EXS00A-CS09116
X2: 24.576MHz; Crystal_SMD_2016-4Pin_2.0x1.6mm; MPN NX2016SA 24.576M EXS00A-CS09117; not fitted

Connections:
3V3: C23.1, C29.1, C30.1, C32.2, C34.1, C35.2, C101.1, C102.1, C110.1, C130.1, C131.1, C132.1, C133.1, C257.1, C258.1, C259.1, C260.1, J20.11 (TP_VDD), J20.23 (VCI), J20.25 (VDDIO), J20.29 (3V3), J20.30 (3V3), J21.1 (3V3), R36.1, R37.1, R38.1, R41.1, R43.1, R100.1, R101.1, R111.1, R112.1, R115.1, R119.1, R120.1, R121.1, R122.1, R130.1, R132.1, R134.1, R135.1, R136.1, R244.1, R246.1, R247.1, U4.1 (OUT), U12.12 (VDD), U15.2 (3V3), U16.1 (IN), U30.7 (VREF2), U31.6 (VCCB), U32.6 (VCCB), U33.6 (VCCB), U34.4 (EN), U34.6 (IN)
BOOST_FB: R116.2, R117.1, U20.1 (FB)
BOOST_SW: L20.2, U20.5 (SW)
BOOT: C103.1, R101.2, TP15.1, U15.27 (IO61)
CC1: J6.A5 (CC1), U5.4 (IO3), U12.1 (CC1)
CC2: J6.B5 (CC2), U5.6 (IO5), U12.2 (CC2)
CHG_CE: R34.2, U10.17 (CE)
CHG_PG: R41.2, U10.6 (~PG), U15.30 (IO44)
CHG_PROG1: R39.1, U10.13 (PROG1)
CHG_PROG2: R36.2, U10.4 (PROG2), U15.32 (IO46)
CHG_PROG3: R35.1, U10.12 (PROG3)
CHG_SEL: R43.2, U10.3 (SEL), U15.35 (IO55)
CHG_STAT1: R37.2, U10.8 (STAT1/~LBO), U15.31 (IO45)
CHG_STAT2: R38.2, U10.7 (STAT2), U15.33 (IO47)
DAC_INT: R246.2, U15.56 (IO48), U17.27 (INT)
DAC_RESET: Q20.1 (G), R244.2, U15.17 (IO22)
DAC_RESET_N: Q20.3 (D), R245.2, U17.28 (RESET)
DAC_SCL: R249.2, U17.1 (SCL), U30.3 (SCL1)
DAC_SDA: R248.2, U17.39 (SDA), U30.4 (SDA1)
ESP_EN: C100.1, R100.2, TP14.1, U15.3 (EN)
FG_ALRT: R122.2, U15.29 (IO43), U22.5 (ALRT)
FILTN: C246.1, U17.6 (FILT-)
FILTP: C245.1, U17.5 (FILT+)
FLYCVCP: C251.2, C252.1, U17.23 (FLYC_VCP)
FLYNVA: C247.2, U17.11 (FLYN_VA)
FLYNVCP: C252.2, U17.20 (FLYN_VCP)
FLYPVA: C247.1, U17.10 (FLYP_VA)
FLYPVCP: C251.1, U17.24 (FLYP_VCP)
GND: BT1.2 (GND), C23.2, C24.2, C25.2, C27.2, C29.2, C30.2, C32.1, C34.2, C35.1, C37.2, C42.2, C100.2, C101.2, C102.2, C103.2, C104.2, C110.2, C111.2, C112.2, C113.2, C114.2, C130.2, C131.2, C132.2, C133.2, C240.2, C241.2, C242.2, C243.2, C244.2, C245.2, C246.2, C248.2, C249.2, C250.2, C253.2, C254.2, C255.2, C256.2, C257.2, C258.2, C259.2, C260.2, C261.2, C262.2, J4.6 (GND), J4.10 (GND), J4.11 (GND), J6.A1_B12 (GND), J6.B1_A12 (GND), J6.S1 (GND), J6.S2 (GND), J6.S3 (GND), J6.S4 (GND), J20.1 (GND), J20.2 (GND), J20.16 (GND), J20.18 (GND), J20.20 (GND), J20.22 (GND), J20.24 (GND), J20.26 (GND), J20.28 (GND), J20.MP (GND), J21.2 (GND), J21.MP (GND), NT1.2 (GND), NT2.2 (GND), Q10.2 (S), Q11.2 (S), Q20.2 (S), R1.2, R7.1, R35.2, R39.2, R117.2, R118.2, R131.2, R200.2, R202.2, TP16.1, TP17.1, U3.3 (GND), U4.3 (GND), U4.7 (GND), U5.2 (GND), U10.9 (GND), U10.10 (GND), U10.11 (GND), U10.21 (GND), U12.5 (GND), U12.10 (GND), U12.11 (GND), U15.1 (GND), U15.40 (GND), U15.41 (GND), U16.2 (GND), U16.5 (GND), U17.8 (GND), U17.19 (GND), U17.30 (GND), U17.35 (GND), U17.41 (GND), U20.4 (GND), U21.5 (GND), U21.7 (GND), U22.1 (GND), U22.4 (GND), U22.6 (GND), U22.9 (GND), U30.1 (GND), U31.2 (GND), U32.2 (GND), U33.2 (GND), U33.5 (GND), U34.3 (GND), U34.7 (GND), X1.2 (GND), X1.4 (GND), X2.2 (GND), X2.4 (GND)
HOST_EN: Q11.3 (D), R115.2, U15.19 (IO24), U20.2 (EN), U21.4 (EN)
HOST_FLT: R119.2, U21.3 (FAULT)
HOST_ILIM: R118.1, U21.2 (ILIM)
HPOUTA: J1.2 (TIP), U3.1, U17.14 (HPOUTA)
HPOUTB: J1.3 (RING1), U3.2, U17.16 (HPOUTB)
HPREFA: J1.1 (SLEEVE), NT1.1 (REF), U17.13 (HPREFA)
HPREFB: J1.4 (RING2), NT2.1 (REF), U17.17 (HPREFB)
HP_DETECT: J1.5 (TIP_SW), U17.22 (HP_DETECT)
I2S_BCLK: U15.44 (IO10), U31.4 (B)
I2S_BCLK_1V8: U17.34 (SCLK1), U31.3 (A)
I2S_DIN_1V8: U17.2 (SDIN1), U33.3 (A)
I2S_DOUT: U15.51 (IO17), U33.4 (B)
I2S_LRCK: U15.53 (IO19), U32.4 (B)
I2S_LRCK_1V8: U17.38 (LRCK1), U32.3 (A)
KEY_LOCK: D4.2, R200.1, R201.1, SW1.2
KEY_LOCK_MCU: R201.2, U15.10 (IO6)
LCD_CS: J20.6 (LCD_CS), U15.61 (IO53)
LCD_D0: J20.14 (QSPI_SIO0), U15.57 (IO49)
LCD_D1: J20.12 (QSPI_SIO1), U15.58 (IO50)
LCD_D2: J20.10 (QSPI_SIO2), U15.59 (IO51)
LCD_D3: J20.8 (QSPI_SIO3), U15.43 (IO9)
LCD_IM0: J20.17 (IM0), R131.1
LCD_IM1: J20.15 (IM1), R130.2
LCD_PWR_EN: J20.21 (DSI_PWR_EN), R134.2
LCD_RST: J20.19 (LCD_RESET), R135.2, U15.18 (IO23)
LCD_SCK: J20.4 (QSPI_SCL), U15.42 (IO8)
LCD_TE: J20.27 (LCD_TE), U15.52 (IO18)
LDO_EN: D4.3, R7.2, U4.4 (EN)
LOCK_COM: R4.1, SW1.1
NTC: BT1.1 (NTC), R1.1, U10.5 (THERM)
NVA: C244.1, U17.9 (-VA)
PCA_EN: R247.2, U30.8 (EN)
Q1_G: Q1.1 (G), Q10.3 (D), R114.2
Q1_GN: D10.1, Q10.1 (G), R113.2
SCL: J20.3 (TP_SCL), J21.4 (SCL), R121.2, U12.8 (SCL/OUT2), U15.20 (IO25), U22.7 (SCL), U30.6 (SCL2)
SDA: J20.5 (TP_SDA), J21.3 (SDA), R120.2, U12.7 (SDA/OUT1), U15.28 (IO42), U22.8 (SDA), U30.5 (SDA2)
SD_CD: J4.9 (CD), U15.38 (IO56)
SD_CLK: J4.5 (CLK), U15.24 (IO39)
SD_CMD: J4.3 (CMD), R11.2, U15.25 (IO40)
SD_D0: J4.7 (DAT0), R9.2, U15.12 (IO35)
SD_D1: J4.8 (DAT1), R57.2, U15.21 (IO36)
SD_D2: J4.1 (DAT2), R61.2, U15.22 (IO37)
SD_D3: J4.2 (DAT3), R12.2, U15.23 (IO38)
SD_VDD: C42.1, J4.4 (VDD), R9.1, R11.1, R12.1, R57.1, R61.1, U16.6 (OUT)
SD_VDD_EN: U15.34 (IO54), U16.3 (ON)
SYS_POWER: C24.1, C111.1, C253.1, C254.1, L20.1, R4.2, R34.1, R245.1, U4.6 (IN), U10.1 (OUT), U10.20 (OUT), U17.26 (VP), U20.3 (VIN)
SYS_PWR_EN: D4.1, R202.1, U15.9 (IO1)
TP_INT: J20.7 (TP_INT), U15.60 (IO52)
TP_RST: J20.9 (TP_RESET), R132.2
TUSB_ID: D10.3, Q11.1 (G), R112.2, U12.9 (ID), U15.16 (IO21)
TUSB_INT: R111.2, U12.6 (INT_N/OUT3), U15.15 (IO20)
TUSB_VBUSDET: R110.2, U12.4 (VBUS_DET)
UART_RX0: TP11.1, U15.36 (RX0)
UART_TX0: TP10.1, U15.37 (TX0)
USBJ_DM: TP13.1, U15.13 (IO33)
USBJ_DP: TP12.1, U15.14 (IO34)
USB_DN: J6.A7 (DN), J6.B7 (DN), R103.1, U5.1 (IO1)
USB_DP: J6.A6 (DP), J6.B6 (DP), R102.1, U5.3 (IO2)
USB_HS_DM: R103.2, U15.54 (DM)
USB_HS_DP: R102.2, U15.55 (DP)
V1P8: C240.1, C241.1, C261.1, C262.1, FB1.1, R248.1, R249.1, U17.4 (VD), U17.31 (VL), U30.2 (VREF1), U31.1 (VCCA), U31.5 (DIR), U32.1 (VCCA), U32.5 (DIR), U33.1 (VCCA), U34.1 (OUT)
V1P8A: C242.1, C243.1, C248.1, FB1.2, U17.7 (VA), U17.25 (VCP)
V5_HOST: C112.1, C113.1, C114.1, R116.1, U20.6 (VOUT), U21.6 (IN)
VBAT: BT1.3 (BAT+), C25.1, C104.1, TP7.1, U10.14 (V_{BAT}), U10.15 (V_{BAT}), U10.16 (V_{BAT_SENSE}), U22.2 (CELL), U22.3 (VDD)
VBUS: C37.1, J6.A4_B9 (VBUS), J6.B4_A9 (VBUS), Q1.2 (S), R110.1, R113.1, R114.1, U5.5 (IO4), U21.1 (OUT)
VBUS_SW: C27.1, Q1.3 (D), U10.2 (VPCC), U10.18 (IN), U10.19 (IN)
VCPFN: C250.1, U17.18 (VCP_FILT-)
VCPFP: C249.1, U17.21 (VCP_FILT+)
WHEEL_INT: J21.5 (CHANGE), R136.2, U15.11 (IO7)
XTAL1: R240.1, X1.1
XTAL2: R241.1, X1.3
XTAL3: R242.1, X2.1
XTAL4: R243.1, X2.3
XTI: C255.1, R240.2, R242.2, U17.37 (XTI/MCLK)
XTO: C256.1, R241.2, R243.2, U17.36 (XTO)

Notes on the sheet:
ESP32-S31-WROOM-1 (Espressif-Beschaltung)
AMOLED 2,06 Zoll 410 x 502 (CO5300, QSPI): FPC 30 Pol, Belegung wie Waveshare ESP32-S3-Touch-AMOLED-2.06
Audio: CS43131 (22,5792-MHz-Quarz, I2S-Master), 1,8-V-LDO, Pegelwandler, Klinke SJ-43504 + ESD (Tangara)
Power: MCP73871 + TLV75733 + Akku + Power-Latch (von Tangara, angepasst), Fuel Gauge MAX17048
USB-C Dual-Role + Host-VBUS (TUSB320 + TPS61023 + TPS2553): EIGENE ENTWICKLUNG, UNGEPRUEFT; ESD wie Tangara
microSD (SDMMC 4 Bit) + Lastschalter TPS22948
Klickrad-Anschluss (FFC 6 Pol 0,5 mm), Befestigungsloecher M1,6
PWR_FLAGs fuer ERC (Speisenetze werden von Bauteilen mit passiven Pins gespeist)

Board: 4 copper layers, 153 parts (16 on the bottom side), 104 nets, no tracks yet.

Other parts of the board:
FID1, FID2, FID3, FID4, FID5, FID6: Fiducial; Fiducial_1mm_Mask2mm
