robinrehbein/tangara/firmware-s31-test/d_i2s_slave/main/main.c

/* Machbarkeitstest S31: I2S std, Slave, 32 Bit, TX (BCLK/WS vom Codec/Host) */
#include "driver/i2s_std.h"
void app_main(void)
{
    i2s_chan_handle_t tx;
    i2s_chan_config_t cc = I2S_CHANNEL_DEFAULT_CONFIG(I2S_NUM_AUTO, I2S_ROLE_SLAVE);
    ESP_ERROR_CHECK(i2s_new_channel(&cc, &tx, NULL));
    i2s_std_config_t sc = {
        .clk_cfg = I2S_STD_CLK_DEFAULT_CONFIG(44100),
        .slot_cfg = I2S_STD_PHILIPS_SLOT_DEFAULT_CONFIG(I2S_DATA_BIT_WIDTH_32BIT, I2S_SLOT_MODE_STEREO),
        .gpio_cfg = {.mclk = I2S_GPIO_UNUSED, .bclk = 4, .ws = 5, .dout = 6, .din = I2S_GPIO_UNUSED},
    };
    ESP_ERROR_CHECK(i2s_channel_init_std_mode(tx, &sc));
    ESP_ERROR_CHECK(i2s_channel_enable(tx));
    sc.slot_cfg.data_bit_width = I2S_DATA_BIT_WIDTH_24BIT;
}
