robinrehbein/tangara/firmware-s31-test/f_firmware_copy/components/drv2605l/include/drv2605l_effects.h

/*
 * Copyright 2023 jacqueline <me@jacqueline.id.au>, robin <robin@rhoward.id.au>
 * (Effektliste aus Tangara: src/drivers/include/drivers/haptics.hpp, cool tech zone)
 * Portiert nach C für den Nano-Player.
 *
 * SPDX-License-Identifier: GPL-3.0-only
 */
#pragma once

/** DRV2605L-Effekte der LRA-/ERM-Bibliotheken, Datenblatt Abschnitt 12.1.2 "Waveform Library Effects List". */
typedef enum {
    DRV2605L_FX_STOP = 0,
    DRV2605L_FX_STRONG_CLICK_100_PCT = 1,
    DRV2605L_FX_STRONG_CLICK_60_PCT = 2,
    DRV2605L_FX_STRONG_CLICK_30_PCT = 3,
    DRV2605L_FX_SHARP_CLICK_100_PCT = 4,
    DRV2605L_FX_SHARP_CLICK_60_PCT = 5,
    DRV2605L_FX_SHARP_CLICK_30_PCT = 6,
    DRV2605L_FX_SOFT_BUMP_100_PCT = 7,
    DRV2605L_FX_SOFT_BUMP_60_PCT = 8,
    DRV2605L_FX_SOFT_BUMP_30_PCT = 9,
    DRV2605L_FX_DOUBLE_CLICK_100_PCT = 10,
    DRV2605L_FX_DOUBLE_CLICK_60_PCT = 11,
    DRV2605L_FX_TRIPLE_CLICK_100_PCT = 12,
    DRV2605L_FX_SOFT_FUZZ_60_PCT = 13,
    DRV2605L_FX_STRONG_BUZZ_100_PCT = 14,
    DRV2605L_FX_750MS_ALERT_100_PCT = 15,
    DRV2605L_FX_1000MS_ALERT_100_PCT = 16,
    DRV2605L_FX_STRONG_CLICK1_100_PCT = 17,
    DRV2605L_FX_STRONG_CLICK2_80_PCT = 18,
    DRV2605L_FX_STRONG_CLICK3_60_PCT = 19,
    DRV2605L_FX_STRONG_CLICK4_30_PCT = 20,
    DRV2605L_FX_MEDIUM_CLICK1_100_PCT = 21,
    DRV2605L_FX_MEDIUM_CLICK2_80_PCT = 22,
    DRV2605L_FX_MEDIUM_CLICK3_60_PCT = 23,
    DRV2605L_FX_SHARP_TICK1_100_PCT = 24,
    DRV2605L_FX_SHARP_TICK2_80_PCT = 25,
    DRV2605L_FX_SHARP_TICK3_60_PCT = 26,
    DRV2605L_FX_SHORT_DOUBLE_CLICK_STRONG1_100_PCT = 27,
    DRV2605L_FX_SHORT_DOUBLE_CLICK_STRONG2_80_PCT = 28,
    DRV2605L_FX_SHORT_DOUBLE_CLICK_STRONG3_60_PCT = 29,
    DRV2605L_FX_SHORT_DOUBLE_CLICK_STRONG4_30_PCT = 30,
    DRV2605L_FX_SHORT_DOUBLE_CLICK_MEDIUM1_100_PCT = 31,
    DRV2605L_FX_SHORT_DOUBLE_CLICK_MEDIUM2_80_PCT = 32,
    DRV2605L_FX_SHORT_DOUBLE_CLICK_MEDIUM3_60_PCT = 33,
    DRV2605L_FX_SHORT_DOUBLE_SHARP_TICK1_100_PCT = 34,
    DRV2605L_FX_SHORT_DOUBLE_SHARP_TICK2_80_PCT = 35,
    DRV2605L_FX_SHORT_DOUBLE_SHARP_TICK3_60_PCT = 36,
    DRV2605L_FX_LONG_DOUBLE_SHARP_CLICK_STRONG1_100_PCT = 37,
    DRV2605L_FX_LONG_DOUBLE_SHARP_CLICK_STRONG2_80_PCT = 38,
    DRV2605L_FX_LONG_DOUBLE_SHARP_CLICK_STRONG3_60_PCT = 39,
    DRV2605L_FX_LONG_DOUBLE_SHARP_CLICK_STRONG4_30_PCT = 40,
    DRV2605L_FX_LONG_DOUBLE_SHARP_CLICK_MEDIUM1_100_PCT = 41,
    DRV2605L_FX_LONG_DOUBLE_SHARP_CLICK_MEDIUM2_80_PCT = 42,
    DRV2605L_FX_LONG_DOUBLE_SHARP_CLICK_MEDIUM3_60_PCT = 43,
    DRV2605L_FX_LONG_DOUBLE_SHARP_TICK1_100_PCT = 44,
    DRV2605L_FX_LONG_DOUBLE_SHARP_TICK2_80_PCT = 45,
    DRV2605L_FX_LONG_DOUBLE_SHARP_TICK3_60_PCT = 46,
    DRV2605L_FX_BUZZ1_100_PCT = 47,
    DRV2605L_FX_BUZZ2_80_PCT = 48,
    DRV2605L_FX_BUZZ3_60_PCT = 49,
    DRV2605L_FX_BUZZ4_40_PCT = 50,
    DRV2605L_FX_BUZZ5_20_PCT = 51,
    DRV2605L_FX_PULSING_STRONG1_100_PCT = 52,
    DRV2605L_FX_PULSING_STRONG2_60_PCT = 53,
    DRV2605L_FX_PULSING_MEDIUM1_100_PCT = 54,
    DRV2605L_FX_PULSING_MEDIUM2_60_PCT = 55,
    DRV2605L_FX_PULSING_SHARP1_100_PCT = 56,
    DRV2605L_FX_PULSING_SHARP2_60_PCT = 57,
    DRV2605L_FX_TRANSITION_CLICK1_100_PCT = 58,
    DRV2605L_FX_TRANSITION_CLICK2_80_PCT = 59,
    DRV2605L_FX_TRANSITION_CLICK3_60_PCT = 60,
    DRV2605L_FX_TRANSITION_CLICK4_40_PCT = 61,
    DRV2605L_FX_TRANSITION_CLICK5_20_PCT = 62,
    DRV2605L_FX_TRANSITION_CLICK6_10_PCT = 63,
    DRV2605L_FX_TRANSITION_HUM1_100_PCT = 64,
    DRV2605L_FX_TRANSITION_HUM2_80_PCT = 65,
    DRV2605L_FX_TRANSITION_HUM3_60_PCT = 66,
    DRV2605L_FX_TRANSITION_HUM4_40_PCT = 67,
    DRV2605L_FX_TRANSITION_HUM5_20_PCT = 68,
    DRV2605L_FX_TRANSITION_HUM6_10_PCT = 69,
    DRV2605L_FX_TRANSITION_RAMP_DOWN_LONG_SMOOTH1_100TO0_PCT = 70,
    DRV2605L_FX_TRANSITION_RAMP_DOWN_LONG_SMOOTH2_100TO0_PCT = 71,
    DRV2605L_FX_TRANSITION_RAMP_DOWN_MEDIUM_SMOOTH1_100TO0_PCT = 72,
    DRV2605L_FX_TRANSITION_RAMP_DOWN_MEDIUM_SMOOTH2_100TO0_PCT = 73,
    DRV2605L_FX_TRANSITION_RAMP_DOWN_SHORT_SMOOTH1_100TO0_PCT = 74,
    DRV2605L_FX_TRANSITION_RAMP_DOWN_SHORT_SMOOTH2_100TO0_PCT = 75,
    DRV2605L_FX_TRANSITION_RAMP_DOWN_LONG_SHARP1_100TO0_PCT = 76,
    DRV2605L_FX_TRANSITION_RAMP_DOWN_LONG_SHARP2_100TO0_PCT = 77,
    DRV2605L_FX_TRANSITION_RAMP_DOWN_MEDIUM_SHARP1_100TO0_PCT = 78,
    DRV2605L_FX_TRANSITION_RAMP_DOWN_MEDIUM_SHARP2_100TO0_PCT = 79,
    DRV2605L_FX_TRANSITION_RAMP_DOWN_SHORT_SHARP1_100TO0_PCT = 80,
    DRV2605L_FX_TRANSITION_RAMP_DOWN_SHORT_SHARP2_100TO0_PCT = 81,
    DRV2605L_FX_TRANSITION_RAMP_UP_LONG_SMOOTH1_0TO100_PCT = 82,
    DRV2605L_FX_TRANSITION_RAMP_UP_LONG_SMOOTH2_0TO100_PCT = 83,
    DRV2605L_FX_TRANSITION_RAMP_UP_MEDIUM_SMOOTH1_0TO100_PCT = 84,
    DRV2605L_FX_TRANSITION_RAMP_UP_MEDIUM_SMOOTH2_0TO100_PCT = 85,
    DRV2605L_FX_TRANSITION_RAMP_UP_SHORT_SMOOTH1_0TO100_PCT = 86,
    DRV2605L_FX_TRANSITION_RAMP_UP_SHORT_SMOOTH2_0TO100_PCT = 87,
    DRV2605L_FX_TRANSITION_RAMP_UP_LONG_SHARP1_0TO100_PCT = 88,
    DRV2605L_FX_TRANSITION_RAMP_UP_LONG_SHARP2_0TO100_PCT = 89,
    DRV2605L_FX_TRANSITION_RAMP_UP_MEDIUM_SHARP1_0TO100_PCT = 90,
    DRV2605L_FX_TRANSITION_RAMP_UP_MEDIUM_SHARP2_0TO100_PCT = 91,
    DRV2605L_FX_TRANSITION_RAMP_UP_SHORT_SHARP1_0TO100_PCT = 92,
    DRV2605L_FX_TRANSITION_RAMP_UP_SHORT_SHARP2_0TO100_PCT = 93,
    DRV2605L_FX_TRANSITION_RAMP_DOWN_LONG_SMOOTH1_50TO0_PCT = 94,
    DRV2605L_FX_TRANSITION_RAMP_DOWN_LONG_SMOOTH2_50TO0_PCT = 95,
    DRV2605L_FX_TRANSITION_RAMP_DOWN_MEDIUM_SMOOTH1_50TO0_PCT = 96,
    DRV2605L_FX_TRANSITION_RAMP_DOWN_MEDIUM_SMOOTH2_50TO0_PCT = 97,
    DRV2605L_FX_TRANSITION_RAMP_DOWN_SHORT_SMOOTH1_50TO0_PCT = 98,
    DRV2605L_FX_TRANSITION_RAMP_DOWN_SHORT_SMOOTH2_50TO0_PCT = 99,
    DRV2605L_FX_TRANSITION_RAMP_DOWN_LONG_SHARP1_50TO0_PCT = 100,
    DRV2605L_FX_TRANSITION_RAMP_DOWN_LONG_SHARP2_50TO0_PCT = 101,
    DRV2605L_FX_TRANSITION_RAMP_DOWN_MEDIUM_SHARP1_50TO0_PCT = 102,
    DRV2605L_FX_TRANSITION_RAMP_DOWN_MEDIUM_SHARP2_50TO0_PCT = 103,
    DRV2605L_FX_TRANSITION_RAMP_DOWN_SHORT_SHARP1_50TO0_PCT = 104,
    DRV2605L_FX_TRANSITION_RAMP_DOWN_SHORT_SHARP2_50TO0_PCT = 105,
    DRV2605L_FX_TRANSITION_RAMP_UP_LONG_SMOOTH_10TO50_PCT = 106,
    DRV2605L_FX_TRANSITION_RAMP_UP_LONG_SMOOTH_20TO50_PCT = 107,
    DRV2605L_FX_TRANSITION_RAMP_UP_MEDIUM_SMOOTH_10TO50_PCT = 108,
    DRV2605L_FX_TRANSITION_RAMP_UP_MEDIUM_SMOOTH_20TO50_PCT = 109,
    DRV2605L_FX_TRANSITION_RAMP_UP_SHORT_SMOOTH_10TO50_PCT = 110,
    DRV2605L_FX_TRANSITION_RAMP_UP_SHORT_SMOOTH_20TO50_PCT = 111,
    DRV2605L_FX_TRANSITION_RAMP_UP_LONG_SHARP_10TO50_PCT = 112,
    DRV2605L_FX_TRANSITION_RAMP_UP_LONG_SHARP_20TO50_PCT = 113,
    DRV2605L_FX_TRANSITION_RAMP_UP_MEDIUM_SHARP_10TO50_PCT = 114,
    DRV2605L_FX_TRANSITION_RAMP_UP_MEDIUM_SHARP_20TO50_PCT = 115,
    DRV2605L_FX_TRANSITION_RAMP_UP_SHORT_SHARP_10TO50_PCT = 116,
    DRV2605L_FX_TRANSITION_RAMP_UP_SHORT_SHARP_20TO50_PCT = 117,
    DRV2605L_FX_SMOOTH_HUM1_NO_KICK_OR_BRAKE_PULSE_50_PCT = 119,
    DRV2605L_FX_SMOOTH_HUM2_NO_KICK_OR_BRAKE_PULSE_40_PCT = 120,
    DRV2605L_FX_SMOOTH_HUM3_NO_KICK_OR_BRAKE_PULSE_30_PCT = 121,
    DRV2605L_FX_SMOOTH_HUM4_NO_KICK_OR_BRAKE_PULSE_20_PCT = 122,
    DRV2605L_FX_SMOOTH_HUM5_NO_KICK_OR_BRAKE_PULSE_10_PCT = 123,
    DRV2605L_FX_DONT_USE_THIS_LONGBUZZFORPROGRAMMATICSTOPPING_100_PCT = 118,
} drv2605l_effect_t;

#define DRV2605L_FX_FIRST DRV2605L_FX_STRONG_CLICK_100_PCT
#define DRV2605L_FX_LAST  DRV2605L_FX_SMOOTH_HUM5_NO_KICK_OR_BRAKE_PULSE_10_PCT
