robinrehbein/tangara/firmware-s31-test/f_firmware_copy/main/ui.h

/* Copyright 2026 Nano-Player-Projekt
 * SPDX-License-Identifier: GPL-3.0-only */
#pragma once
#include "lvgl.h"
/** Baut die Oberfläche (Statusleiste, Liste, "Wird gespielt") und einen Timer, der das Modell abfragt. */
void ui_start(lv_display_t *disp);
