robinrehbein/tangara/(commit log)

2026-10-04 Konzeptdokument mit Zielen, Entscheidungen und offenen Punkten
    Claude-Session: https://claude.ai/code/session_01JifvE6gExGmwsJWDpfRrrS
2026-10-04 Umsetzungsplan mit Einkaufsliste und Android-Emulator-App
    Die App emuliert Display und Scrollrad des Players, damit Raster,
    Haptik und Display-Größe vor dem Hardwarekauf auf dem Handy
    getestet werden können.
    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
2026-10-04 3D-Explosionsmodell, Projektregeln und Teile-Schnittstellen
    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
2026-10-04 CAD: virtuelle Python-Umgebung ignorieren
    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
2026-10-04 Einkaufsliste und Recherche zum Waveshare-Board
    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
2026-10-04 3D-Druck: CadQuery-Modelle und STLs für Prototyp und Endgerät
    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
    [distanzring.stl, innenrahmen.stl, klickrad_abdeckung.stl, klickrad_halter.stl, mitteltaste.stl, oberschale.stl, power_taste.stl, rueckschale.stl]
2026-10-04 Firmware und Klickrad-Platine: Zwischenstand (in Arbeit)
    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
    [klickrad.kicad_pcb]
2026-10-04 Firmware Phase 1: Display, Klickrad, Haptik und Scroll-Test (baut mit ESP-IDF 5.4.2)
    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
2026-10-04 Klickrad-Platine: Zwischenstand (in Arbeit)
    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
    [bauteilpositionen.csv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]
2026-10-04 Klickrad-Platine fertig (KiCad, ERC/DRC fehlerfrei); Firmware und TEILE.md abgeglichen
    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
2026-10-04 Hauptplatine: Zwischenstand (in Arbeit)
    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
    [hauptplatine.kicad_sch]
2026-10-04 Konzept: ESP32-S31 für das Endgerät, Hi-Res über Klinke und USB-C
    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
2026-10-04 TEILE.md: Chips der Hauptplatine festgelegt
    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
2026-10-04 Zwischenstand Platinen und Firmware (in Arbeit)
    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
2026-10-04 Firmware: Klickrad-Treiber AT42QT2120 und DRV2605L-Einstellungen von Tangara übernommen, GPL-3.0; Portierungsanalyse
    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
2026-10-04 Zwischenstand vor Pause: Klickrad v2 und Hauptplatine (unvollständig)
    Beide Pakete wurden auf Wunsch angehalten. Klickrad v1 (MPR121) ist der
    letzte fertige Stand der Klickrad-Platine in der Historie.
    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
    [hauptplatine.kicad_sch, klickrad-abdeckung.kicad_pcb, klickrad.kicad_pcb, klickrad.kicad_sch, routed.kicad_pcb]
2026-10-04 Dünnbau-Studie: Ziel 8,5 mm, 2,06"-Display, flache Bauteile; TEILE.md angepasst
    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
2026-10-04 Platinen: Zwischenstand (in Arbeit)
    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
    [hauptplatine.kicad_sch, klickrad.kicad_pcb, klickrad.kicad_sch, routed.kicad_pcb]
2026-10-04 Gehäuse Endgerät v2: 40 × 90 × 8,5 mm, Rahmen, Rückwand, Zuschnitt-DXF für Front und Klickrad-Abdeckung
    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
    [frontplatte.dxf, frontplatte.stl, klickrad_abdeckung.dxf, klickrad_abdeckung.stl, power_taste.stl, rahmen.stl, rueckwand.stl, rueckwand_fr4.dxf]
2026-10-04 Zwischenstand Platinen und S31-Test (in Arbeit)
    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
2026-10-04 Hauptplatine und S31-Test: Zwischenstand (in Arbeit)
    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
    [hauptplatine.kicad_sch, hauptplatine_BOM_PCBWay.csv, ungeroutet.kicad_pcb]
2026-10-04 Hauptplatine: platziert, nicht geroutet; Befund in KONZEPT.md
    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
    [klickrad.kicad_pcb, klickrad.kicad_sch, routed.kicad_pcb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]
2026-10-04 Klickrad v2 und S31-Test: Zwischenstand (in Arbeit)
    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
    [klickrad.kicad_pcb, routed.kicad_pcb]
2026-10-04 Entscheidung: Gerät größer und dicker (ca. 44 × 100 × bis 11 mm)
    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
2026-10-04 S31-Test, Klickrad v2 und Hauptplatine: Zwischenstand (in Arbeit)
    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
2026-10-04 S31-Buildtest-Ergebnis und offene Punkte dokumentiert
    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
    [klickrad.kicad_pcb, routed.kicad_pcb]
2026-10-04 Zwischenstand Klickrad v2 und Hauptplatine
    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
    [klickrad.kicad_pcb]
2026-10-04 Dickenziel auf bis 10 mm festgelegt
    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
2026-10-04 Klickrad v2 fertig: TEILE.md und Problemliste aktualisiert
    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
    [bauteilpositionen.csv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]
2026-10-04 Hauptplatine geroutet: Doku, Maße und Problemliste aktualisiert
    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
    [cont6_run13_importiert.kicad_pcb, final_nach_maze_vor_polish.kicad_pcb, hauptplatine.kicad_sch, hauptplatine_BOM_PCBWay.csv, pre_mit_ring.kicad_pcb, pre_ohne_ring.kicad_pcb, run14.dsn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]
2026-10-04 Gehäuse v3 (44x100x10 mm) und Problemliste
    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
    [frontplatte.dxf, frontplatte.stl, klickrad_abdeckung.dxf, klickrad_abdeckung.stl, rahmen.stl, rueckwand.stl]
2026-10-05 Hauptplatine Rev. 3b: Review-Fixes (B1-B3, H1, H4, H5, H7, H8), Doku
    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
    [hauptplatine.kicad_sch, hauptplatine_BOM_PCBWay.csv, stand_vor_review_fixes.kicad_pcb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]
2026-10-05 Gehäuse v3 an Rev. 3b angepasst, Problemliste
    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
    [frontplatte.dxf, klickrad_abdeckung.dxf, rahmen_einsatz.stl, rueckwand.stl]
2026-10-05 Firmware: Klickrad-v2-Konvention, Endgerät-Board-Profil, Host-Test
    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
2026-10-05 Klickrad J1 auf J21-Landmuster, neu geroutet; TEILE-Nachtrag
    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
    [bauteilpositionen.csv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]
