robinrehbein/tangara/(notices)

Notices in the files:
hardware/pcb/klickrad/klickrad.kicad_sch:
AT42QT2120 (0x1C, Wheel) + DRV2605L (0x5A, LRA), Beschaltung nach Tangara-Faceplate (CERN-OHL-S-2.0, cool tech zone)
